julien-dubuc/Compliant-Gripper-Etextiles/gripper.webp

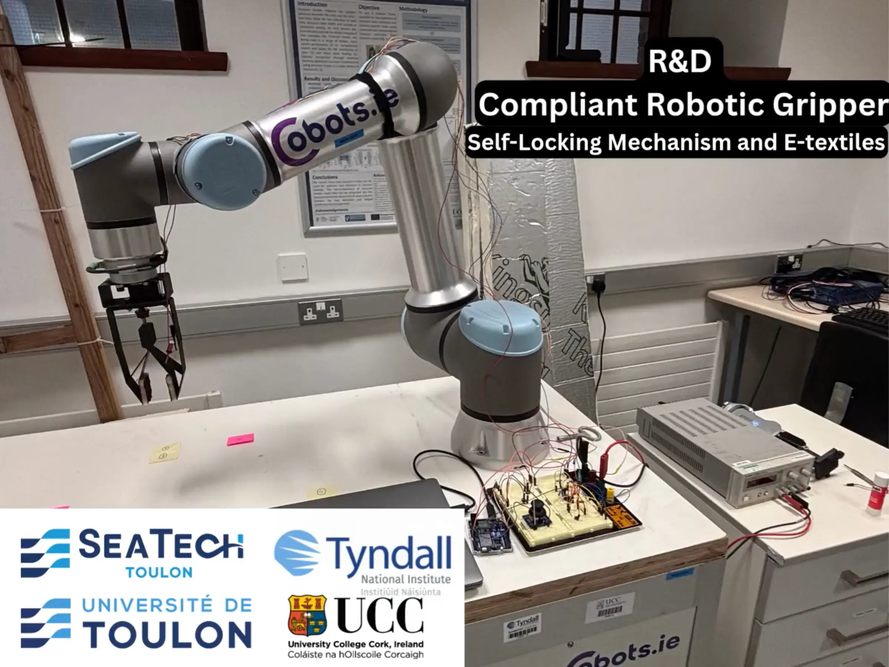
gripper.webp
