julien-dubuc/Compliant-Gripper-Etextiles/Weekly reports/11_Weekly _Report_04_08.pptx

## Development of an Underactuated Gripper for Soft Robotics with Tactile Capabilities Weekly Report

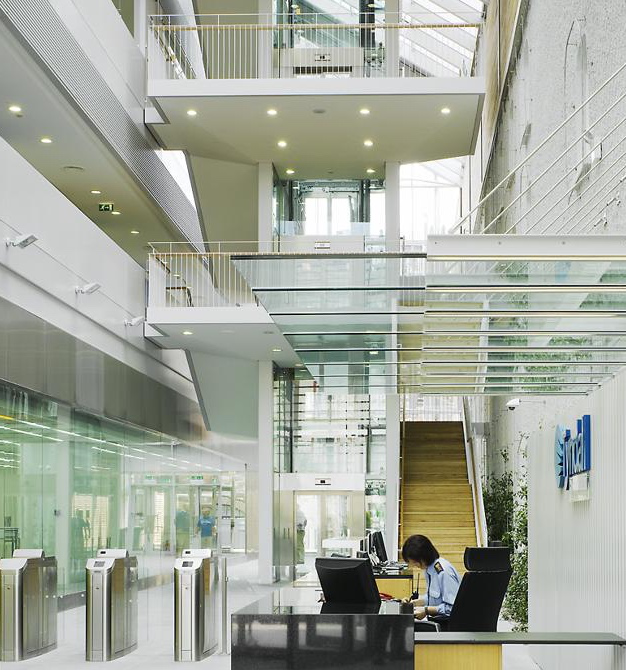
[picture p2: figure]

Julien Dubuc - BE at SeaTech (University of Toulon)

## Project Objectives (provisional)

- Objective 1 - Characterise e-textile sensing materials for robotic tactile applications
- Characterise the electromechanical response of selected e-textile materials under controlled loading conditions, with a focus on the relationship between applied force and electrical resistance. Assess repeatability, sensitivity, hysteresis, drift and practical suitability for integration into robotic tactile sensing systems.
- Objective 2 - Develop an e-textile tactile sensing glove for a robotic gripper/finger
- Design and fabricate a tactile sensing layer or glove for a robotic gripper finger using the characterised e-textile material. The sensing element should be mechanically robust, easy to mount, and capable of detecting contact and relative force changes during object interaction.
- Objective 3 - Build and validate a single-actuator robotic gripper prototype
- Produce a working single-actuator gripper that can close, lock and release objects consistently. The hardware should be clean, maintainable and suitable for repeated testing, with a short assembly, wiring and calibration guide provided.
- Objective 4 - Define and execute the experimental test protocol
- Define a small but representative test set using common objects with different shapes, sizes, stiffness and surface properties. Establish clear success criteria, such as successful grasp, stable hold, release reliability, tactile response consistency and energy use, and execute repeated trials under controlled conditions.

## Work Completed

- - Progress on the report & presentation

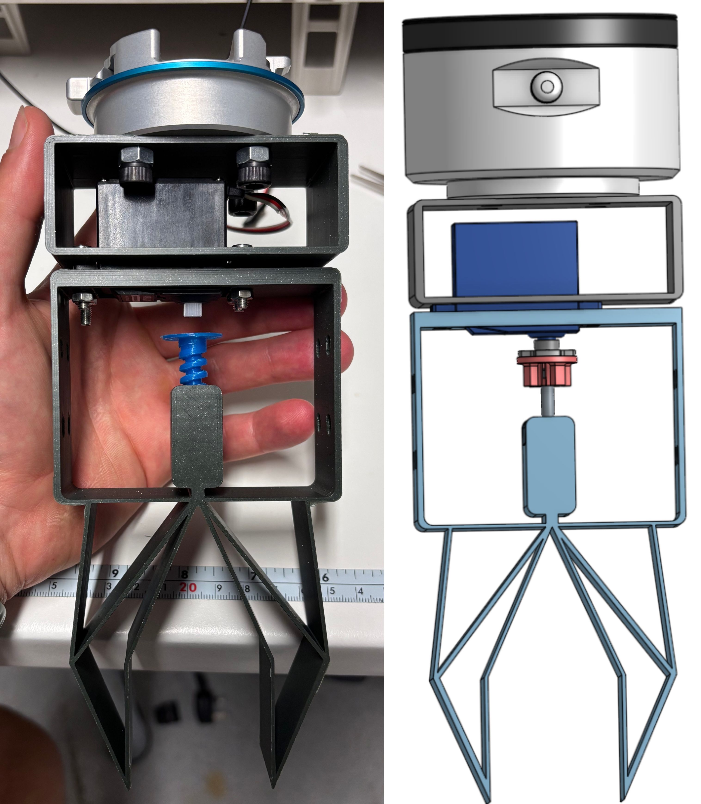
[picture p3: figure]

Design to attach the gripper to the robotic arm

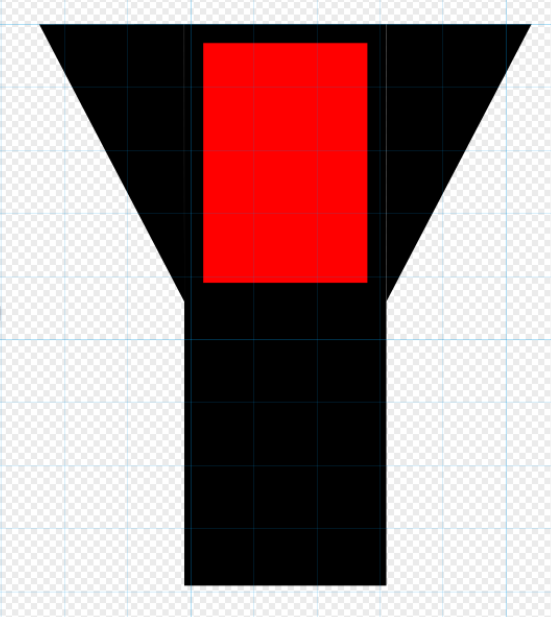
[picture p4: figure]
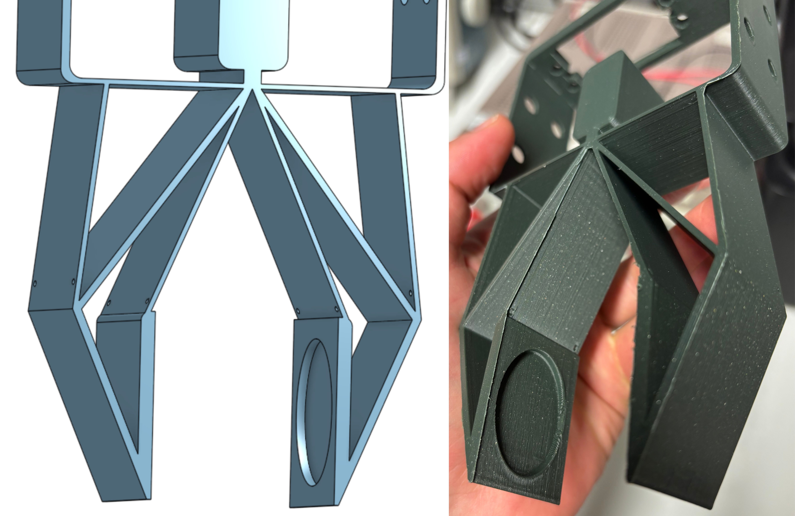
[picture p5: figure]

Design for gloves

2D Design of the gloves

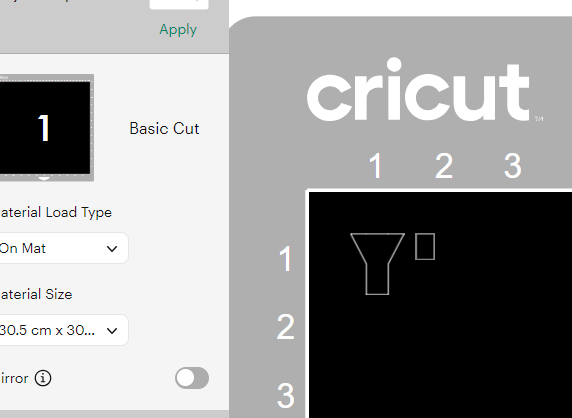
[picture p6: figure]

Cut the fabric on Cricut

## Problems/Challenges

- E-textiles
- What kind of fabric is used for the gloves? How to use the machines so I can start to build the gloves?
- Electronics for the robotic arm.
- After E-textiles, test the new idea design (if enough time)
- What do I need to do for the paper ? (Test, write sthg, create accounts on research sites, ..)

## Admin

- x

## Slide 6

Tyndall National Institute,
Lee Maltings,
Dyke Parade,
Cork,
Ireland.
T12 R5CP
t: +353 21 490 4177
e: info@tyndall.ie
tyndall.ie
@tyndall-national-institute
@TyndallInstitut
@tyndall_institute
@TyndallInstitute
