julien-dubuc/Compliant-Gripper-Etextiles/Weekly reports/10_Weekly _Report_29_07.pptx

## Development of a Bioinspired Gripper for Soft Robotics with Tactile Capabilities Weekly Report


Julien Dubuc – BE at SeaTech (University of Toulon)

## Project Objectives (provisional)

- Objective 1 - Characterise e-textile sensing materials for robotic tactile applications
- Characterise the electromechanical response of selected e-textile materials under controlled loading conditions, with a focus on the relationship between applied force and electrical resistance. Assess repeatability, sensitivity, hysteresis, drift and practical suitability for integration into robotic tactile sensing systems.
- Objective 2 - Develop an e-textile tactile sensing glove for a robotic gripper/finger
- Design and fabricate a tactile sensing layer or glove for a robotic gripper finger using the characterised e-textile material. The sensing element should be mechanically robust, easy to mount, and capable of detecting contact and relative force changes during object interaction.
- Objective 3 - Build and validate a single-actuator robotic gripper prototype
- Produce a working single-actuator gripper that can close, lock and release objects consistently. The hardware should be clean, maintainable and suitable for repeated testing, with a short assembly, wiring and calibration guide provided.
- Objective 4 - Define and execute the experimental test protocol
- Define a small but representative test set using common objects with different shapes, sizes, stiffness and surface properties. Establish clear success criteria, such as successful grasp, stable hold, release reliability, tactile response consistency and energy use, and execute repeated trials under controlled conditions.

## Work Completed

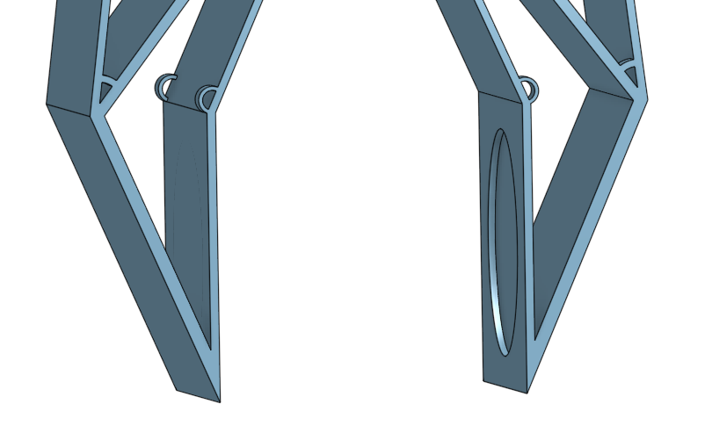
[picture p7: figure]

Idea 2: To attach the gloves to the fingers

- - Progress on the report & presentation

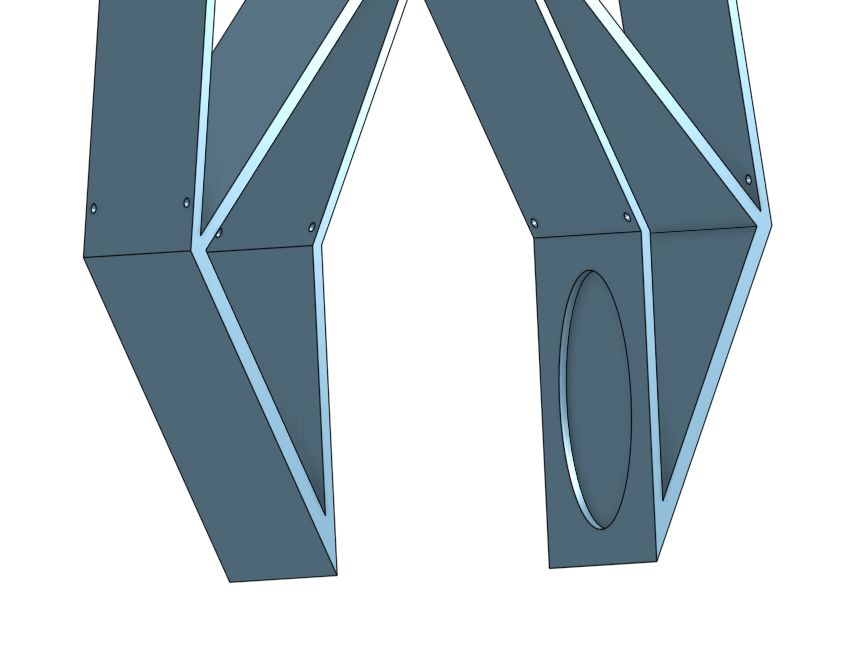
[picture p8: figure]

Idea 1: To attach the gloves to the fingers

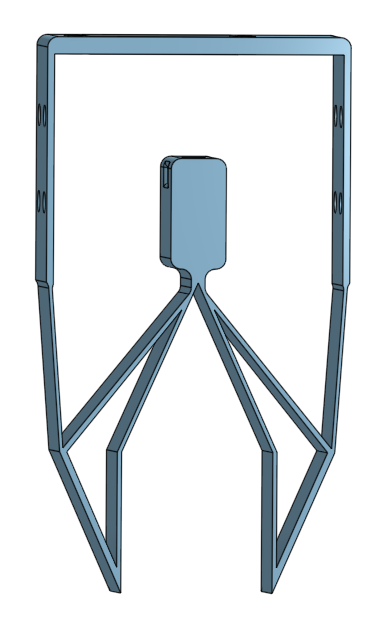
[picture p9: figure]

New idea to improve the gripper

## Problems/Challenges

- What will be the size of the wires that attach to the gripper?
- Exit Document
- Copyright on the report ? / Where do I store the data ?
- It would be great to take a photo of the gripper on the robotic arm to the first page of the report.
- Check the vocabulary in the report.

## Admin

- x

## Slide 6

Tyndall National Institute,
Lee Maltings,
Dyke Parade,
Cork,
Ireland.
T12 R5CP
t: +353 21 490 4177
e: info@tyndall.ie
tyndall.ie
@tyndall-national-institute
@TyndallInstitut
@tyndall_institute
@TyndallInstitute
