julien-dubuc/Compliant-Gripper-Etextiles/Internship Presentation EN.pdf

# Development of a Compliant Robotic Gripper

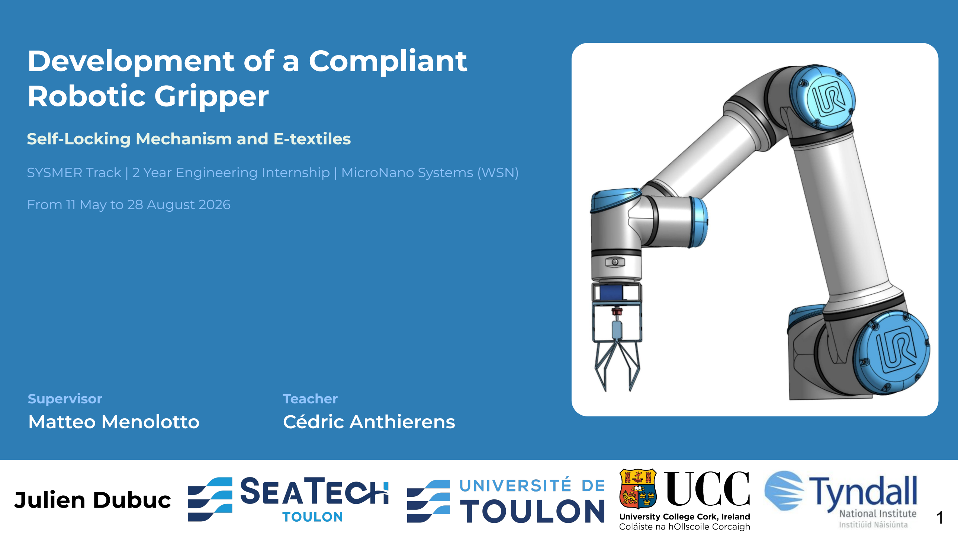
[picture p33: page 1]

Self-Locking Mechanism and E-textiles

SYSMER Track | 2 Year Engineering Internship | MicroNano Systems (WSN)

From 11 May to 28 August 2026

## Julien Dubuc

Supervisor

### Matteo Menolotto

Teacher

### Cédric Anthierens

# Problem & Goal

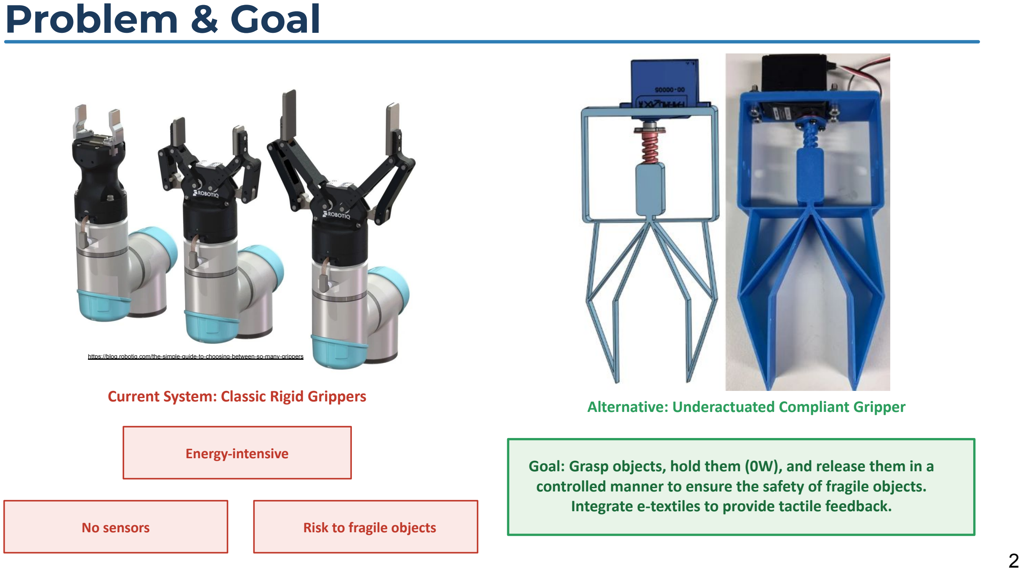
[picture p34: page 2]

Current System: Classic Rigid Grippers | Alternative: Underactuated Compliant Gripper

Energy-intensive

No sensors | Risk to fragile objects

Goal: Grasp objects, hold them (0W), and release them in a controlled manner to ensure the safety of fragile objects. Integrate e-textiles to provide tactile feedback.

https://blog.robotiq.com/the-simple-guide-to-choosing-between-so-many-grippers

# CAD Prototypes

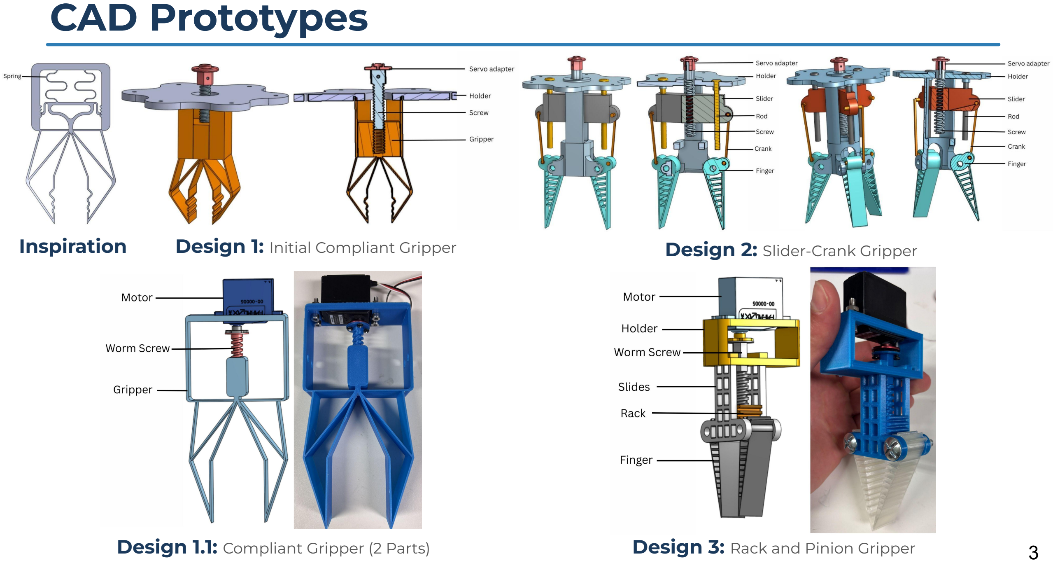
[picture p35: page 3]

Design 1: Initial Compliant Gripper

Design 1.1: Compliant Gripper (2 Parts)

Inspiration | Design 2: Slider-Crank Gripper

Design 3: Rack and Pinion Gripper

# Fabrication & Iteration

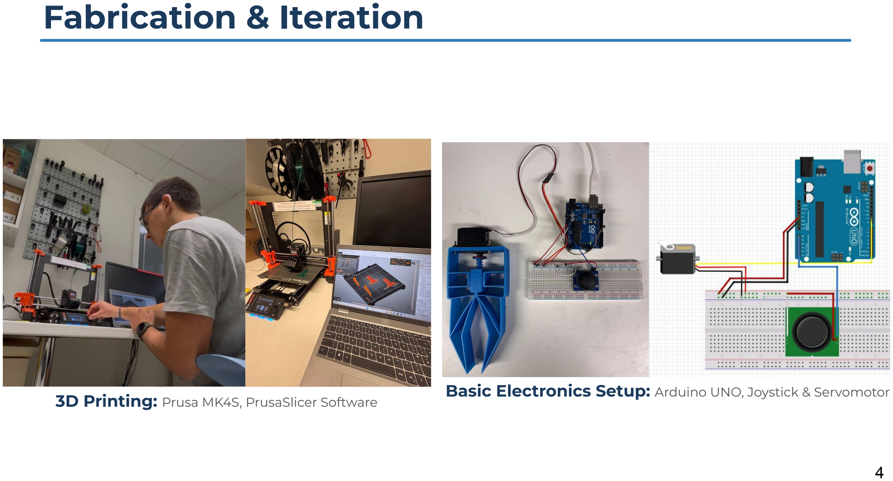
[picture p36: page 4]

3D Printing: Prusa MK4S, PrusaSlicer Software

Basic Electronics Setup: Arduino UNO, Joystick & Servomotor

# Protocol Assessment & Setup

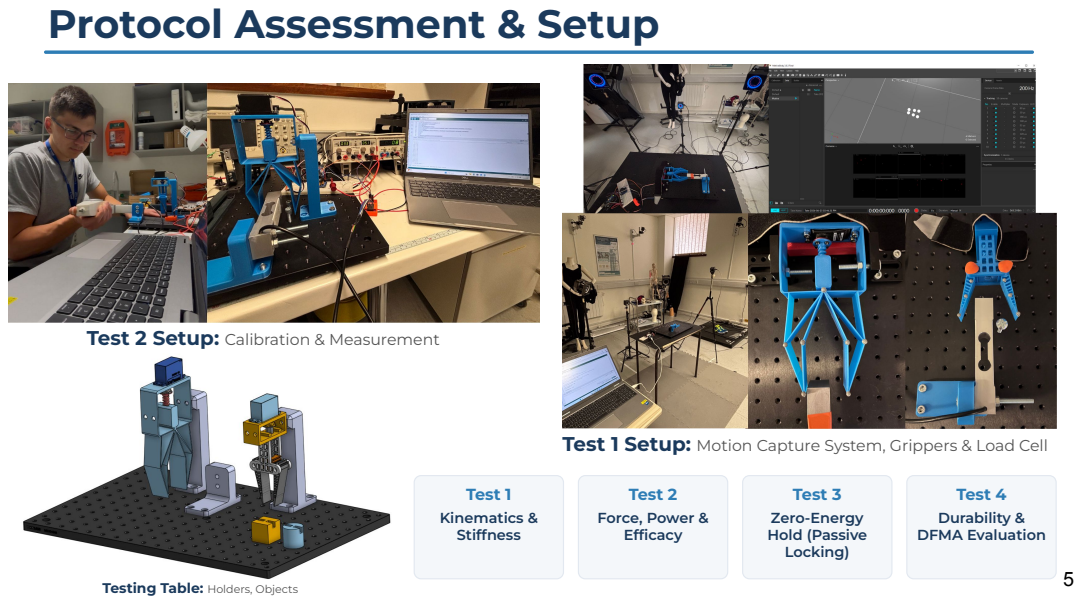
[picture p37: page 5]
Test 1 Kinematics & Stiffness; Test 2 Force, Power & Efficacy; Test 3 Zero-Energy Hold (Passive Locking); Test 4 Durability & DFMA Evaluation

Test 2 Setup: Calibration & Measurement

Test 1 Setup: Motion Capture System, Grippers & Load Cell

Testing Table: Holders, Objects

# Key Results: Test 1 & 2

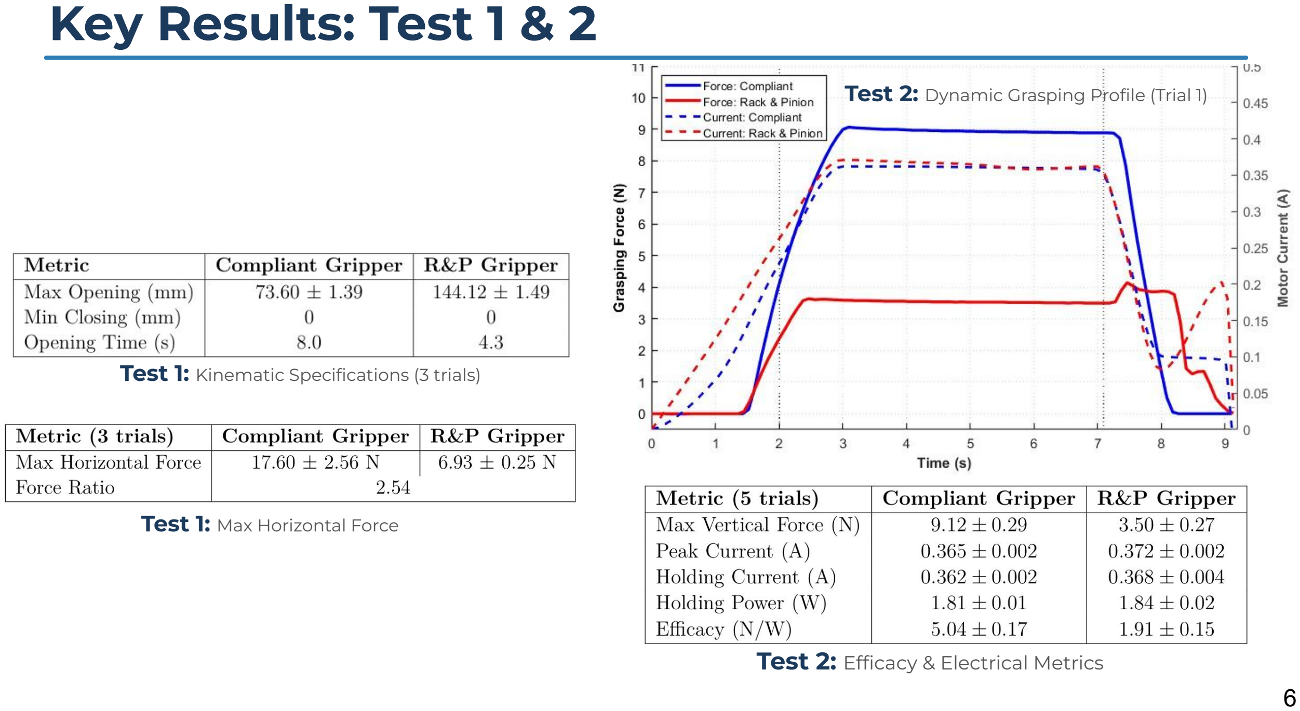
[picture p38: page 6]

Test 2: Efficacy & Electrical Metrics

Test 1: Max Horizontal Force

Test 1: Kinematic Specifications (3 trials)

Test 2: Dynamic Grasping Profile (Trial 1)

# Key Results: Test 3 & 4

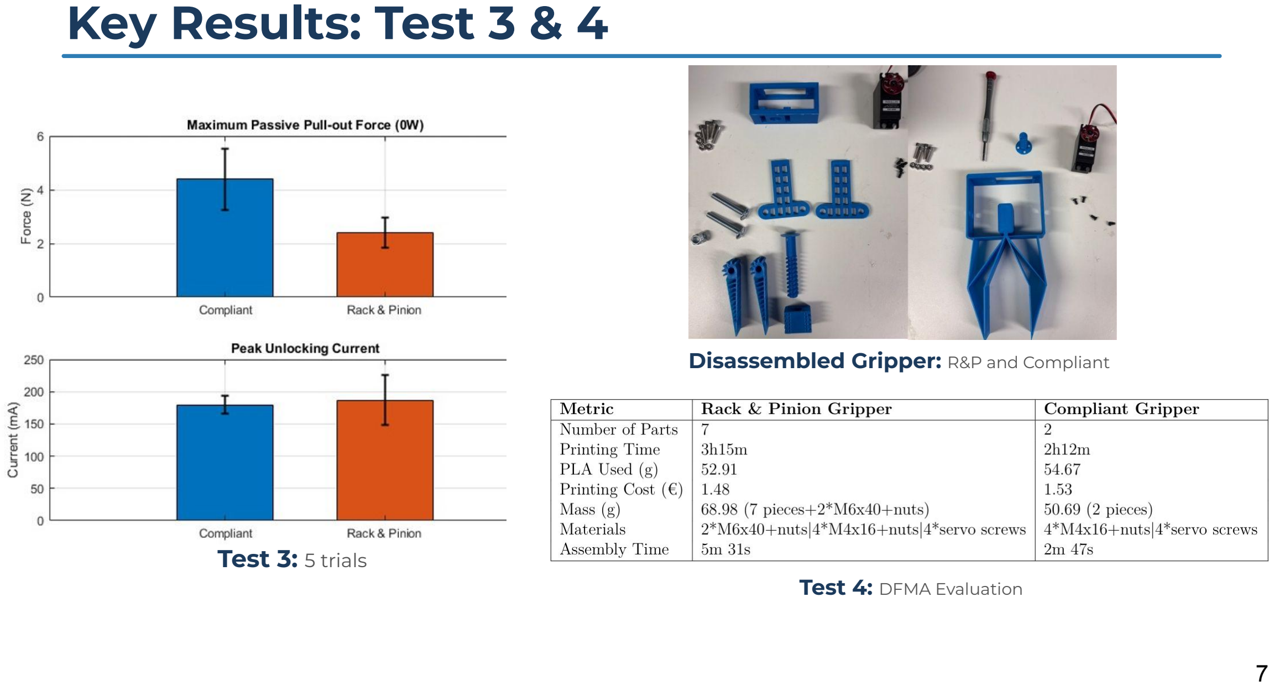
[picture p39: page 7]

Test 4: DFMA Evaluation

Test 3: 5 trials

Disassembled Gripper: R&P and Compliant

# Key Results: Compliant Gripper Optimization

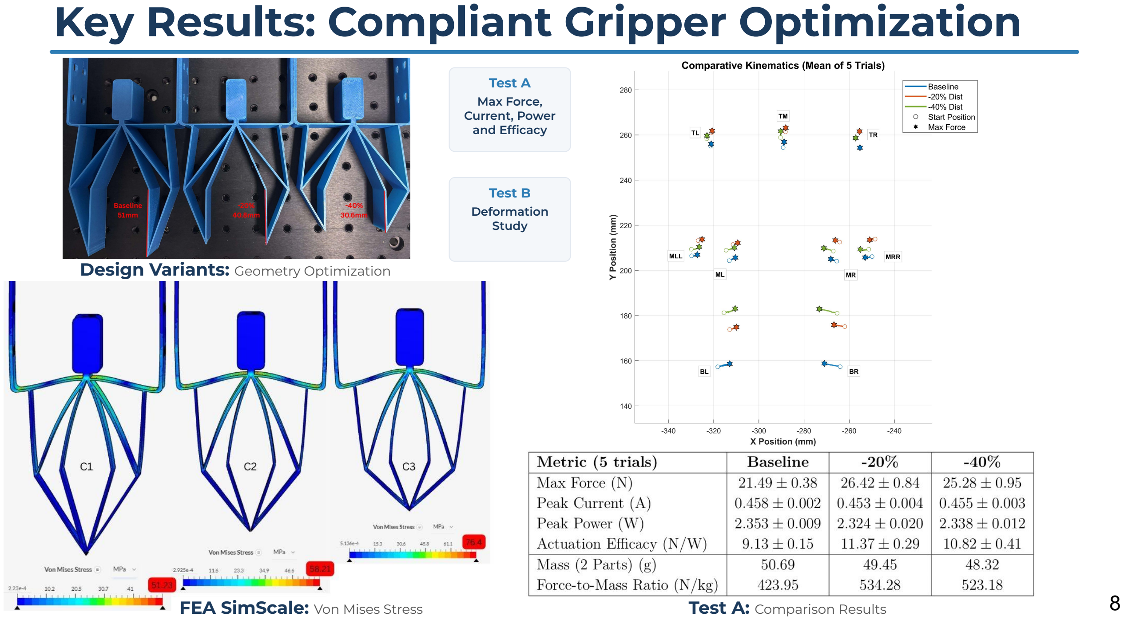
[picture p40: page 8]

Test B
Deformation
Study

Test A
Max Force,
Current, Power
and Efficacy
FEA SimScale: Von Mises Stress | Test A: Comparison Results

Design Variants: Geometry Optimization

# Key Results: Metal Transmission Optimization

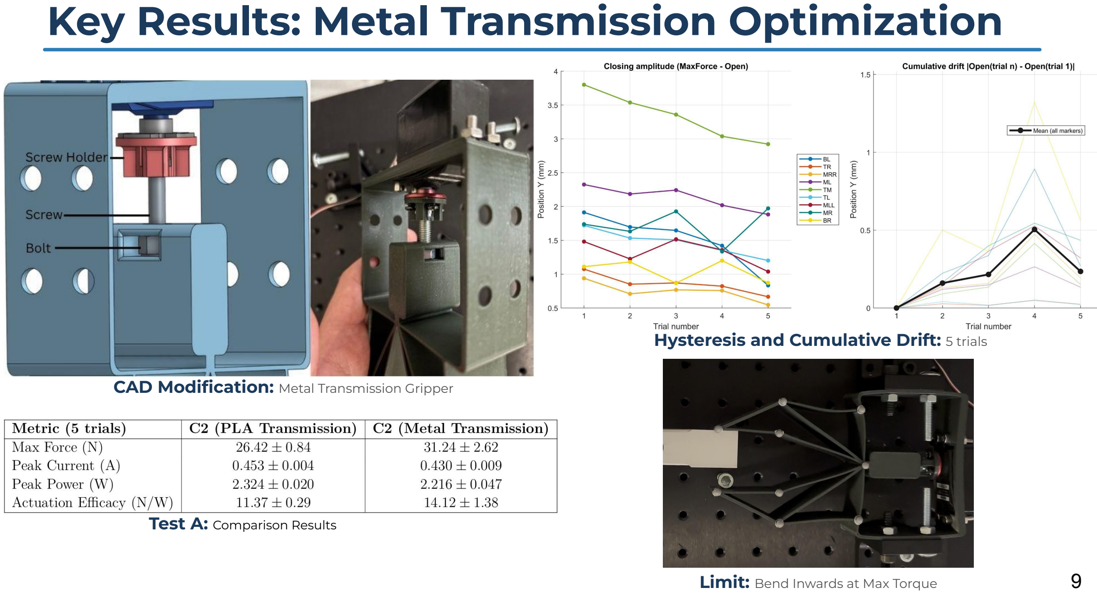
[picture p41: page 9]

Test A: Comparison Results

CAD Modification: Metal Transmission Gripper

Hysteresis and Cumulative Drift: 5 trials

Limit: Bend Inwards at Max Torque

# E-textiles & Integration

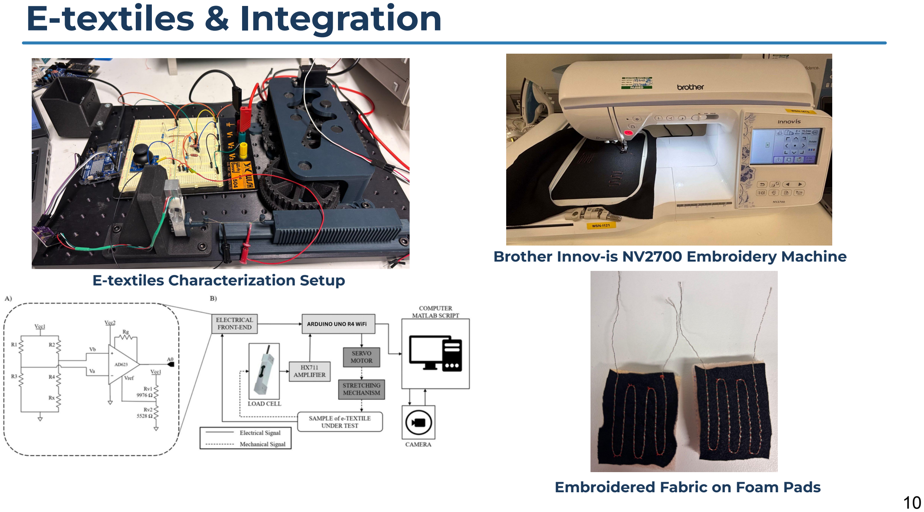
[picture p42: page 10]

E-textiles Characterization Setup

Brother Innov-is NV2700 Embroidery Machine

Embroidered Fabric on Foam Pads

# Next steps

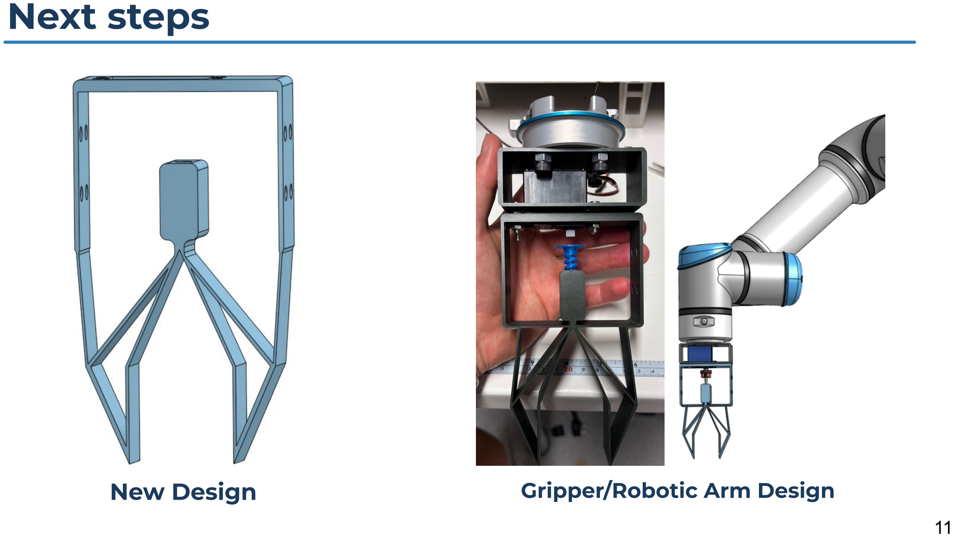
[picture p43: page 11]

New Design | Gripper/Robotic Arm Design

# Thank you Questions ?

# Appendix

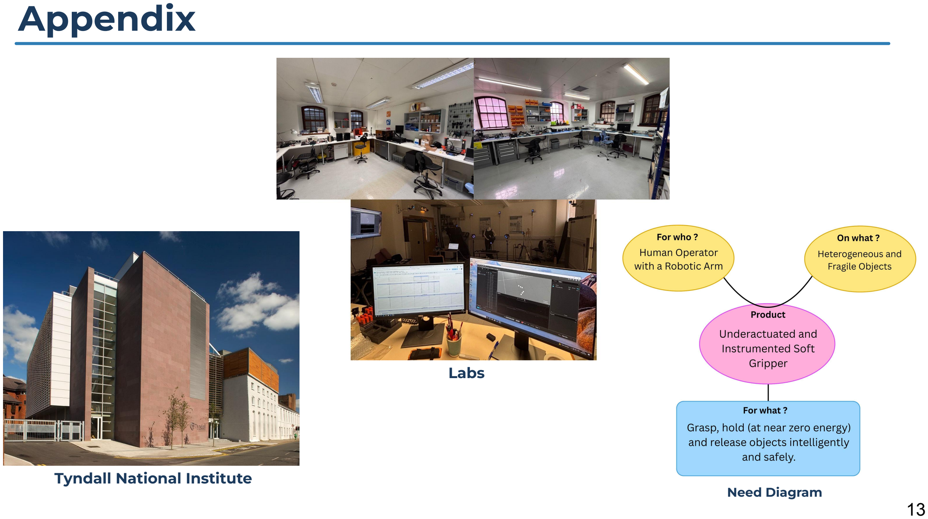
[picture p44: page 13]

Labs

Need Diagram

Tyndall National Institute

# Appendix

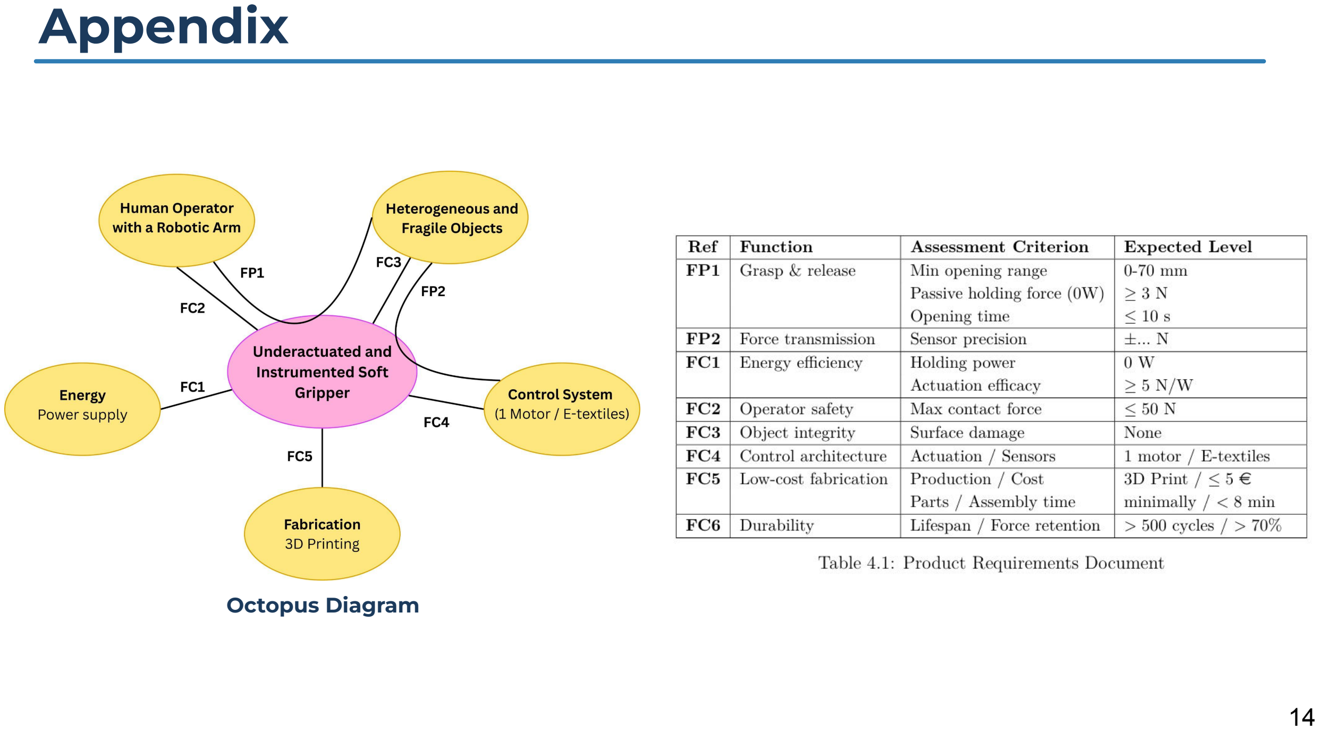
[picture p45: page 14]

Octopus Diagram

# Appendix

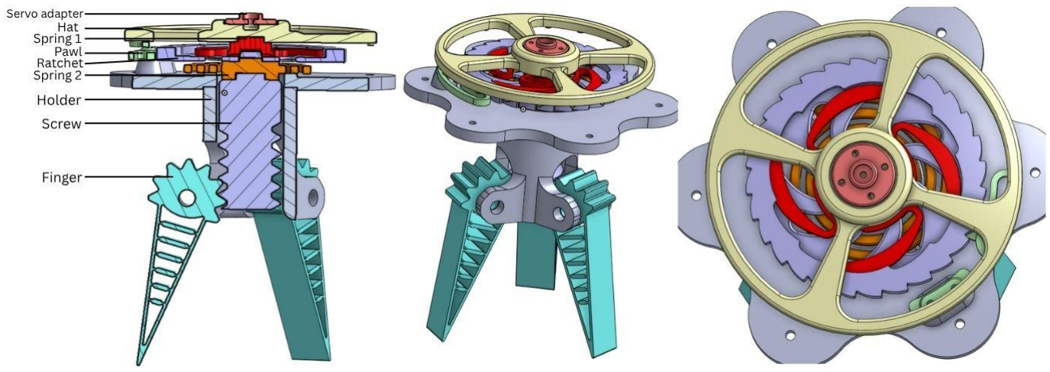
[picture p46: figure]

Previous Lab Design

# Appendix

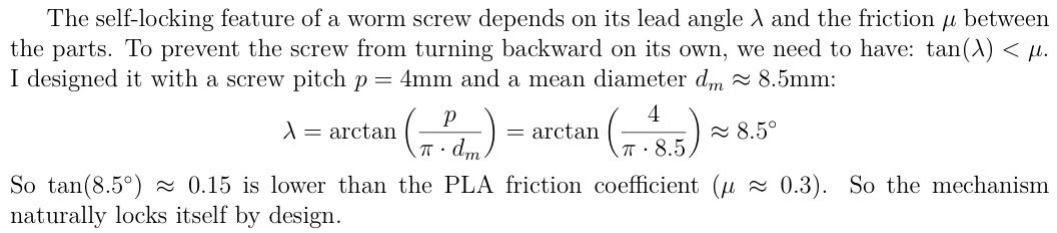
[picture p47: figure]

Self-Locking Principle

# Appendix

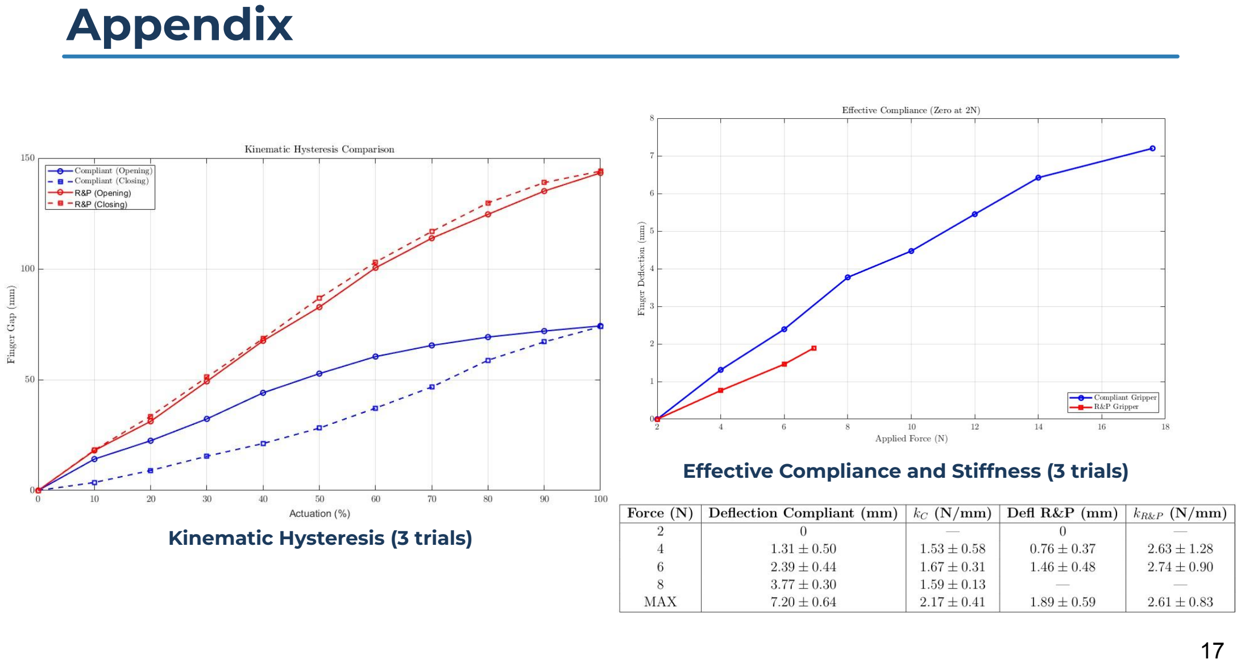
[picture p48: page 17]

Effective Compliance and Stiffness (3 trials)

Kinematic Hysteresis (3 trials)

# Appendix

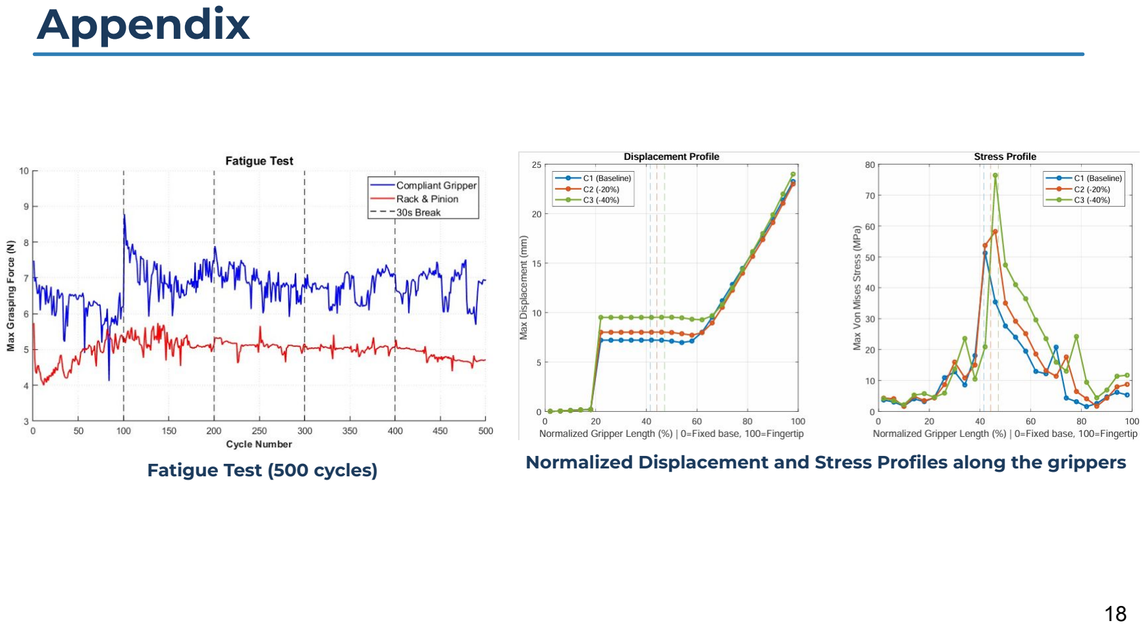
[picture p49: page 18]

Normalized Displacement and Stress Profiles along the grippers Fatigue Test (500 cycles)

# Appendix

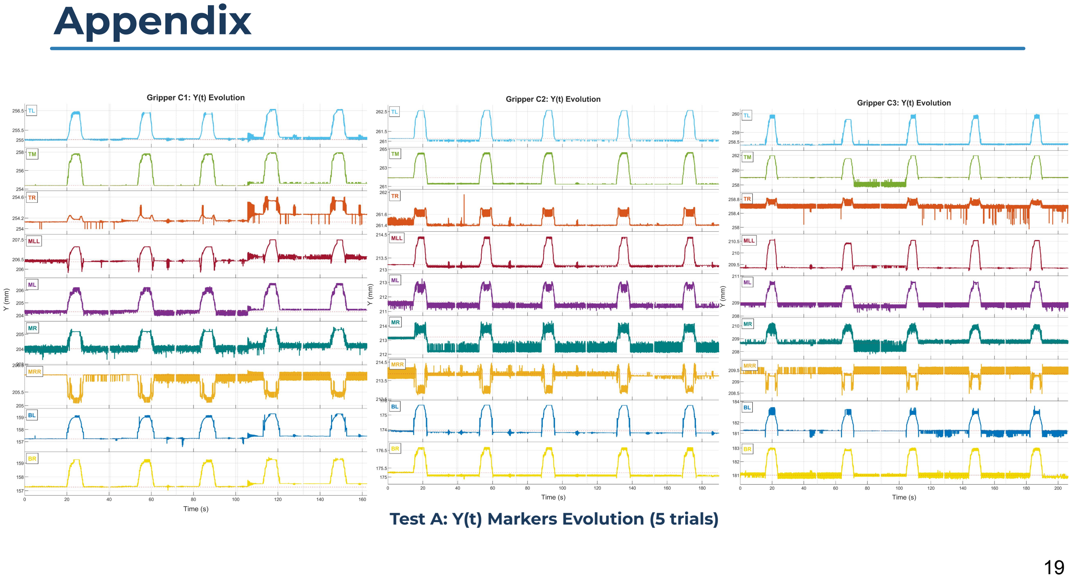
[picture p50: page 19]

Test A: Y(t) Markers Evolution (5 trials)

# Appendix

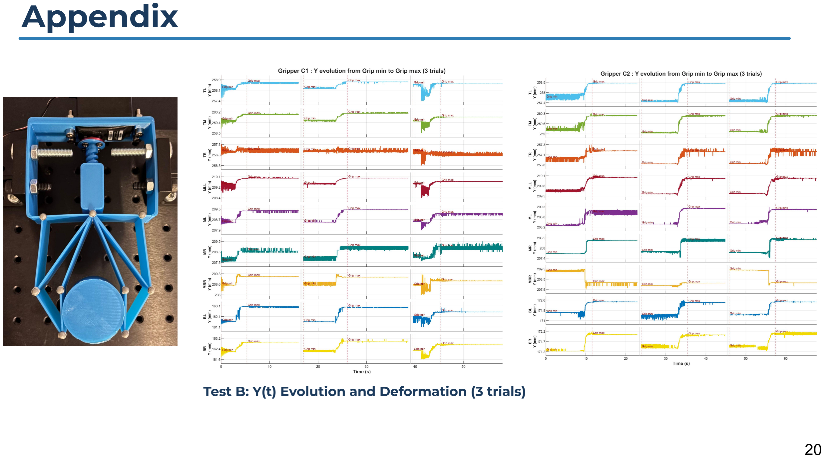
[picture p51: page 20]

Test B: Y(t) Evolution and Deformation (3 trials)

# Appendix

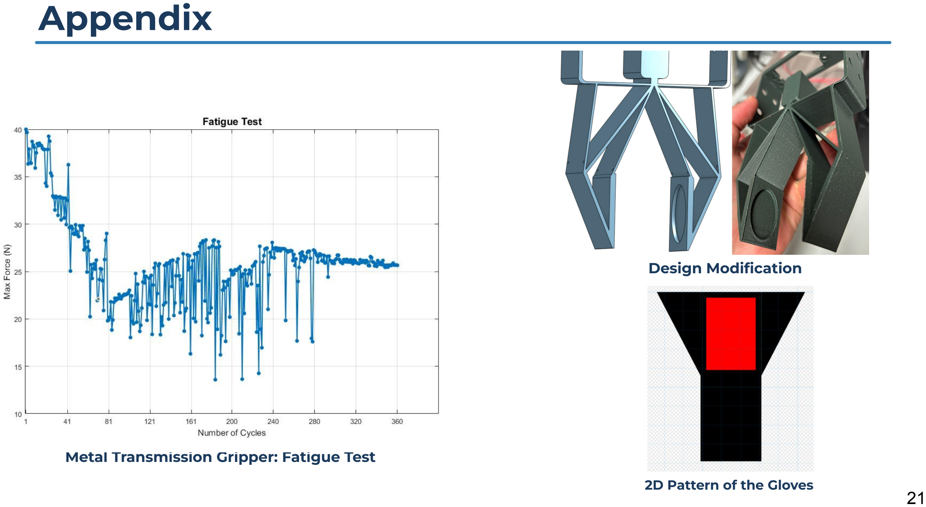
[picture p52: page 21]

Metal Transmission Gripper: Fatigue Test

2D Pattern of the Gloves

Design Modification

# Appendix

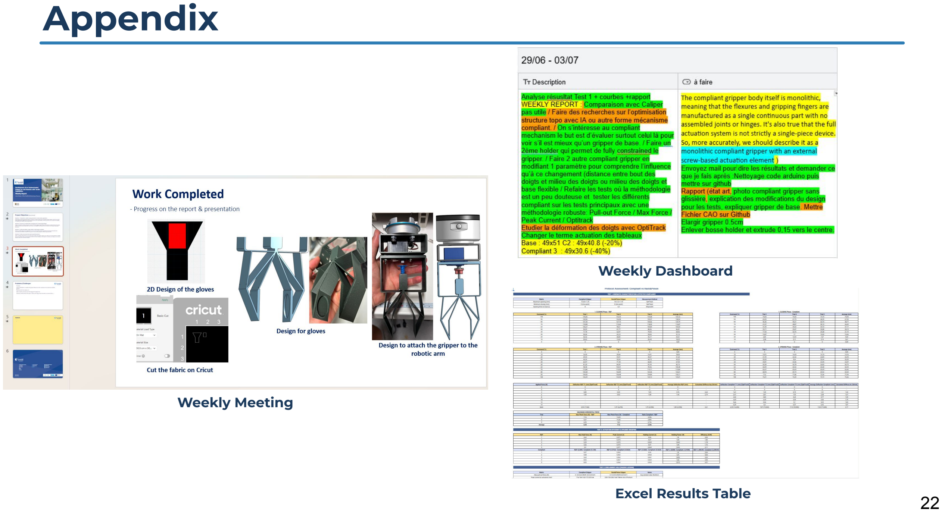
[picture p53: page 22]

Weekly Dashboard

Excel Results Table

Weekly Meeting

# Appendix

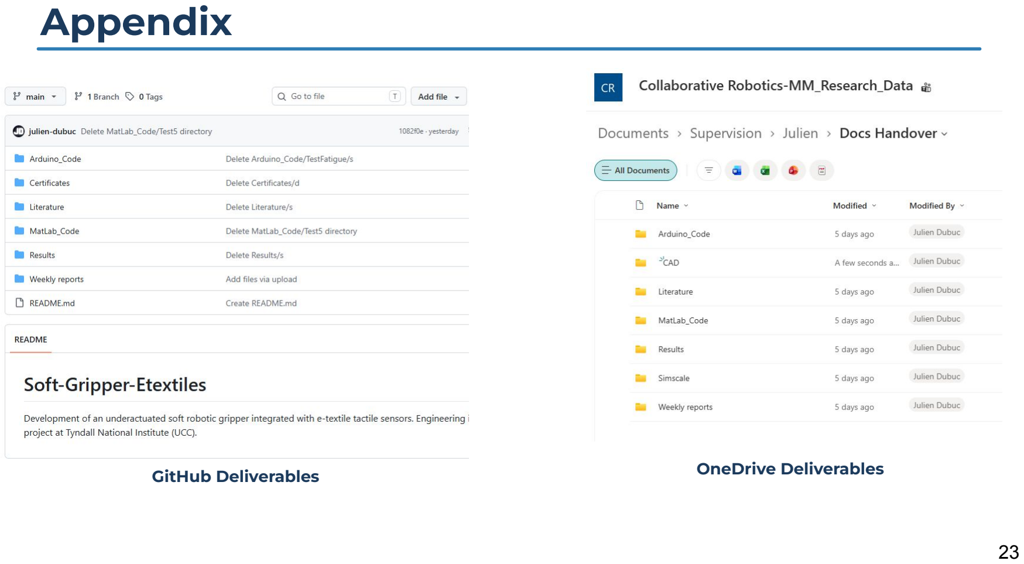
[picture p54: page 23]

GitHub Deliverables | OneDrive Deliverables
