julien-dubuc/Compliant-Gripper-Etextiles/Internship Presentation FR.pdf

# Développement d'un Gripper Robotique Souple

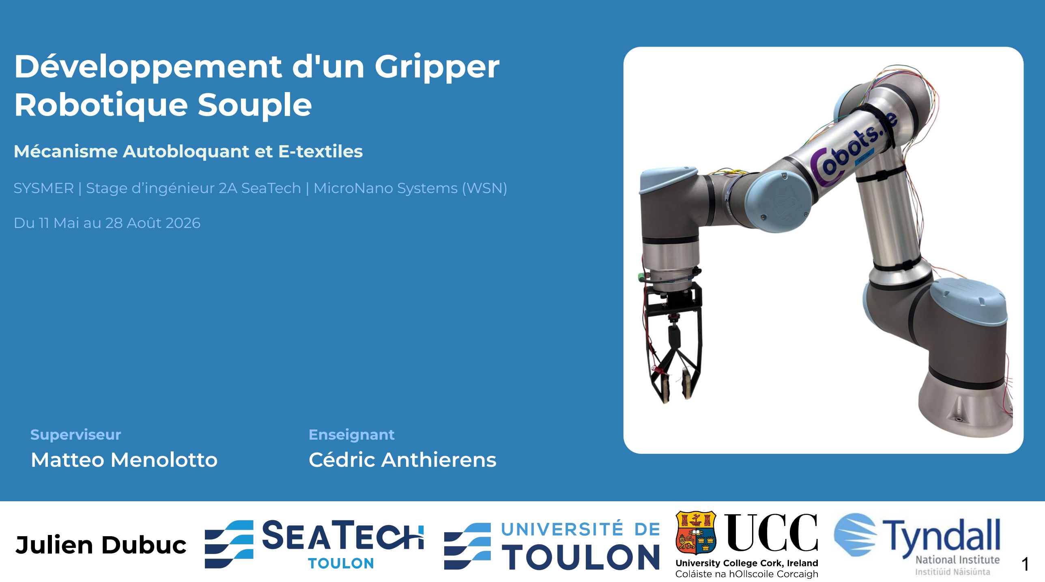
[picture p55: page 1]

Mécanisme Autobloquant et E-textiles

SYSMER | Stage d’ingénieur 2A SeaTech | MicroNano Systems (WSN)

Du 11 Mai au 28 Août 2026

## Julien Dubuc

Superviseur

### Matteo Menolotto

Enseignant

### Cédric Anthierens

# Contexte

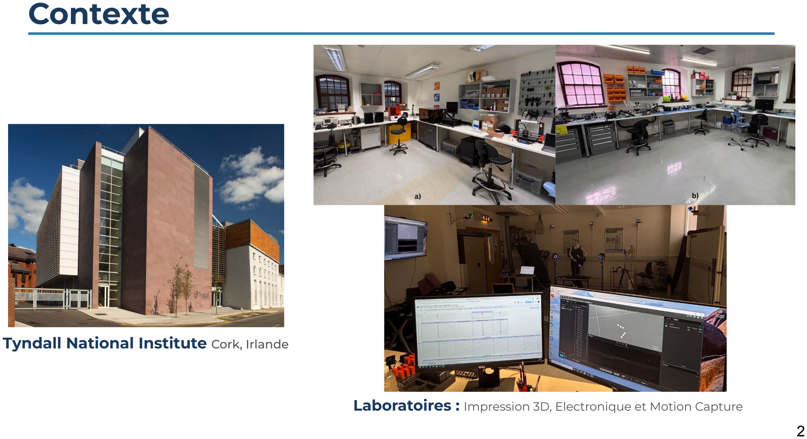
[picture p56: page 2]

### Tyndall National Institute Cork, Irlande

Laboratoires : Impression 3D, Electronique et Motion Capture

# Problème & But

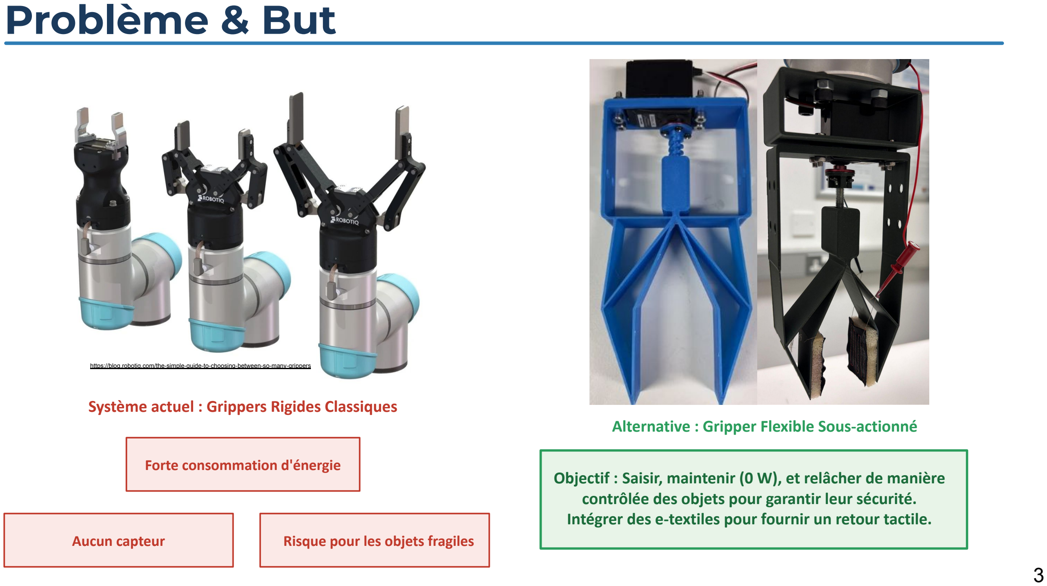
[picture p57: page 3]

Système actuel : Grippers Rigides Classiques Alternative : Gripper Flexible Sous-actionné

Forte consommation d'énergie

Aucun capteur | Risque pour les objets fragiles

Objectif : Saisir, maintenir (0 W), et relâcher de manière contrôlée des objets pour garantir leur sécurité. Intégrer des e-textiles pour fournir un retour tactile.

https://blog.robotiq.com/the-simple-guide-to-choosing-between-so-many-grippers

# Itérations CAO

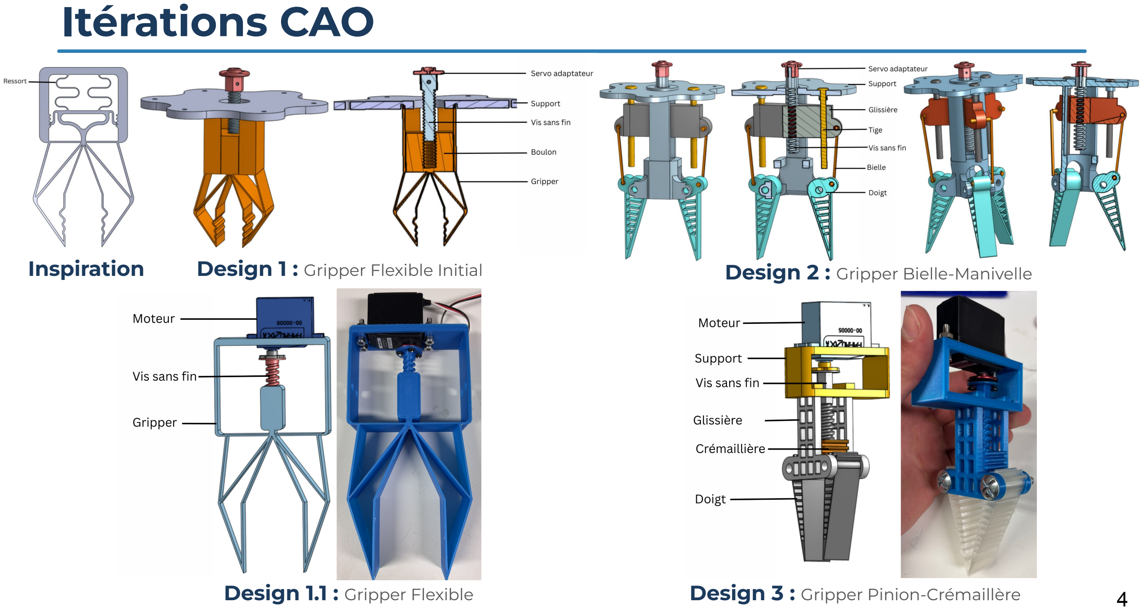
[picture p58: page 4]

Design 1 : Gripper Flexible Initial

Design 1.1 : Gripper Flexible

Inspiration | Design 2 : Gripper Bielle-Manivelle

Design 3 : Gripper Pinion-Crémaillère

# Fabrication & Itération

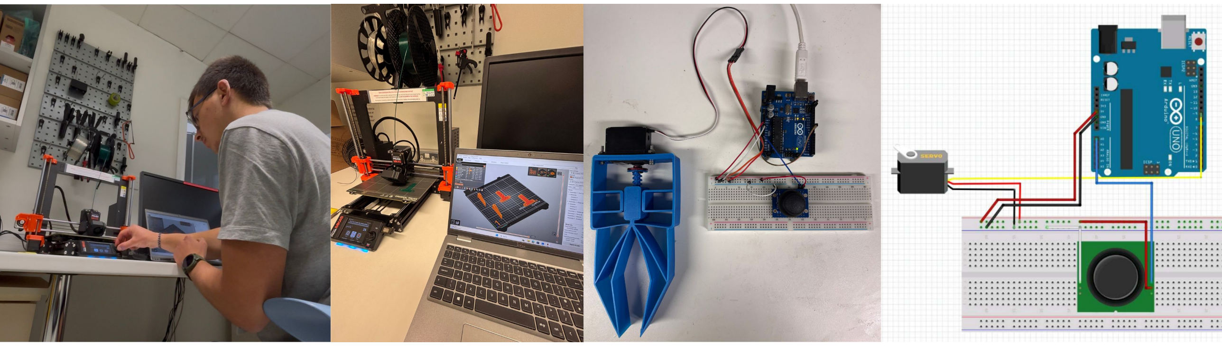
[picture p59: figure]

Impression 3D : Prusa MK4S et PrusaSlicer | Setup Électronique : Arduino UNO, Joystick et Servo

# Protocole d’Evaluation & Setup

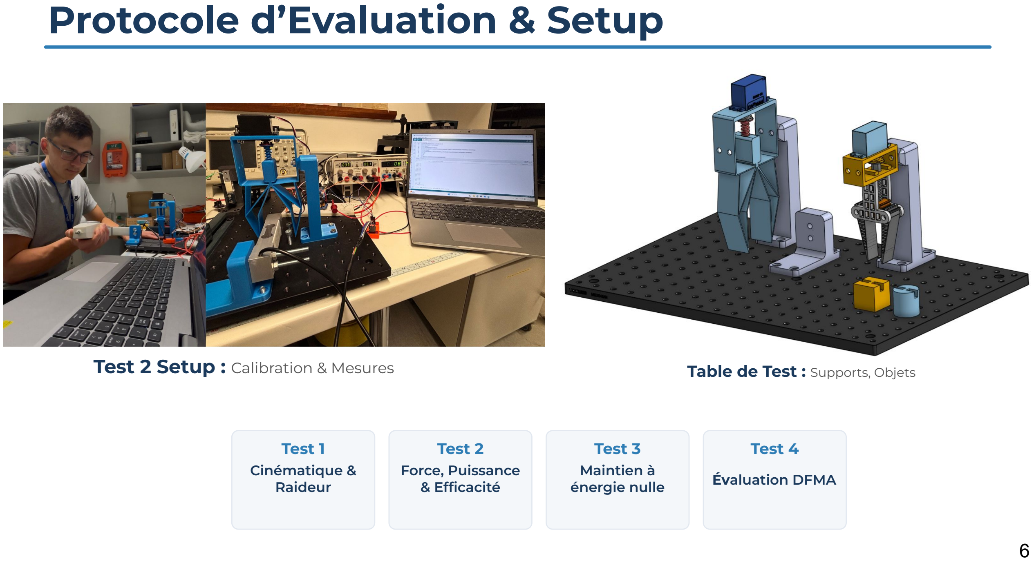
[picture p60: page 6]

Table de Test : Supports, Objets

Test 1
Cinématique &
Raideur

Test 2
Force, Puissance
& Efficacité

Test 3
Maintien à
énergie nulle

Test 4

Évaluation DFMA

Test 2 Setup : Calibration & Mesures

# Résultats Clés : Test 1 & 2

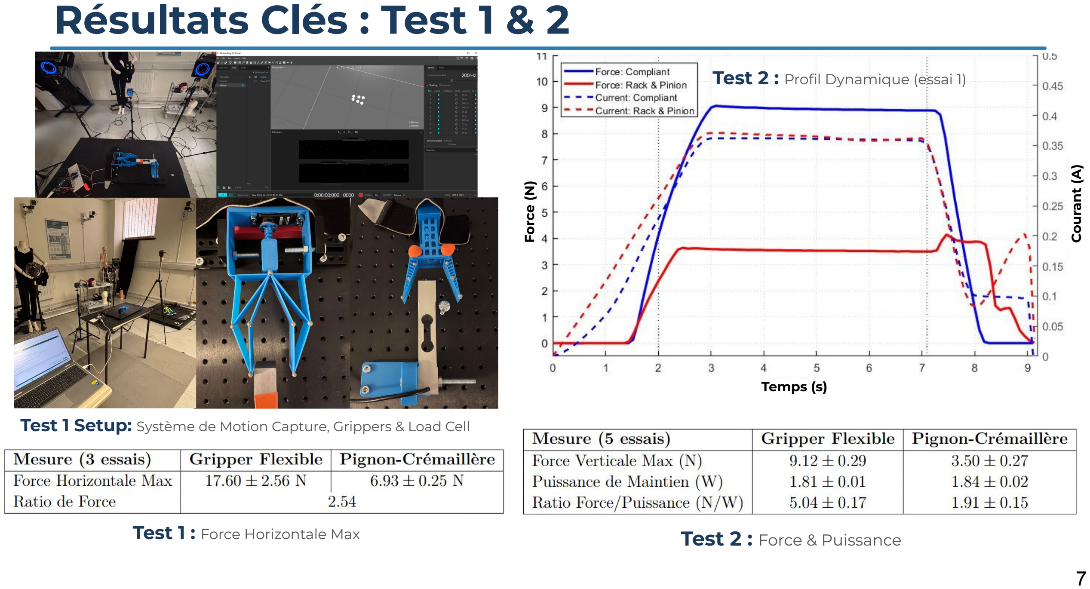
[picture p61: page 7]

Test 2 : Force & Puissance

Test 1 : Force Horizontale Max

Test 2 : Profil Dynamique (essai 1)

Test 1 Setup: Système de Motion Capture, Grippers & Load Cell

Temps (s)

Force (N)

Courant (A)

# Résultats Clés : Test 3 & 4

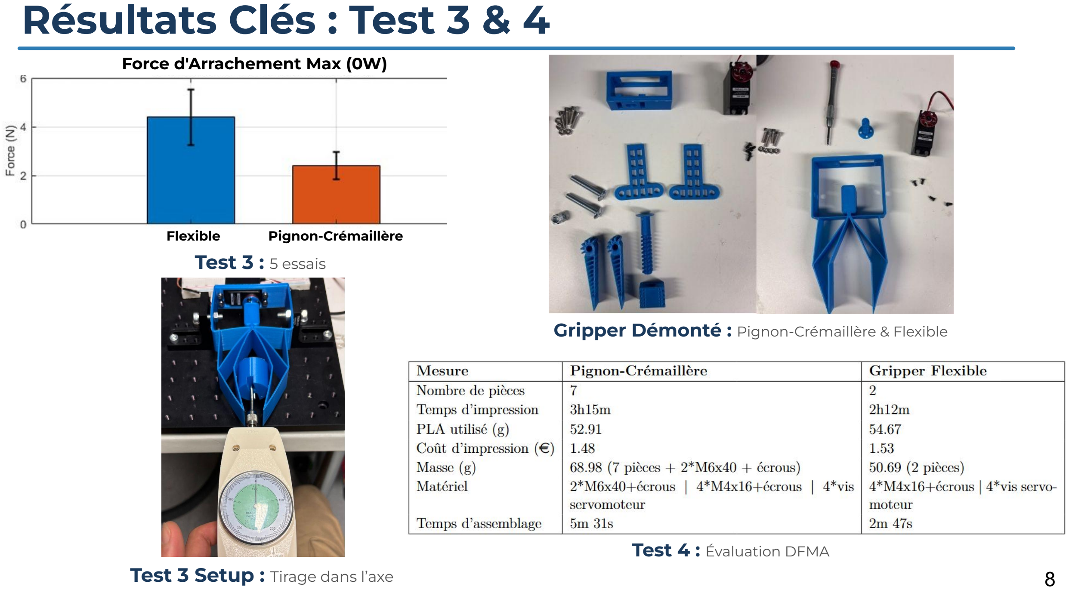
[picture p62: page 8]

Test 4 : Évaluation DFMA

Test 3 : 5 essais

Gripper Démonté : Pignon-Crémaillère & Flexible

Force d'Arrachement Max (0W)

Test 3 Setup : Tirage dans l’axe

Flexible Pignon-Crémaillère

# Optimisation Gripper Flexible

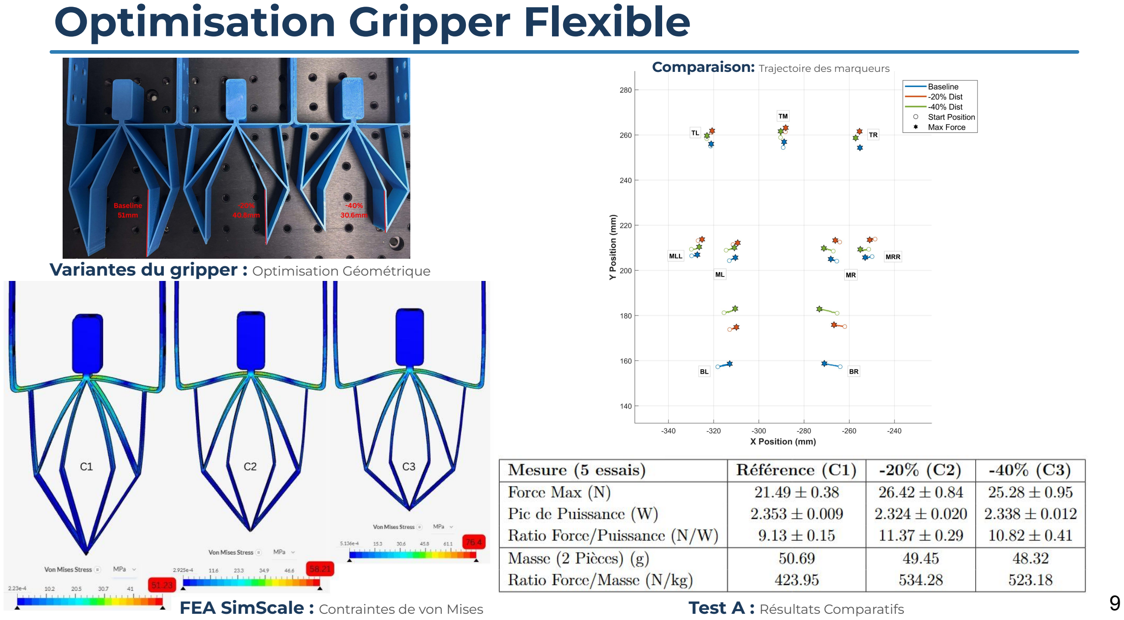
[picture p63: page 9]

FEA SimScale : Contraintes de von Mises | Test A : Résultats Comparatifs

Variantes du gripper : Optimisation Géométrique

Comparaison: Trajectoire des marqueurs

# Transmission Métallique

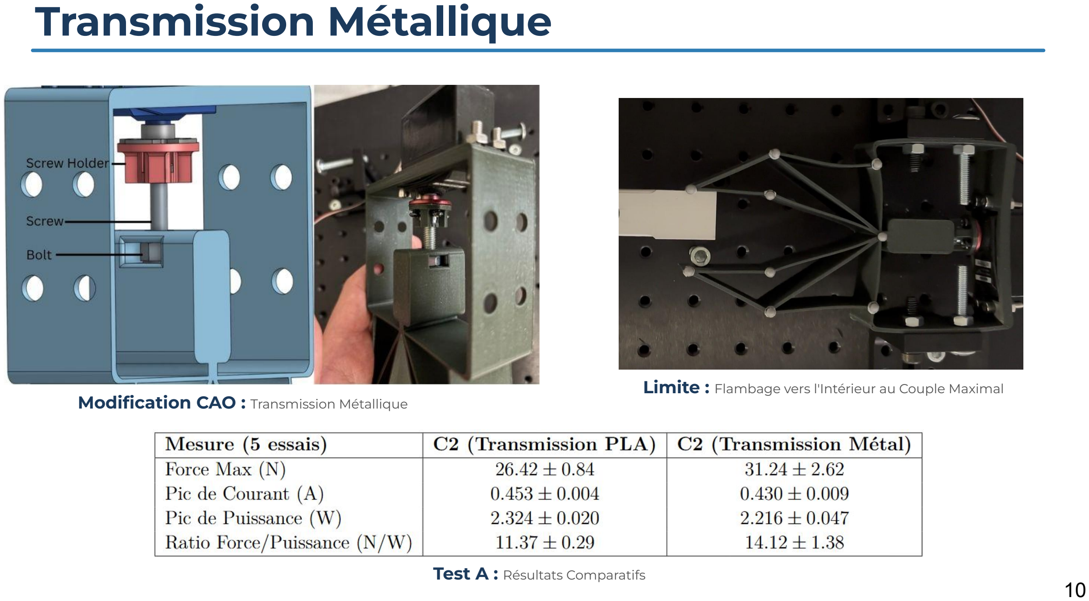
[picture p64: page 10]

Test A : Résultats Comparatifs

Modification CAO : Transmission Métallique

Limite : Flambage vers l'Intérieur au Couple Maximal

# Nouveau Design

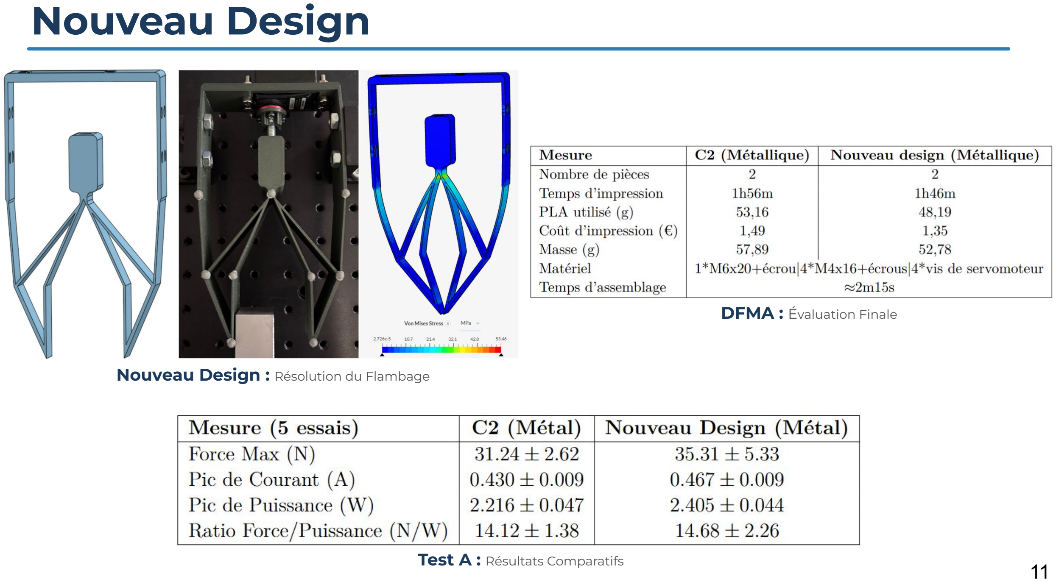
[picture p65: page 11]

Test A : Résultats Comparatifs

Nouveau Design : Résolution du Flambage

DFMA : Évaluation Finale

# Caractérisation des E-textiles

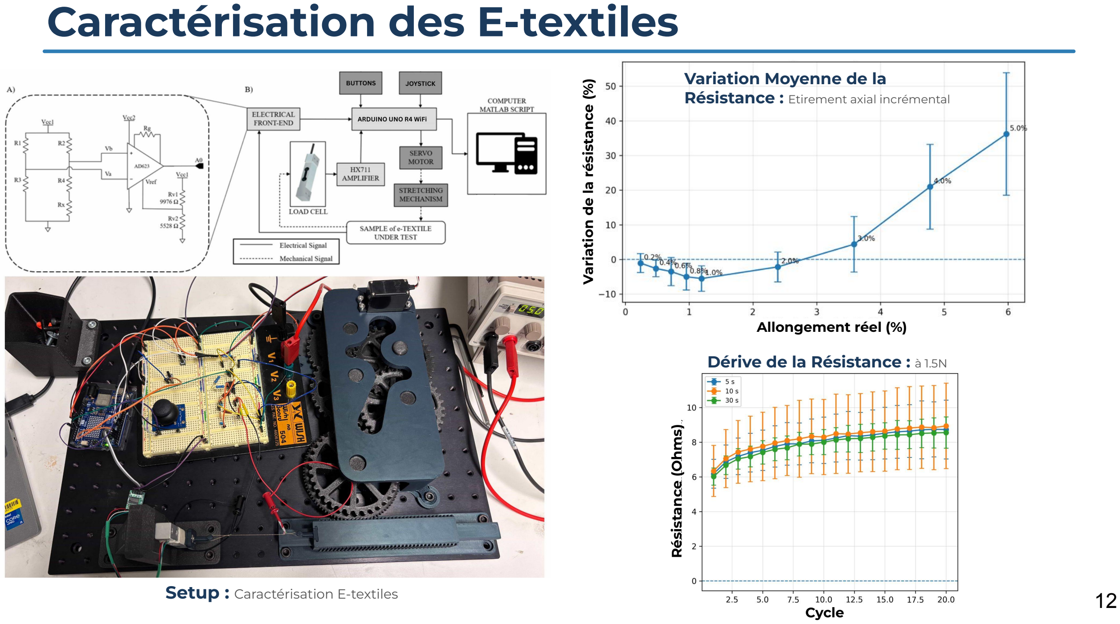
[picture p66: page 12]

Setup : Caractérisation E-textiles

| Allongement réel (%)
Dérive de la Résistance : à 1.5N

Variation de la résistance (%)

Résistance (Ohms)

Cycle

Variation Moyenne de la
Résistance : Etirement axial incrémental

# Intégration des E-textiles

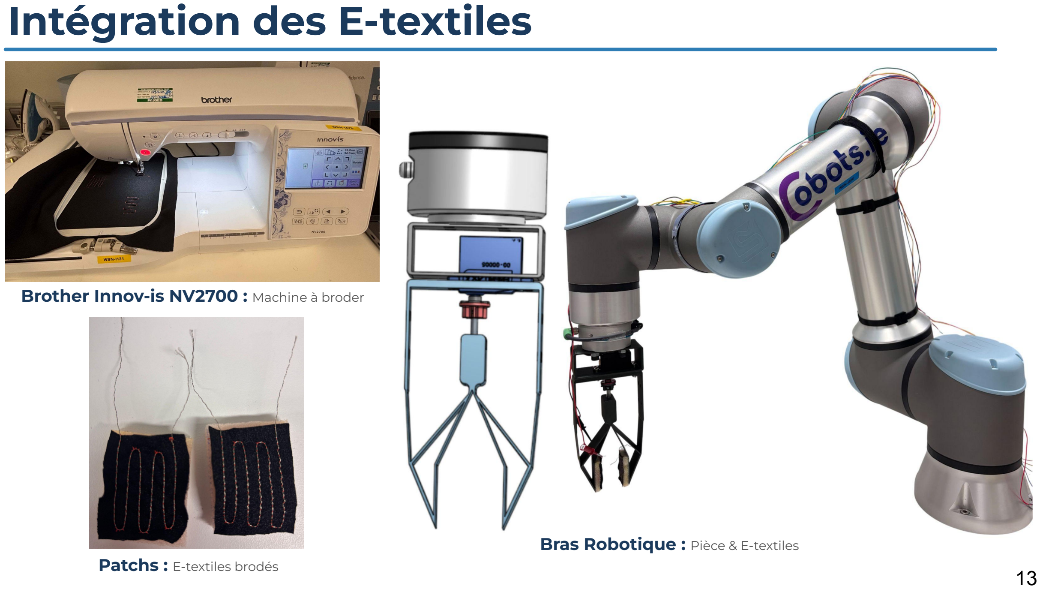
[picture p67: page 13]

Brother Innov-is NV2700 : Machine à broder

Patchs : E-textiles brodés

Bras Robotique : Pièce & E-textiles

# Tests Bras Robotique

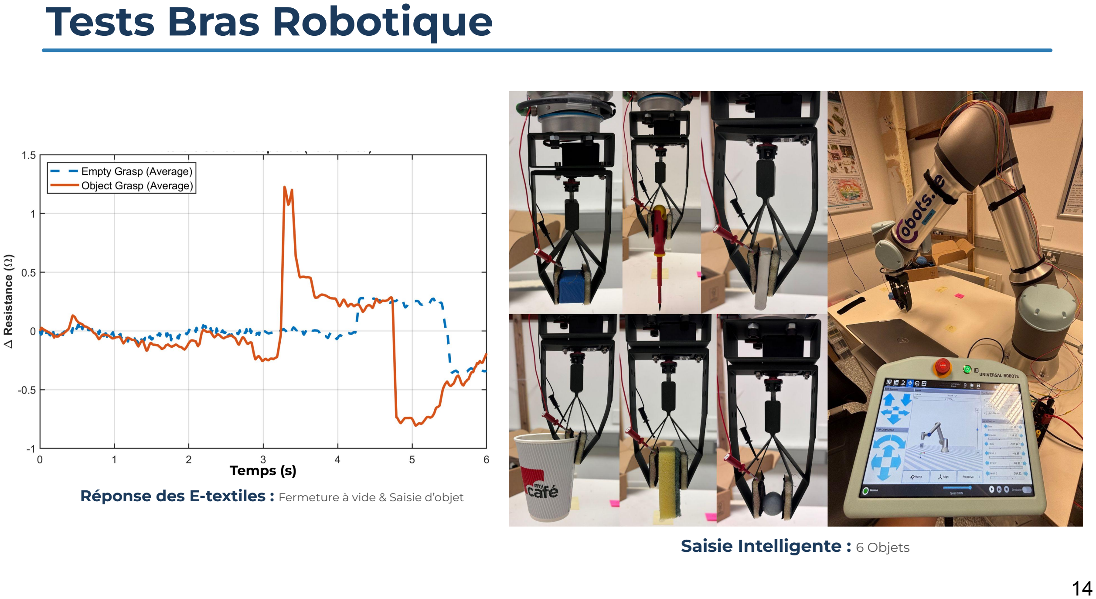
[picture p68: page 14]

Saisie Intelligente : 6 Objets

Réponse des E-textiles : Fermeture à vide & Saisie d’objet

Temps (s)

# Conclusion

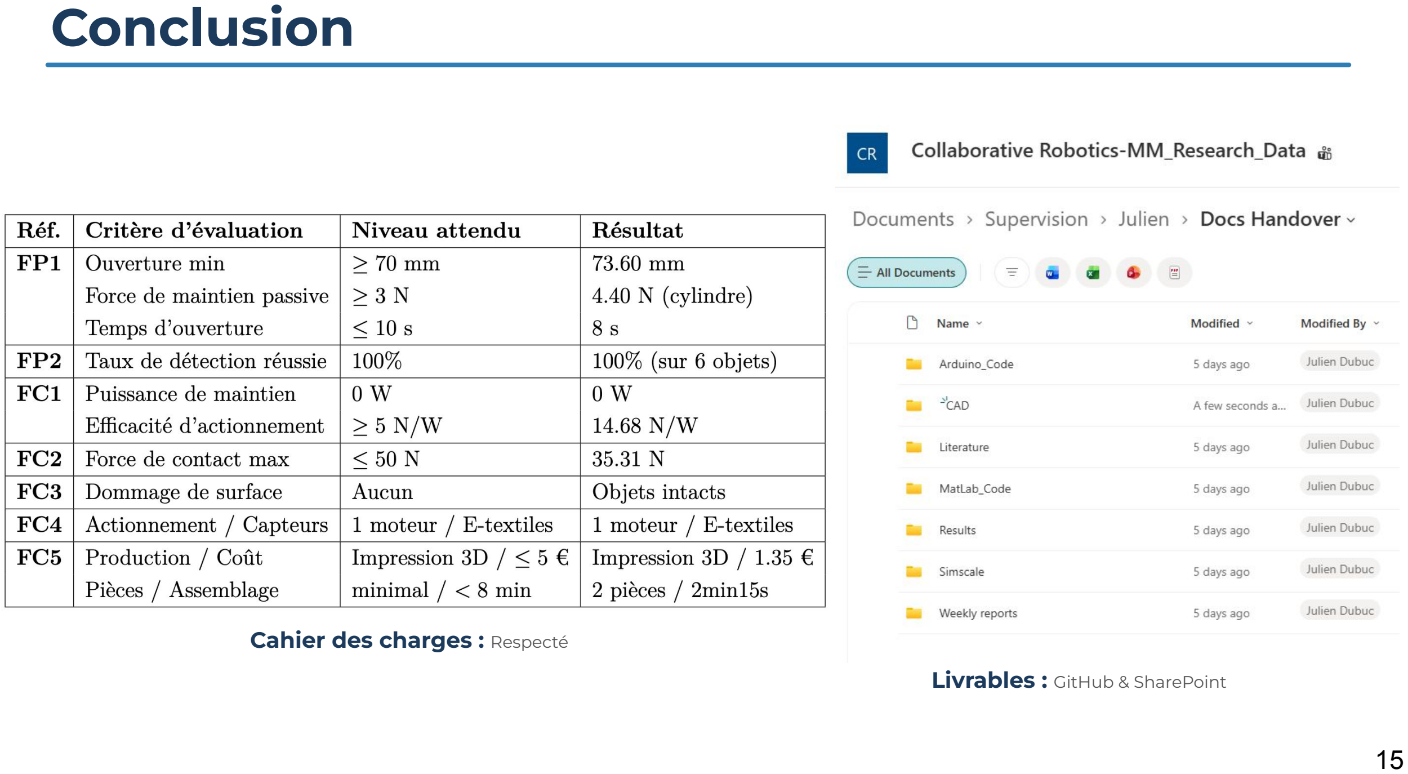
[picture p69: page 15]

Cahier des charges : Respecté

Livrables : GitHub & SharePoint

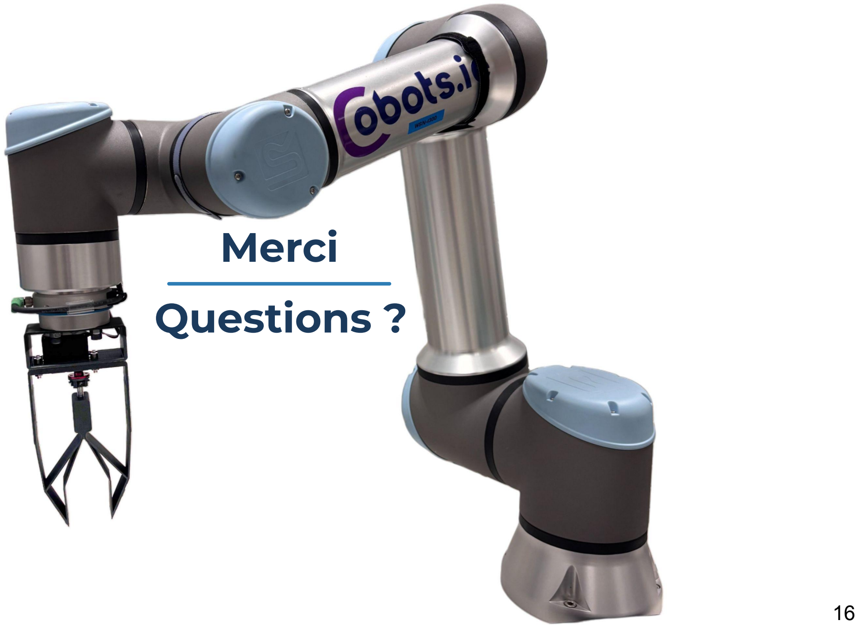
[picture p70: page 16]

# Merci Questions ?

# Annexe

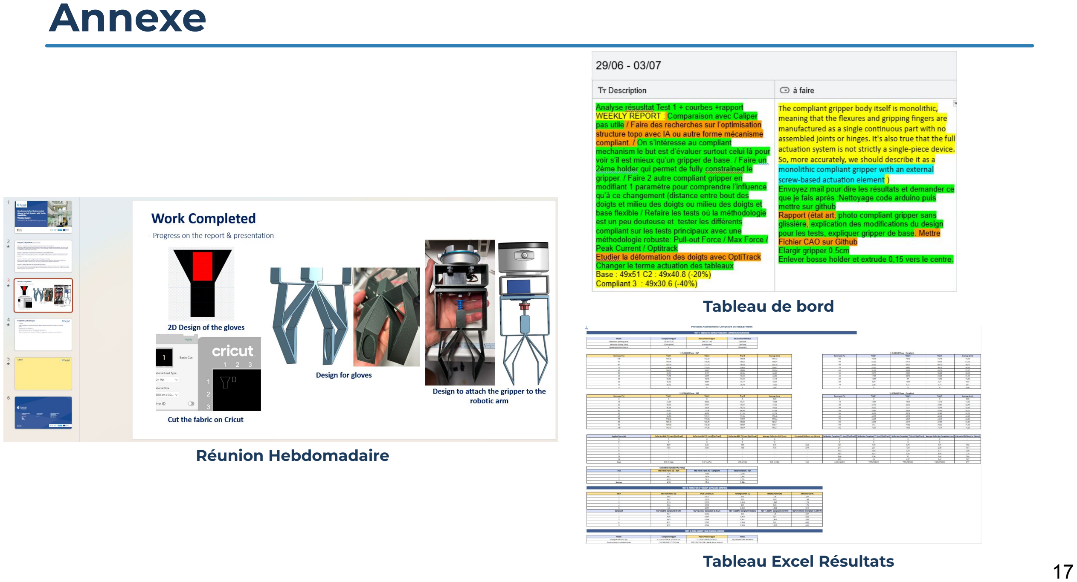
[picture p71: page 17]

Tableau de bord

Tableau Excel Résultats

Réunion Hebdomadaire

# Annexe

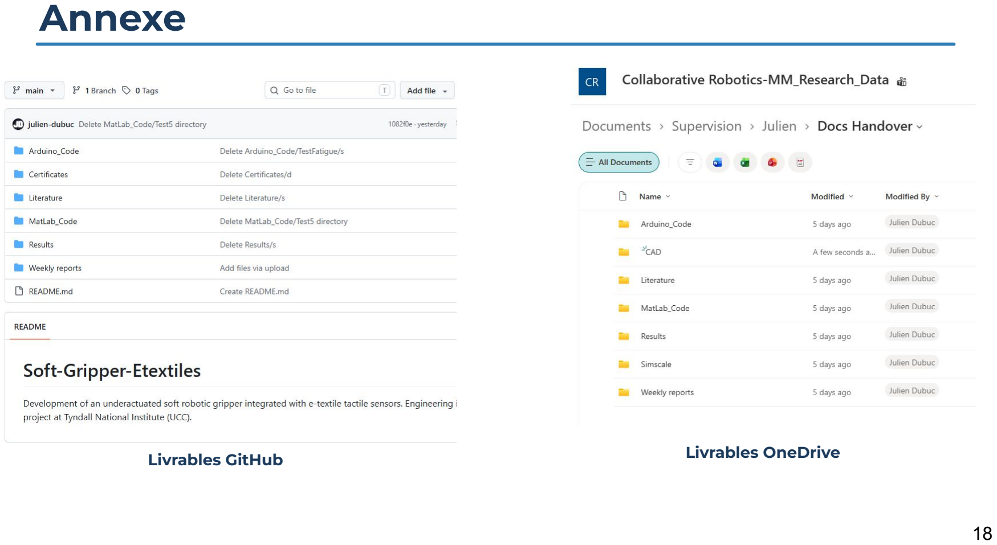
[picture p72: page 18]

Livrables GitHub | Livrables OneDrive

# Annexe

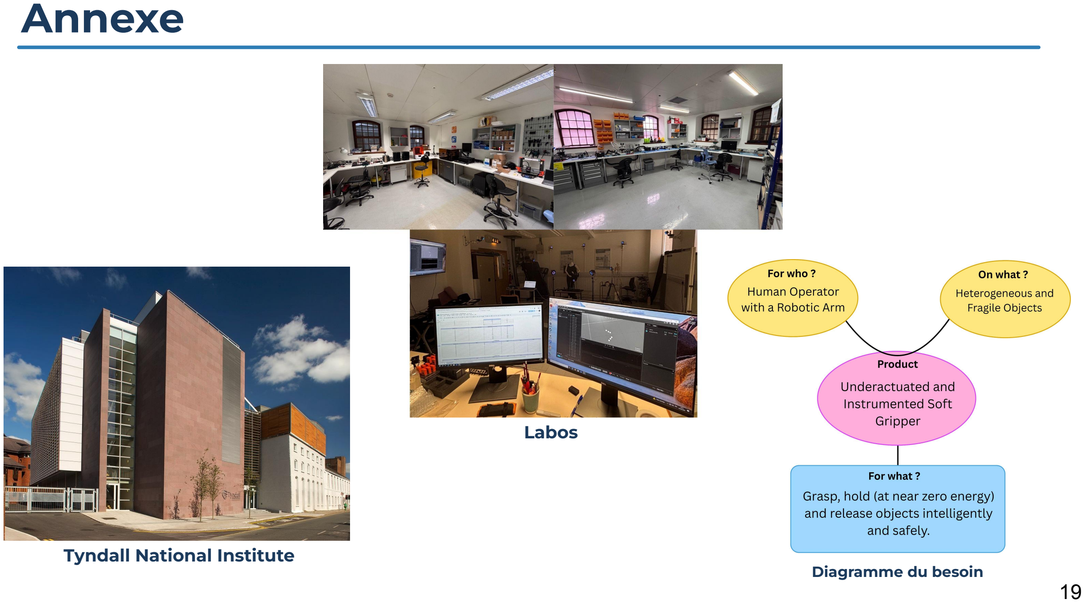
[picture p73: page 19]

Labos

Diagramme du besoin

Tyndall National Institute

# Annexe

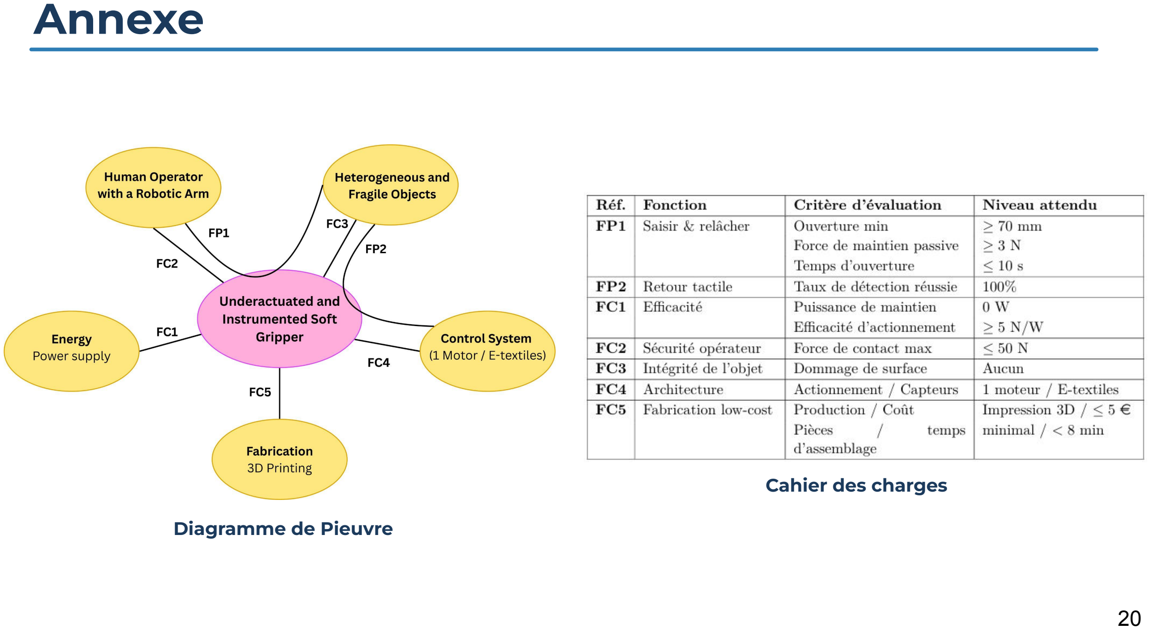
[picture p74: page 20]

Diagramme de Pieuvre

Cahier des charges

# Annexe

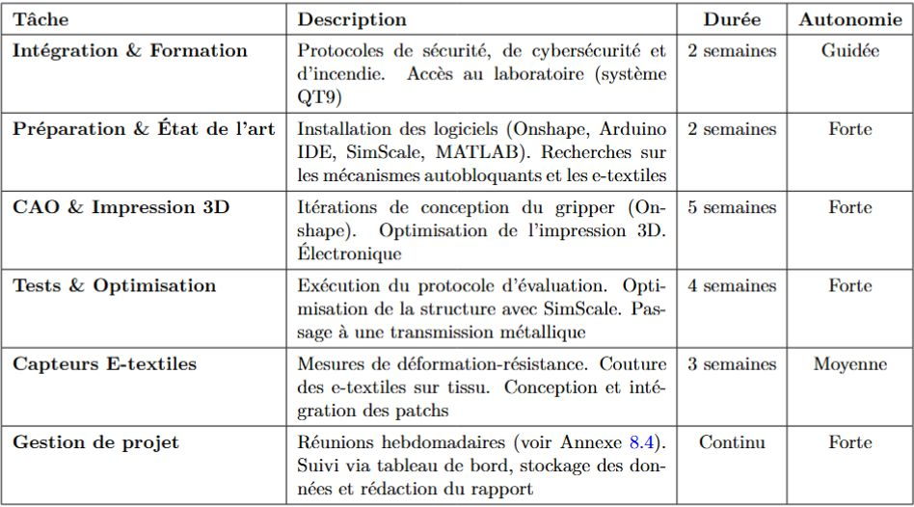
[picture p75: figure]

Tâches

# Annexe

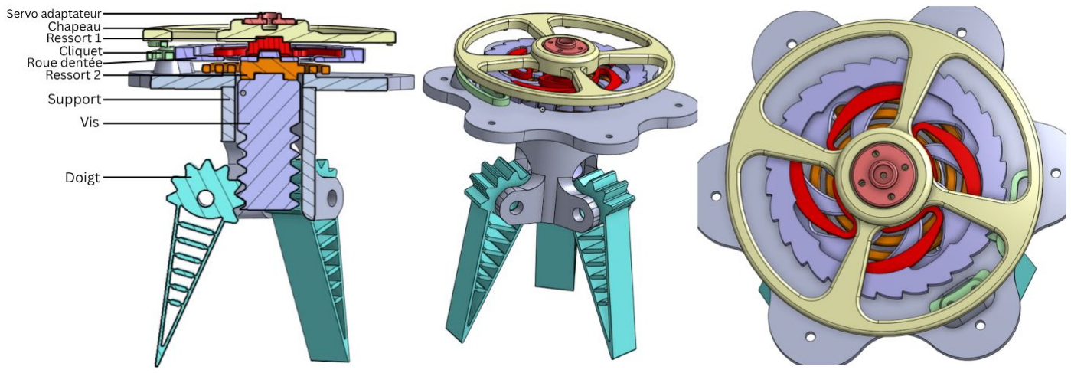
[picture p76: figure]

Design Initial du Laboratoire : Roue Dentée, avec Ressorts, Inspirée des Rapaces

# Annexe

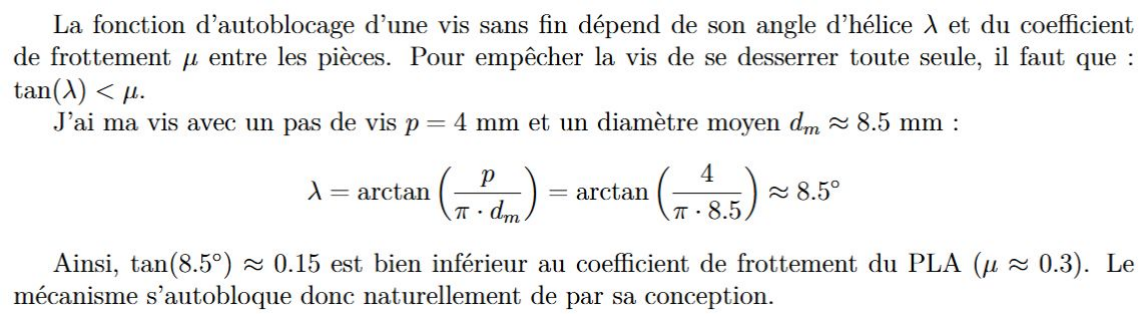
[picture p77: figure]

Principe du Mécanisme Autobloquant

# Annexe

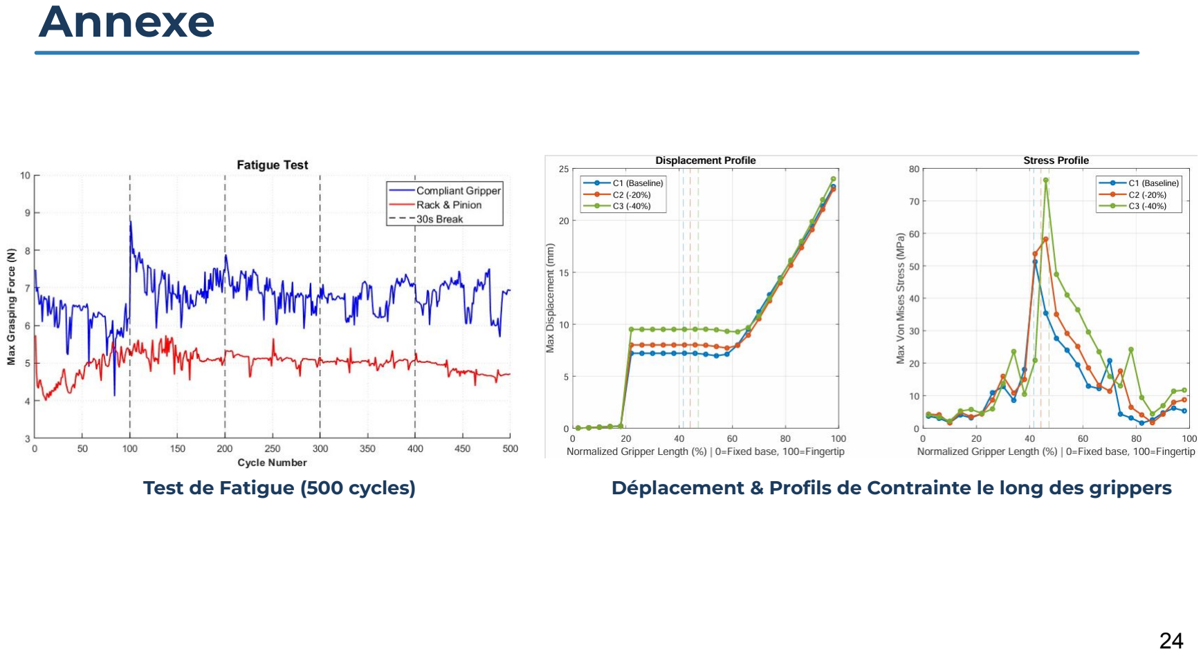
[picture p78: page 24]

Test de Fatigue (500 cycles) | Déplacement & Profils de Contrainte le long des grippers

# Annexe

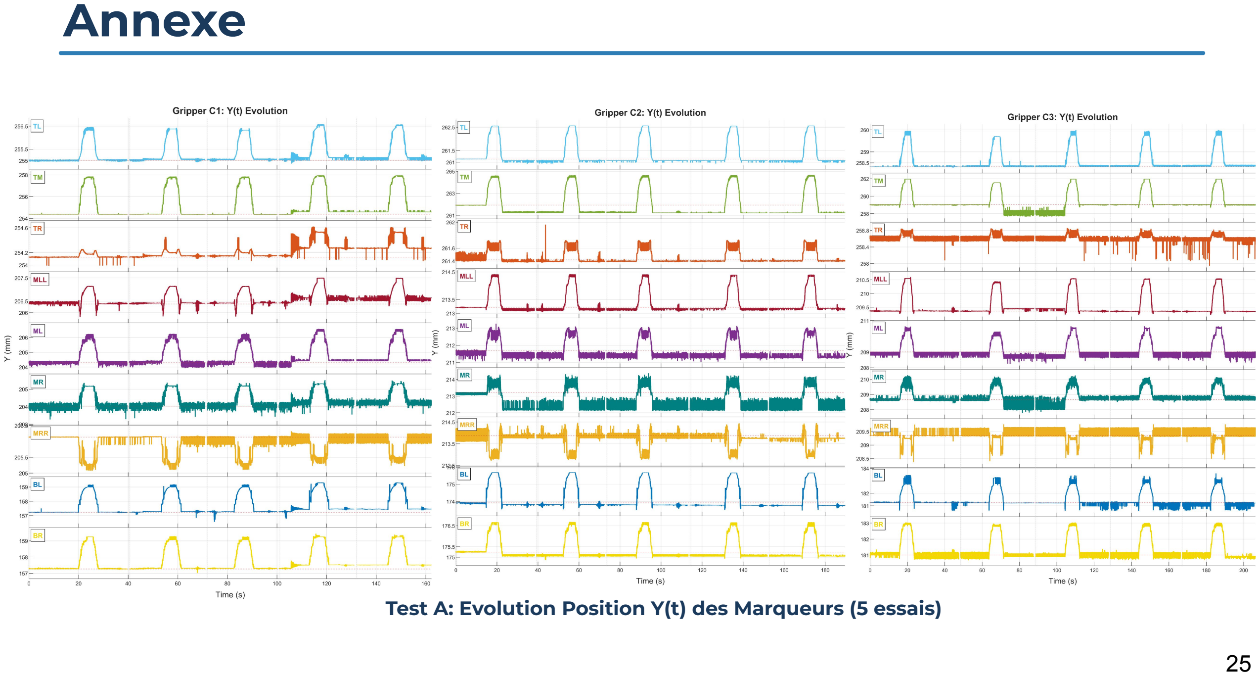
[picture p79: page 25]

Test A: Evolution Position Y(t) des Marqueurs (5 essais)

# Annexe

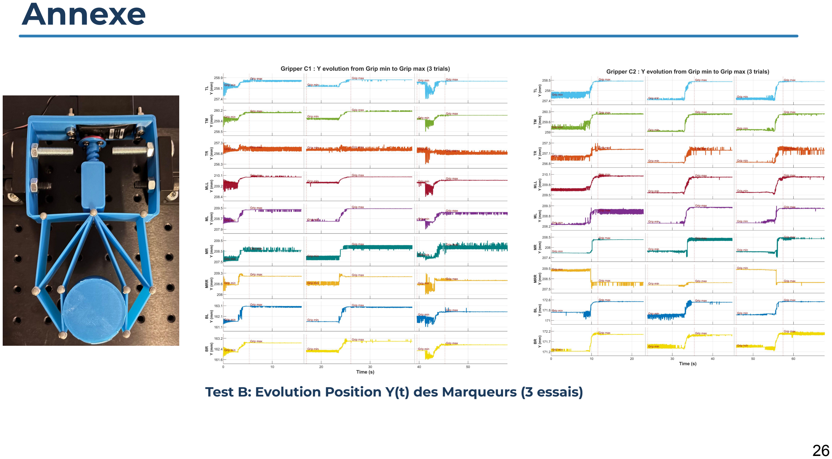
[picture p80: page 26]

Test B: Evolution Position Y(t) des Marqueurs (3 essais)

# Annexe

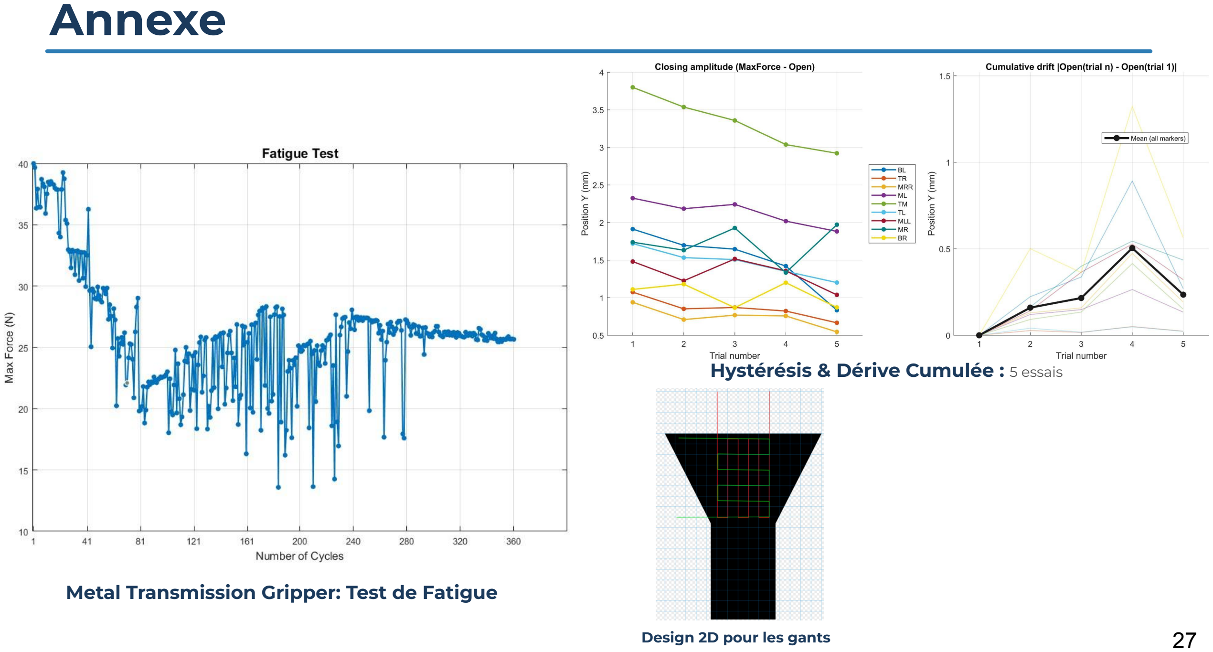
[picture p81: page 27]

Metal Transmission Gripper: Test de Fatigue

Design 2D pour les gants

Design Modification
Hystérésis & Dérive Cumulée : 5 essais
