julien-dubuc/Compliant-Gripper-Etextiles/CAD/Simscale.pdf

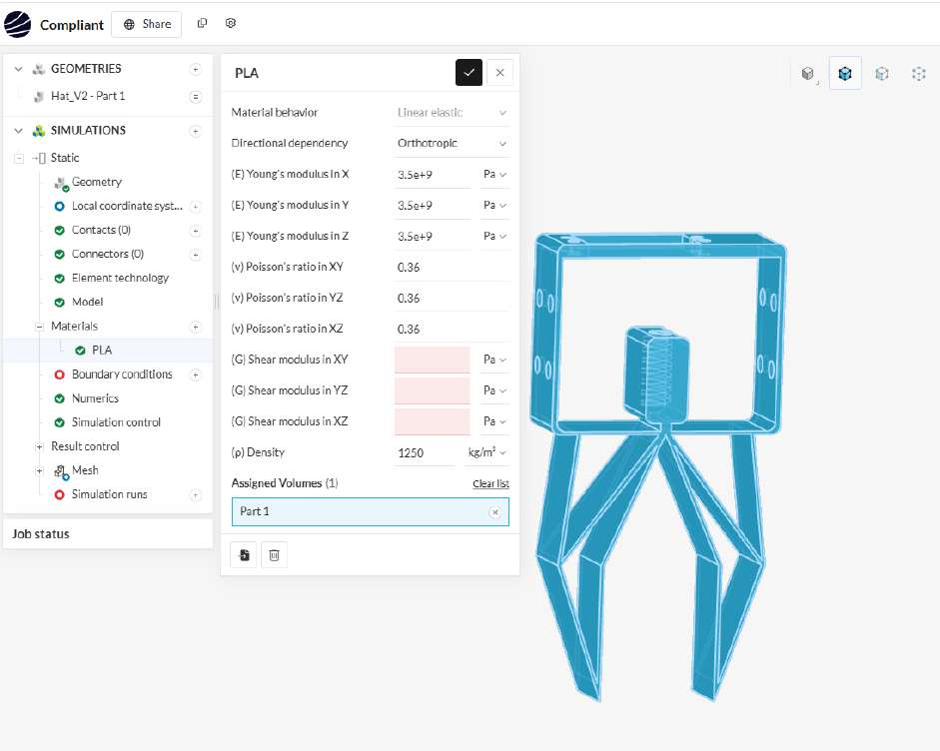
[picture p82: figure]

Pour répondre directement : Dans SimScale, tu ne peux pas simuler le processus d'impression ligne par ligne, mais tu peux (et dois) simuler le comportement mécanique qui en résulte. Un morceau de PLA injecté dans un moule est Isotrope (il a la même résistance dans toutes les directions). Un PLA imprimé en 3D est Orthotrope (ses propriétés mécaniques varient selon 3 axes perpendiculaires, l'axe Z étant beaucoup plus faible).

### 1. Définir un comportement matériel Orthotrope

- Dans les paramètres de ton matériau, cherche l'option Material behavior (Comportement du matériau).
- Change-le de Linear elastic (Isotropic) à Linear elastic (Orthotropic).

### 2. Entrer les données directionnelles du PLA imprimé

Une fois le matériau défini sur Orthotrope, SimScale te demandera d'entrer les propriétés (Module d'Young, Coefficient de Poisson, Module de cisaillement) pour les 3 directions

Axes X et Y (dans le plan de la couche) : Le module d'Young sera élevé, proche des valeurs nominales du PLA (ex: 2800 à 3300 MPa). C'est là que le plastique est continu.

- Axe Z (perpendiculaire aux couches) : Le module d'Young sera nettement plus faible (souvent 20 à 30% de moins, ex: 2000 à 2500 MPa), et la limite d'élasticité (Yield strength) chutera drastiquement à cause de la faible adhérence inter-couches.

Le flux de travail recommandé (Workflow) :

1. Phase d'idéation (Optimisation) : Fais ton optimisation topologique en considérant le PLA comme Isotrope, mais en utilisant une limite d'élasticité très conservatrice (prends la valeur de la résistance de l'axe Z pour tout le modèle). Cela forcera l'algorithme à créer des charnières un peu plus épaisses.
2. Phase de validation (Simulation statique) : Une fois la forme optimisée générée et lissée, réimporte-la dans SimScale et lance une analyse Statique Structurelle standard avec le matériau Orthotrope pour vérifier que les contraintes dans tes charnières compliantes ne dépassent pas la limite de rupture entre les couches.

La solution mathématique
Pour l'instant, les valeurs que tu as entrées pour le module d'Young ($E$) et le coefficient de Poisson ($\nu$) sont identiques dans toutes les directions. On peut donc utiliser la relation standard de l'élasticité linéaire pour calculer le module de cisaillement $G$ manquant :

$$G = \frac{E}{2(1+\nu)}$$
En utilisant tes valeurs ($E$ = 3.5e+9 Pa et $\nu$ = 0.36) :

$$G = \frac{3.5 \times 10^9}{2(1 + 0.36)} = \frac{3.5 \times 10^9}{2.72} \approx 1.287 \times 10^9 \text{ Pa}$$
Copie-colle la valeur 1.287e+9 dans les trois cases rouges (Shear modulus in XY, YZ, et XZ). Cela validera ton matériau et te permettra de lancer le maillage.

Si tu veux réellement simuler la faiblesse entre les couches (l'axe Z de ton imprimante), tu dois réduire la valeur de l'axe Z.Voici une configuration beaucoup plus représentative pour du PLA imprimé en 3D (en supposant que l'axe Z de SimScale correspond à la hauteur d'impression) :

- (E) Young's modulus in X : 3.5e+9 Pa (Solide)
- (E) Young's modulus in Y : 3.5e+9 Pa (Solide)
- (E) Young's modulus in Z : 2.4e+9 Pa (Plus faible à cause de l'adhérence des couches)

Si tu modifies le $E_z$, le module de cisaillement dans les plans verticaux ($G_{yz}$ et $G_{xz}$) sera également plus faible. Si tu n'as pas les données exactes du fabricant de ton filament, une bonne approximation est de garder $G_{xy}$ à 1.287e+9, et de réduire $G_{yz}$ et $G_{xz}$ d'environ 30% (soit autour de 9.0e+8).

Cela donnera à ton optimisation topologique des contraintes beaucoup plus proches de la réalité de l'impression FDM !

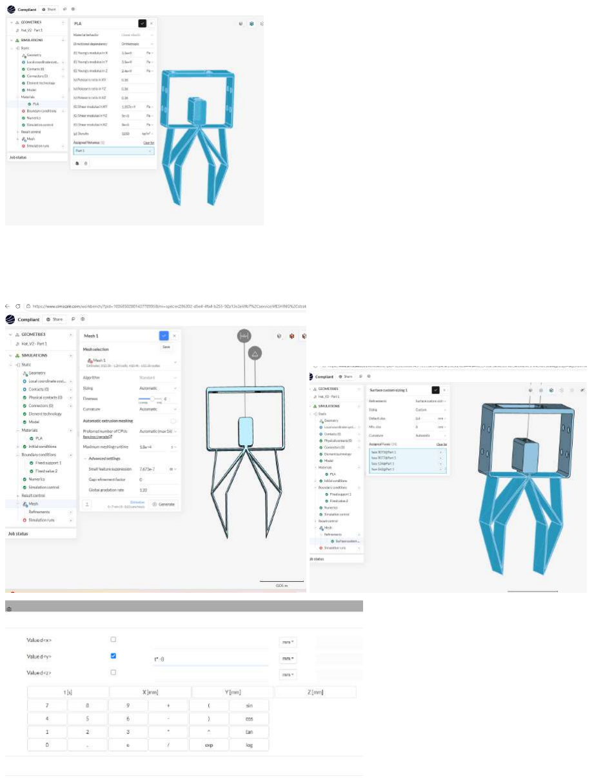
[picture p83: page 3]
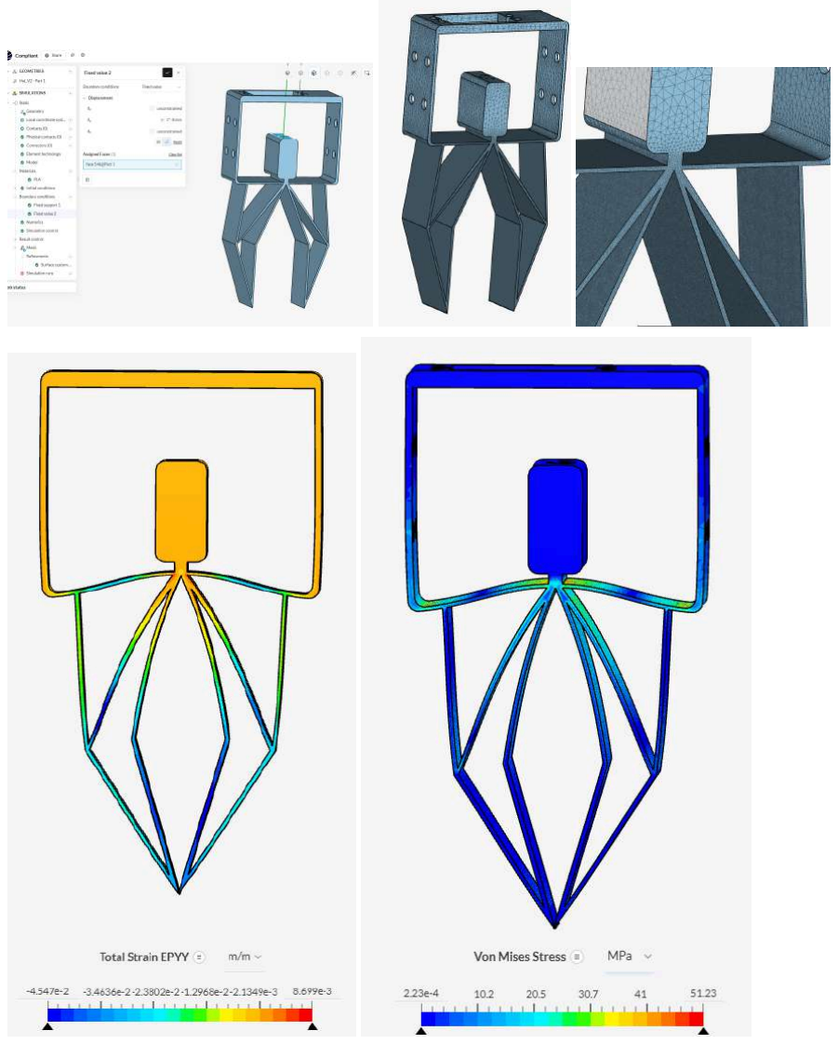
[picture p84: page 4]

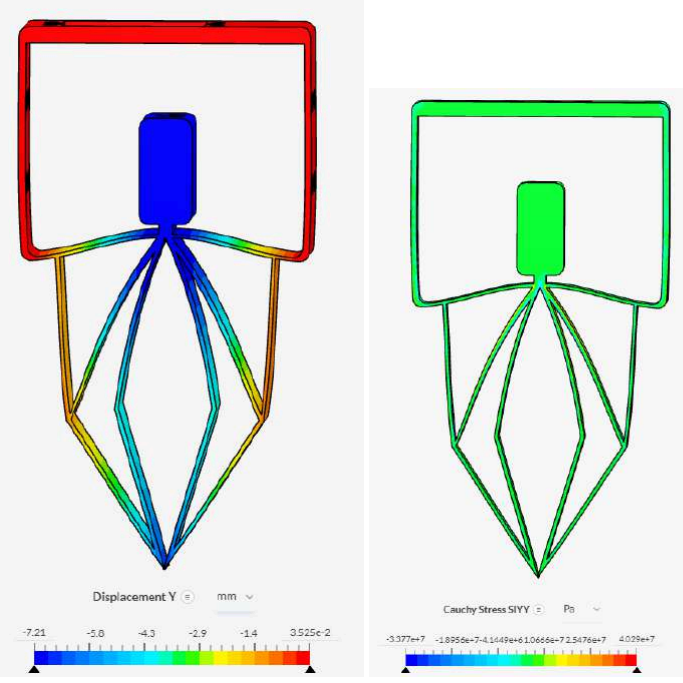
[picture p85: figure]

## COMPLIANT 2

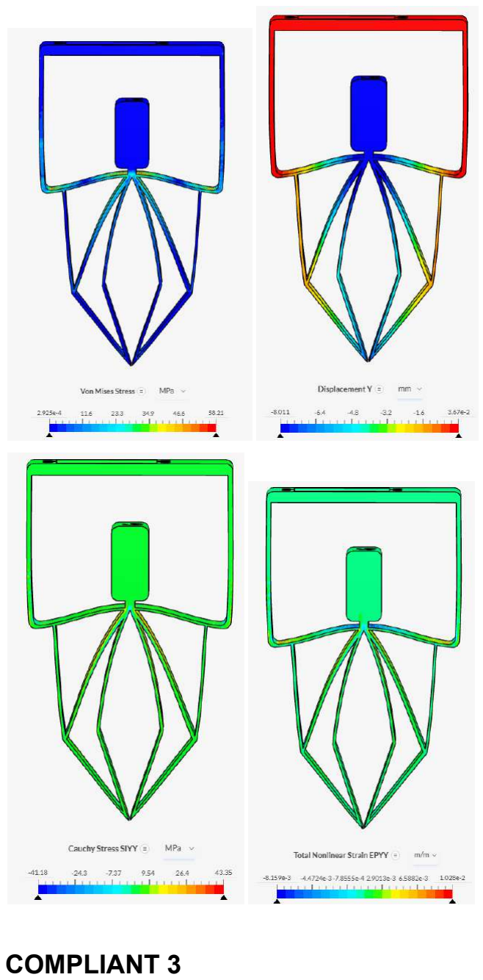
[picture p86: page 6]

## COMPLIANT 3

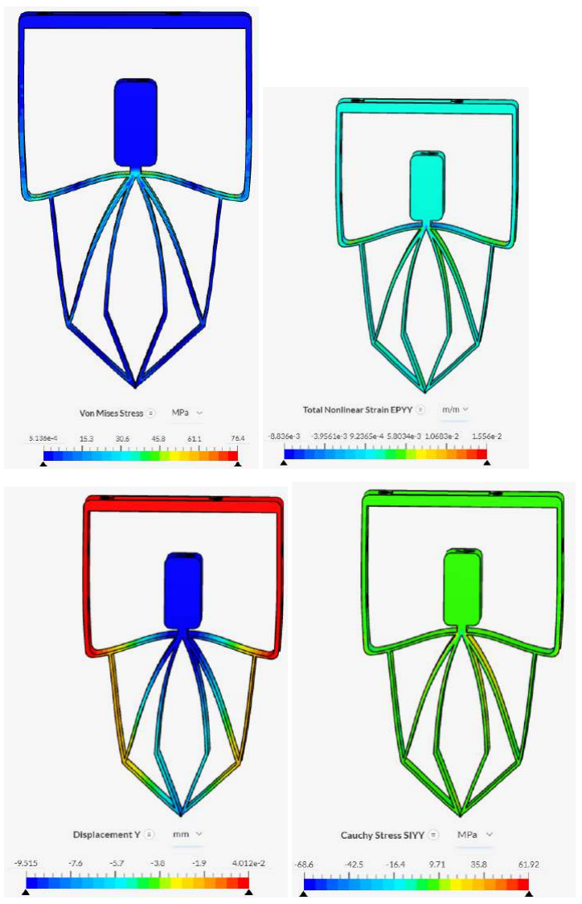
[picture p87: page 7]
