julien-dubuc/Compliant-Gripper-Etextiles/MatLab_Code/RoboticArm/E_textile_Sensor_Response.png

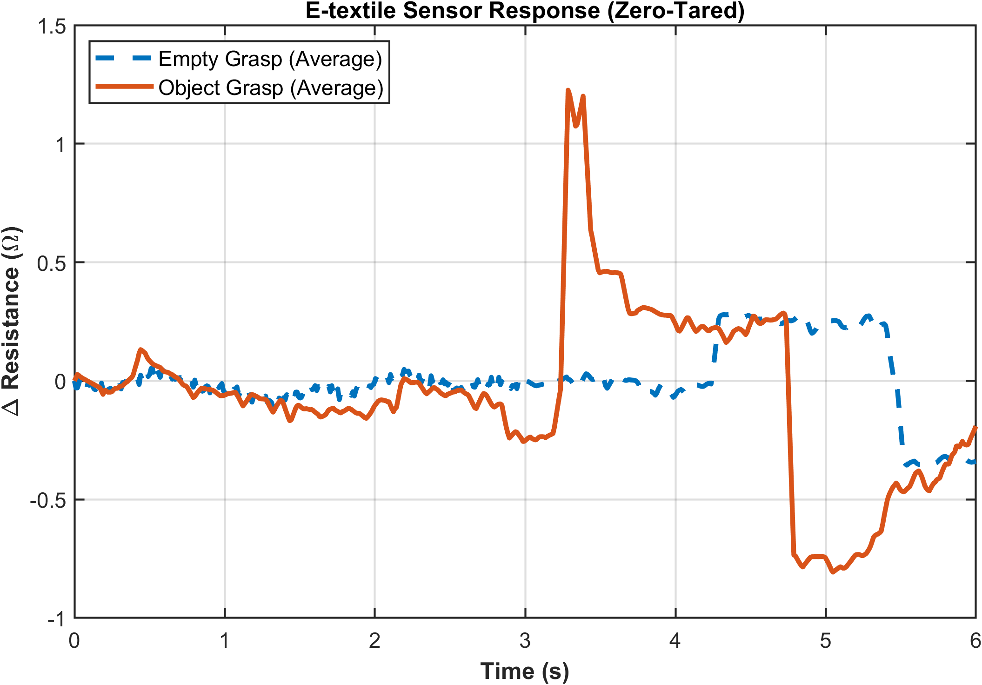
MatLab_Code/RoboticArm/E_textile_Sensor_Response.png
