julien-dubuc/Compliant-Gripper-Etextiles/MatLab_Code/Simscale/SimScale_Peak_Stress.png

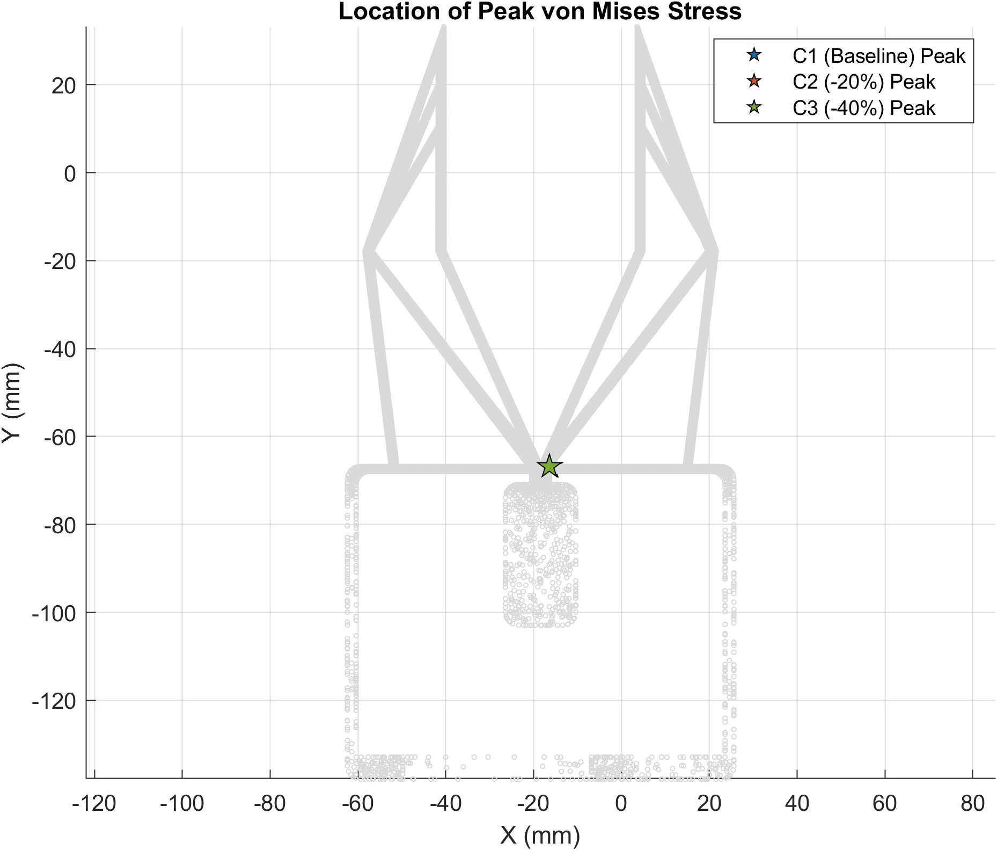
MatLab_Code/Simscale/SimScale_Peak_Stress.png
