julien-dubuc/Compliant-Gripper-Etextiles/MatLab_Code/Simscale/SimScale_Profiles.png

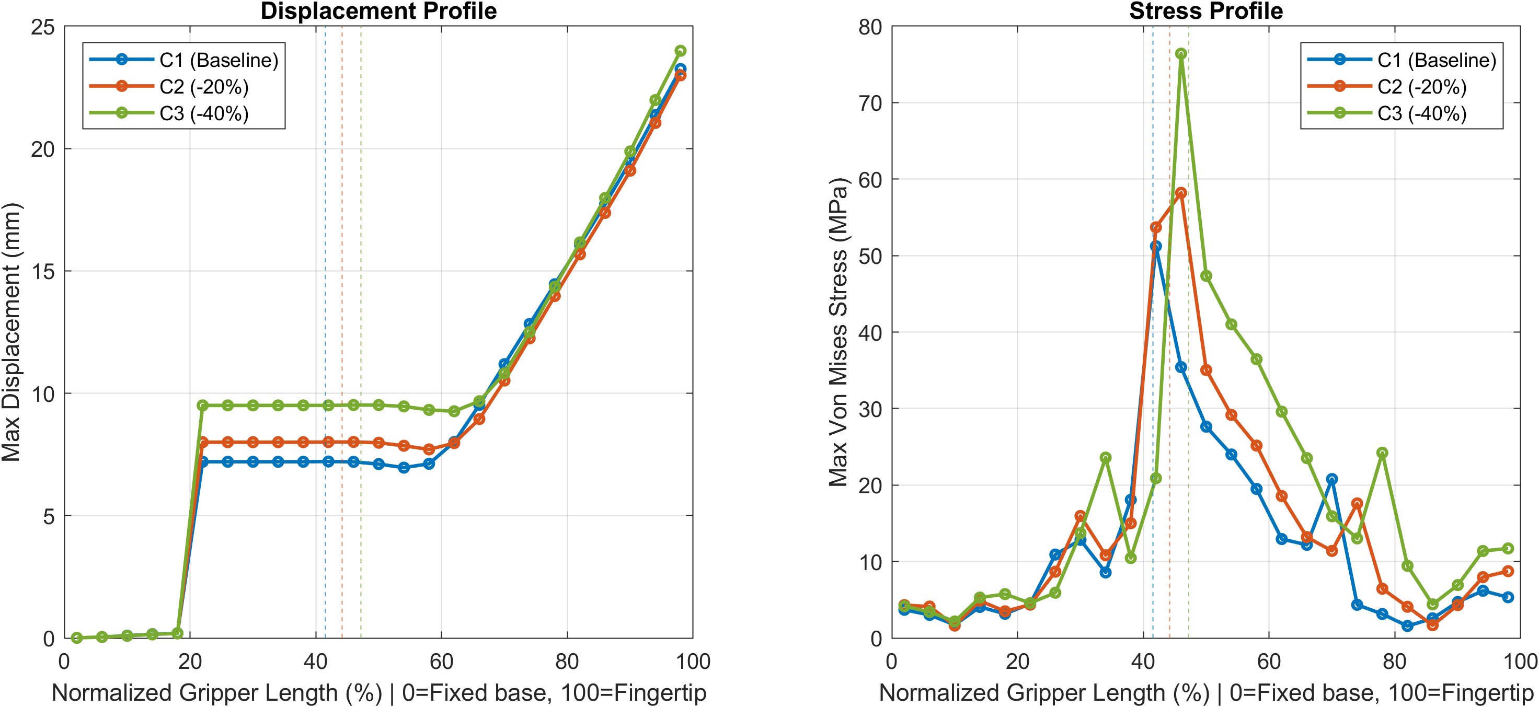
MatLab_Code/Simscale/SimScale_Profiles.png
