julien-dubuc/Compliant-Gripper-Etextiles/MatLab_Code/Test4/DATA_TEST4.txt

COMPLIANT 

=== BANC D'ESSAI : TEST 5 (FATIGUE CORRIGE) ===
-> Joystick ACTIF.
-> Tapez 's' puis Entree pour lancer le test.

--- DEBUT DU TEST AUTOMATISE ---
Cycle,Force_Max_N
1,7.48
2,6.90
3,7.01
4,6.78
5,6.55
6,6.58
7,6.81
8,6.09
9,6.59
10,6.77
11,6.69
12,6.72
13,6.65
14,6.25
15,6.79
16,6.37
17,6.29
18,6.44
19,6.53
20,6.75
21,5.96
22,6.15
23,6.50
24,5.94
25,5.94
26,6.09
27,6.67
28,6.67
29,6.42
30,6.47
31,6.52
32,6.58
33,6.51
34,5.27
35,5.22
36,5.79
37,6.23
38,5.64
39,6.19
40,6.51
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
# [PAUSE] Securite thermique du servo : Arret de 30 secondes... #
101,8.78
102,8.43
103,7.90
104,8.05
105,7.80
106,7.87
107,7.41
108,7.65
109,7.82
110,7.95
111,7.67
112,7.65
113,7.78
114,7.55
115,7.41
116,6.86
117,6.89
118,6.79
119,7.61
120,7.53
121,7.54
122,7.51
123,6.94
124,6.87
125,6.92
126,7.50
127,6.65
128,5.92
129,6.43
130,6.72
131,7.08
132,7.12
133,7.23
134,7.47
135,7.33
136,7.22
137,7.41
138,6.80
139,6.32
140,6.77
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
# [PAUSE] Securite thermique du servo : Arret de 30 secondes... #
201,7.89
202,7.75
203,7.53
204,7.37
205,7.08
206,7.03
207,7.07
208,7.31
209,6.71
210,7.05
211,6.93
212,6.87
213,7.17
214,6.89
215,6.94
216,7.25
217,7.46
218,7.40
219,7.35
220,7.35
221,7.24
222,7.45
223,6.66
224,6.98
225,7.29
226,6.93
227,7.34
228,6.92
229,7.35
230,7.50
231,7.40
232,7.42
233,7.33
234,7.35
235,6.96
236,6.87
237,6.84
238,6.89
239,6.84
240,6.76
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
# [PAUSE] Securite thermique du servo : Arret de 30 secondes... #
301,6.99
302,6.69
303,7.10
304,6.81
305,6.76
306,6.72
307,6.74
308,6.58
309,6.85
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
416,5.02
417,5.00
418,5.00
419,5.01
420,4.99
421,5.01
422,5.01
423,4.96
424,4.95
425,4.97
426,4.95
427,4.95
428,4.96
429,4.95
430,4.94
431,4.99
432,4.88
433,5.09
434,4.91
435,4.62
436,4.67
437,4.76
438,4.80
439,4.81
440,4.86
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
--- FIN DU TEST DE FATIGUE ---

[RETOUR] Mode Joystick active.
