julien-dubuc/Compliant-Gripper-Etextiles/MatLab_Code/Test2/DATA_TEST2.txt

RACK ET PINION
=== SYSTEME PRET ===
-> Joystick ACTIF.
-> Affichage de la force en direct pour etalonnage...
-> Tapez 'c' puis Entree pour lancer le Cycle Auto.

--- PHASE 1 : FERMETURE ---
1,0.00
63,0.00
155,-0.00
248,-0.00
340,-0.00
433,0.00
526,0.00
619,0.00
711,0.00
804,0.00
896,0.00
989,-0.00
1082,-0.00
1175,0.00
1268,0.00
1360,0.00
1453,0.07
1545,0.41
1638,0.86
1731,1.30
1823,1.70
1916,2.05
2008,2.39
--- PHASE 2 : HOLD (5s) ---
2101,2.70
2194,3.03
2286,3.32
2378,3.58
2471,3.64
2563,3.61
2656,3.62
2749,3.62
2841,3.61
2933,3.60
3026,3.59
3118,3.59
3211,3.58
3304,3.58
3396,3.58
3488,3.57
3581,3.57
3673,3.56
3766,3.56
3858,3.56
3951,3.56
4043,3.55
4135,3.55
4228,3.55
4321,3.55
4413,3.54
4506,3.54
4598,3.54
4690,3.54
4782,3.53
4876,3.54
4968,3.53
5060,3.53
5153,3.53
5245,3.53
5337,3.53
5431,3.53
5523,3.53
5615,3.52
5707,3.52
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
--- PHASE 3 : OUVERTURE ---
7187,3.50
7280,3.54
7372,3.90
7465,4.15
7557,4.04
7651,3.93
7743,3.90
7836,3.86
7928,3.86
8021,3.88
8113,3.86
8207,3.77
8299,2.91
8392,1.43
8484,1.26
8577,1.33
8669,1.34
8763,0.94
8855,0.49
8948,0.27
9040,0.10
9132,0.02
--- FIN DU CYCLE ---

[RETOUR] Mode Joystick active. Affichage en direct repris.

=== SYSTEME PRET ===
-> Joystick ACTIF.
-> Affichage de la force en direct pour etalonnage...
-> Tapez 'c' puis Entree pour lancer le Cycle Auto.

--- PHASE 1 : FERMETURE ---
0,-0.00
51,0.01
114,0.01
208,0.00
300,0.00
393,0.01
485,0.01
578,0.00
671,0.00
764,0.00
856,0.00
949,0.00
1041,0.00
1133,0.00
1227,0.01
1319,0.04
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
Hold Current : [0.360, 0.370, 0.369, 0.370, 0.369] $\rightarrow$ $0.368 \pm 0.004$ A
Hold Power : [1.80, 1.85, 1.845, 1.85, 1.845] $\rightarrow$ $1.84 \pm 0.02$ W
Efficiency : [2.02, 1.84, 1.78, 1.76, 2.11] $\rightarrow$ $1.91 \pm 0.15$ N/W
