julien-dubuc/Compliant-Gripper-Etextiles/MatLab_Code/TestFatigue/TestFatiguePLA.txt

rawData = [
1,16.46,1.84
2,20.08,4.45
3,20.38,3.89
4,20.28,4.01
5,20.05,3.73
6,20.17,3.53
7,19.84,3.72
8,20.07,4.01
9,20.19,3.55
10,20.05,3.57
11,19.88,3.82
12,20.00,3.63
13,19.87,3.42
14,19.87,3.43
15,19.79,3.46
16,19.85,3.08
17,19.84,3.15
18,19.87,3.29
19,19.78,3.37
20,19.74,3.03
21,19.78,3.19
22,19.56,3.23
23,19.73,3.09
24,19.51,3.09
25,19.47,3.32
26,19.49,3.29
27,19.56,2.98
28,19.31,3.06
29,18.97,2.81
30,19.38,3.20
31,19.29,2.82
32,19.34,2.90
33,19.33,2.92
34,19.28,2.59
35,19.22,2.72
36,18.98,2.61
37,18.87,2.55
38,18.79,2.30
39,18.84,2.33
40,18.79,2.32
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
];
