julien-dubuc/Compliant-Gripper-Etextiles/MatLab_Code/Etextiles/infrachip_testA_20260819_144056.csv

time_s | arduino_ms | force_N | rx_ohm | state | step | target_strain_pct | raw_line
0.0005347 | 1384834 | -2.417 | 5.209 | DONE | 8 | 5 | DATA,1384834,-2.417,5.209,DONE,8,5.000
0.0710608 | 1384934 | -2.418 | 5.242 | DONE | 8 | 5 | DATA,1384934,-2.418,5.242,DONE,8,5.000
0.3486186 | 1385034 | -2.418 | 5.225 | DONE | 8 | 5 | DATA,1385034,-2.418,5.225,DONE,8,5.000
0.349733 | 1385134 | -2.418 | 5.237 | DONE | 8 | 5 | DATA,1385134,-2.418,5.237,DONE,8,5.000
0.3681682 | 1385234 | -2.418 | 5.221 | DONE | 8 | 5 | DATA,1385234,-2.418,5.221,DONE,8,5.000
0.4642962 | 1385334 | -2.418 | 5.221 | DONE | 8 | 5 | DATA,1385334,-2.418,5.221,DONE,8,5.000
0.575322 | 1385434 | -2.418 | 5.231 | DONE | 8 | 5 | DATA,1385434,-2.418,5.231,DONE,8,5.000
0.67036 | 1385534 | -2.417 | 5.23 | DONE | 8 | 5 | DATA,1385534,-2.417,5.230,DONE,8,5.000
0.7658032 | 1385634 | -2.417 | 5.222 | DONE | 8 | 5 | DATA,1385634,-2.417,5.222,DONE,8,5.000
0.8611827 | 1385734 | -2.417 | 5.208 | DONE | 8 | 5 | DATA,1385734,-2.417,5.208,DONE,8,5.000
0.9729409 | 1385834 | -2.417 | 5.235 | DONE | 8 | 5 | DATA,1385834,-2.417,5.235,DONE,8,5.000
1.0694017 | 1385934 | -2.417 | 5.244 | DONE | 8 | 5 | DATA,1385934,-2.417,5.244,DONE,8,5.000
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
