julien-dubuc/Compliant-Gripper-Etextiles/MatLab_Code/Etextiles/infrachip_testA_20260819_145130.csv

time_s | arduino_ms | force_N | rx_ohm | state | step | target_strain_pct | raw_line
0.0004726 | 2018244 | 0.003 | 4.346 | DONE | 8 | 5 | DATA,2018244,0.003,4.346,DONE,8,5.000
0.0451515 | 2018344 | 0.003 | 4.389 | DONE | 8 | 5 | DATA,2018344,0.003,4.389,DONE,8,5.000
0.3935777 | 2018444 | 0.003 | 4.37 | DONE | 8 | 5 | DATA,2018444,0.003,4.370,DONE,8,5.000
0.3965979 | 2018544 | 0.003 | 4.368 | DONE | 8 | 5 | DATA,2018544,0.003,4.368,DONE,8,5.000
0.3976776 | 2018644 | 0.003 | 4.377 | DONE | 8 | 5 | DATA,2018644,0.003,4.377,DONE,8,5.000
0.4172044 | 2018744 | 0.003 | 4.345 | DONE | 8 | 5 | DATA,2018744,0.003,4.345,DONE,8,5.000
0.5295699 | 2018844 | 0.003 | 4.349 | DONE | 8 | 5 | DATA,2018844,0.003,4.349,DONE,8,5.000
0.6235811 | 2018944 | 0.003 | 4.369 | DONE | 8 | 5 | DATA,2018944,0.003,4.369,DONE,8,5.000
0.7202884 | 2019044 | 0.003 | 4.347 | DONE | 8 | 5 | DATA,2019044,0.003,4.347,DONE,8,5.000
0.8301738 | 2019144 | 0.003 | 4.338 | DONE | 8 | 5 | DATA,2019144,0.003,4.338,DONE,8,5.000
0.924939 | 2019244 | 0.003 | 4.34 | DONE | 8 | 5 | DATA,2019244,0.003,4.340,DONE,8,5.000
1.0205927 | 2019344 | 0.003 | 4.338 | DONE | 8 | 5 | DATA,2019344,0.003,4.338,DONE,8,5.000
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
