julien-dubuc/Compliant-Gripper-Etextiles/MatLab_Code/Etextiles/infrachip_testA_20260819_150136.csv

time_s | arduino_ms | force_N | rx_ohm | state | step | target_strain_pct | raw_line
0.000465 | 2623444 | 0.006 | 4.054 | DONE | 8 | 5 | DATA,2623444,0.006,4.054,DONE,8,5.000
0.1262889 | 2623544 | 0.006 | 4.06 | DONE | 8 | 5 | DATA,2623544,0.006,4.060,DONE,8,5.000
0.3773634 | 2623644 | 0.006 | 4.059 | DONE | 8 | 5 | DATA,2623644,0.006,4.059,DONE,8,5.000
0.378631 | 2623744 | 0.006 | 4.059 | DONE | 8 | 5 | DATA,2623744,0.006,4.059,DONE,8,5.000
0.4047187 | 2623844 | 0.006 | 4.038 | DONE | 8 | 5 | DATA,2623844,0.006,4.038,DONE,8,5.000
0.500822 | 2623944 | 0.006 | 4.039 | DONE | 8 | 5 | DATA,2623944,0.006,4.039,DONE,8,5.000
0.5949024 | 2624044 | 0.006 | 4.062 | DONE | 8 | 5 | DATA,2624044,0.006,4.062,DONE,8,5.000
0.7127344 | 2624144 | 0.006 | 4.041 | DONE | 8 | 5 | DATA,2624144,0.006,4.041,DONE,8,5.000
0.8006503 | 2624244 | 0.006 | 4.029 | DONE | 8 | 5 | DATA,2624244,0.006,4.029,DONE,8,5.000
0.8960487 | 2624344 | 0.006 | 4.036 | DONE | 8 | 5 | DATA,2624344,0.006,4.036,DONE,8,5.000
1.0069392 | 2624444 | 0.006 | 4.027 | DONE | 8 | 5 | DATA,2624444,0.006,4.027,DONE,8,5.000
1.1021151 | 2624544 | 0.006 | 4.045 | DONE | 8 | 5 | DATA,2624544,0.006,4.045,DONE,8,5.000
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
