julien-dubuc/Compliant-Gripper-Etextiles/MatLab_Code/Etextiles/infrachip_testA_20260819_151112.csv

time_s | arduino_ms | force_N | rx_ohm | state | step | target_strain_pct | raw_line
0.000536 | 3199044 | 0.021 | 3.604 | DONE | 8 | 5 | DATA,3199044,0.021,3.604,DONE,8,5.000
0.0461538 | 3199144 | 0.021 | 3.58 | DONE | 8 | 5 | DATA,3199144,0.021,3.580,DONE,8,5.000
0.4474102 | 3199244 | 0.021 | 3.612 | DONE | 8 | 5 | DATA,3199244,0.021,3.612,DONE,8,5.000
0.4490031 | 3199344 | 0.02 | 3.627 | DONE | 8 | 5 | DATA,3199344,0.020,3.627,DONE,8,5.000
0.4500114 | 3199444 | 0.021 | 3.627 | DONE | 8 | 5 | DATA,3199444,0.021,3.627,DONE,8,5.000
0.4518631 | 3199544 | 0.021 | 3.606 | DONE | 8 | 5 | DATA,3199544,0.021,3.606,DONE,8,5.000
0.5317959 | 3199644 | 0.021 | 3.6 | DONE | 8 | 5 | DATA,3199644,0.021,3.600,DONE,8,5.000
0.6272773 | 3199744 | 0.02 | 3.607 | DONE | 8 | 5 | DATA,3199744,0.020,3.607,DONE,8,5.000
0.738306 | 3199844 | 0.021 | 3.602 | DONE | 8 | 5 | DATA,3199844,0.021,3.602,DONE,8,5.000
0.8331425 | 3199944 | 0.021 | 3.59 | DONE | 8 | 5 | DATA,3199944,0.021,3.590,DONE,8,5.000
0.9292605 | 3200044 | 0.021 | 3.618 | DONE | 8 | 5 | DATA,3200044,0.021,3.618,DONE,8,5.000
1.0403674 | 3200144 | 0.021 | 3.604 | DONE | 8 | 5 | DATA,3200144,0.021,3.604,DONE,8,5.000
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
