julien-dubuc/Compliant-Gripper-Etextiles/MatLab_Code/Etextiles/infrachip_testA_20260819_152117.csv

time_s | arduino_ms | force_N | rx_ohm | state | step | target_strain_pct | raw_line
0.0006111 | 3803734 | -0.006 | 5.853 | DONE | 8 | 5 | DATA,3803734,-0.006,5.853,DONE,8,5.000
0.0570358 | 3803834 | -0.007 | 5.868 | DONE | 8 | 5 | DATA,3803834,-0.007,5.868,DONE,8,5.000
0.1990198 | 3803934 | -0.007 | 5.875 | DONE | 8 | 5 | DATA,3803934,-0.007,5.875,DONE,8,5.000
0.2608926 | 3804034 | -0.006 | 5.858 | DONE | 8 | 5 | DATA,3804034,-0.006,5.858,DONE,8,5.000
0.3603723 | 3804134 | -0.007 | 5.842 | DONE | 8 | 5 | DATA,3804134,-0.007,5.842,DONE,8,5.000
0.4557064 | 3804234 | -0.007 | 5.857 | DONE | 8 | 5 | DATA,3804234,-0.007,5.857,DONE,8,5.000
0.5504105 | 3804334 | -0.007 | 5.846 | DONE | 8 | 5 | DATA,3804334,-0.007,5.846,DONE,8,5.000
0.6617546 | 3804434 | -0.007 | 5.873 | DONE | 8 | 5 | DATA,3804434,-0.007,5.873,DONE,8,5.000
0.7572461 | 3804534 | -0.007 | 5.843 | DONE | 8 | 5 | DATA,3804534,-0.007,5.843,DONE,8,5.000
0.8526303 | 3804634 | -0.007 | 5.871 | DONE | 8 | 5 | DATA,3804634,-0.007,5.871,DONE,8,5.000
0.9643074 | 3804734 | -0.007 | 5.853 | DONE | 8 | 5 | DATA,3804734,-0.007,5.853,DONE,8,5.000
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
