julien-dubuc/Compliant-Gripper-Etextiles/MatLab_Code/Etextiles/infrachip_testA_20260819_153320.csv

time_s | arduino_ms | force_N | rx_ohm | state | step | target_strain_pct | raw_line
0.0005615 | 4525891 | -0.007 | 6.286 | DONE | 8 | 5 | DATA,4525891,-0.007,6.286,DONE,8,5.000
0.0746186 | 4525991 | -0.007 | 6.273 | DONE | 8 | 5 | DATA,4525991,-0.007,6.273,DONE,8,5.000
0.4067203 | 4526091 | -0.007 | 6.268 | DONE | 8 | 5 | DATA,4526091,-0.007,6.268,DONE,8,5.000
0.4091802 | 4526191 | -0.007 | 6.324 | DONE | 8 | 5 | DATA,4526191,-0.007,6.324,DONE,8,5.000
0.4117863 | 4526291 | -0.007 | 6.281 | DONE | 8 | 5 | DATA,4526291,-0.007,6.281,DONE,8,5.000
0.4782216 | 4526391 | -0.007 | 6.284 | DONE | 8 | 5 | DATA,4526391,-0.007,6.284,DONE,8,5.000
0.5729885 | 4526491 | -0.007 | 6.302 | DONE | 8 | 5 | DATA,4526491,-0.007,6.302,DONE,8,5.000
0.6841716 | 4526591 | -0.007 | 6.315 | DONE | 8 | 5 | DATA,4526591,-0.007,6.315,DONE,8,5.000
0.7796832 | 4526691 | -0.007 | 6.325 | DONE | 8 | 5 | DATA,4526691,-0.007,6.325,DONE,8,5.000
0.8739732 | 4526791 | -0.007 | 6.315 | DONE | 8 | 5 | DATA,4526791,-0.007,6.315,DONE,8,5.000
0.9840607 | 4526891 | -0.007 | 6.3 | DONE | 8 | 5 | DATA,4526891,-0.007,6.300,DONE,8,5.000
1.0790244 | 4526991 | -0.007 | 6.319 | DONE | 8 | 5 | DATA,4526991,-0.007,6.319,DONE,8,5.000
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
