julien-dubuc/Compliant-Gripper-Etextiles/MatLab_Code/Test1/test11.png

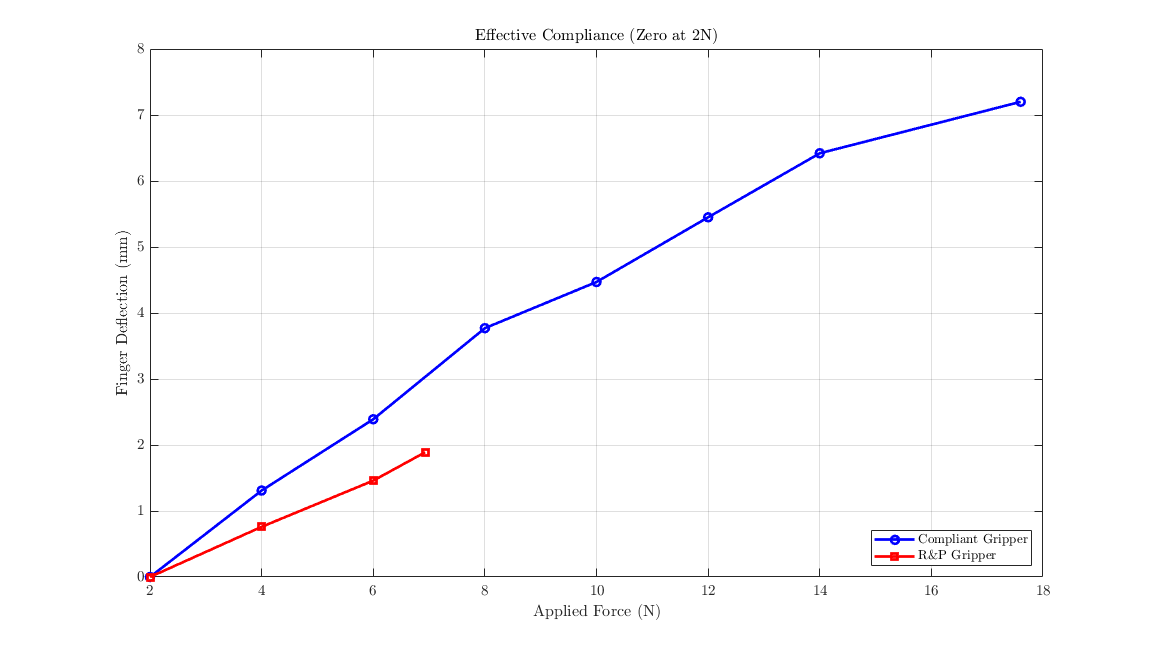
MatLab_Code/Test1/test11.png
