julien-dubuc/Compliant-Gripper-Etextiles/MatLab_Code/Test4/test4.jpg

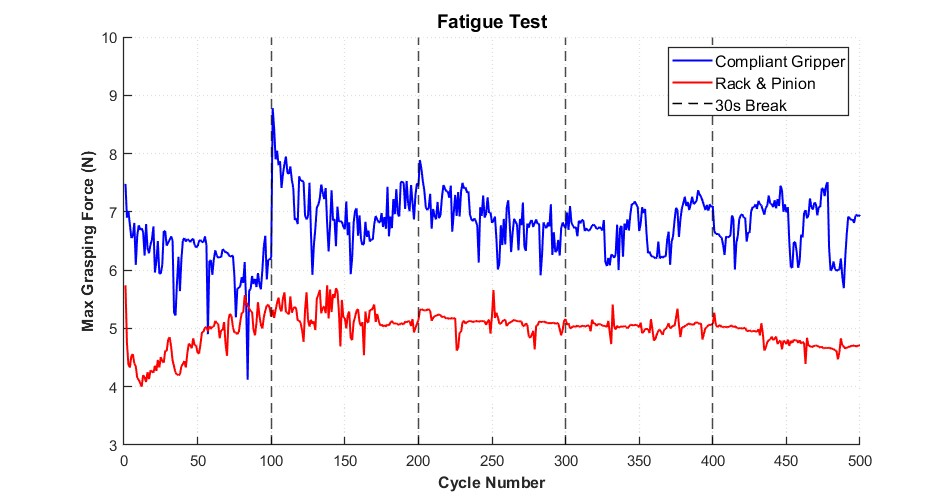
MatLab_Code/Test4/test4.jpg
