julien-dubuc/Compliant-Gripper-Etextiles/MatLab_Code/TestA/Force/C1_pos.png

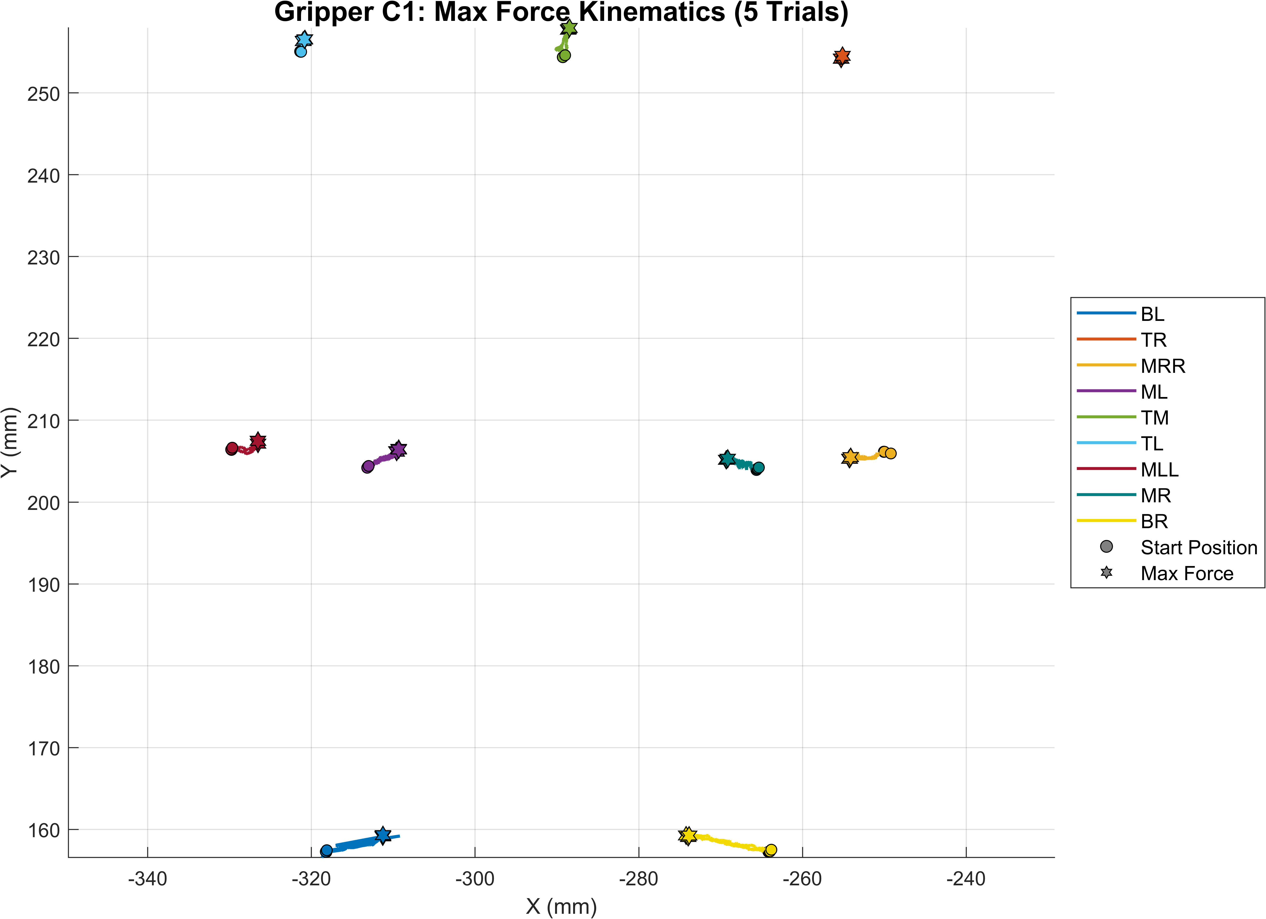
MatLab_Code/TestA/Force/C1_pos.png
