julien-dubuc/Compliant-Gripper-Etextiles/MatLab_Code/TestA/Force/C1_TrialTrend.png

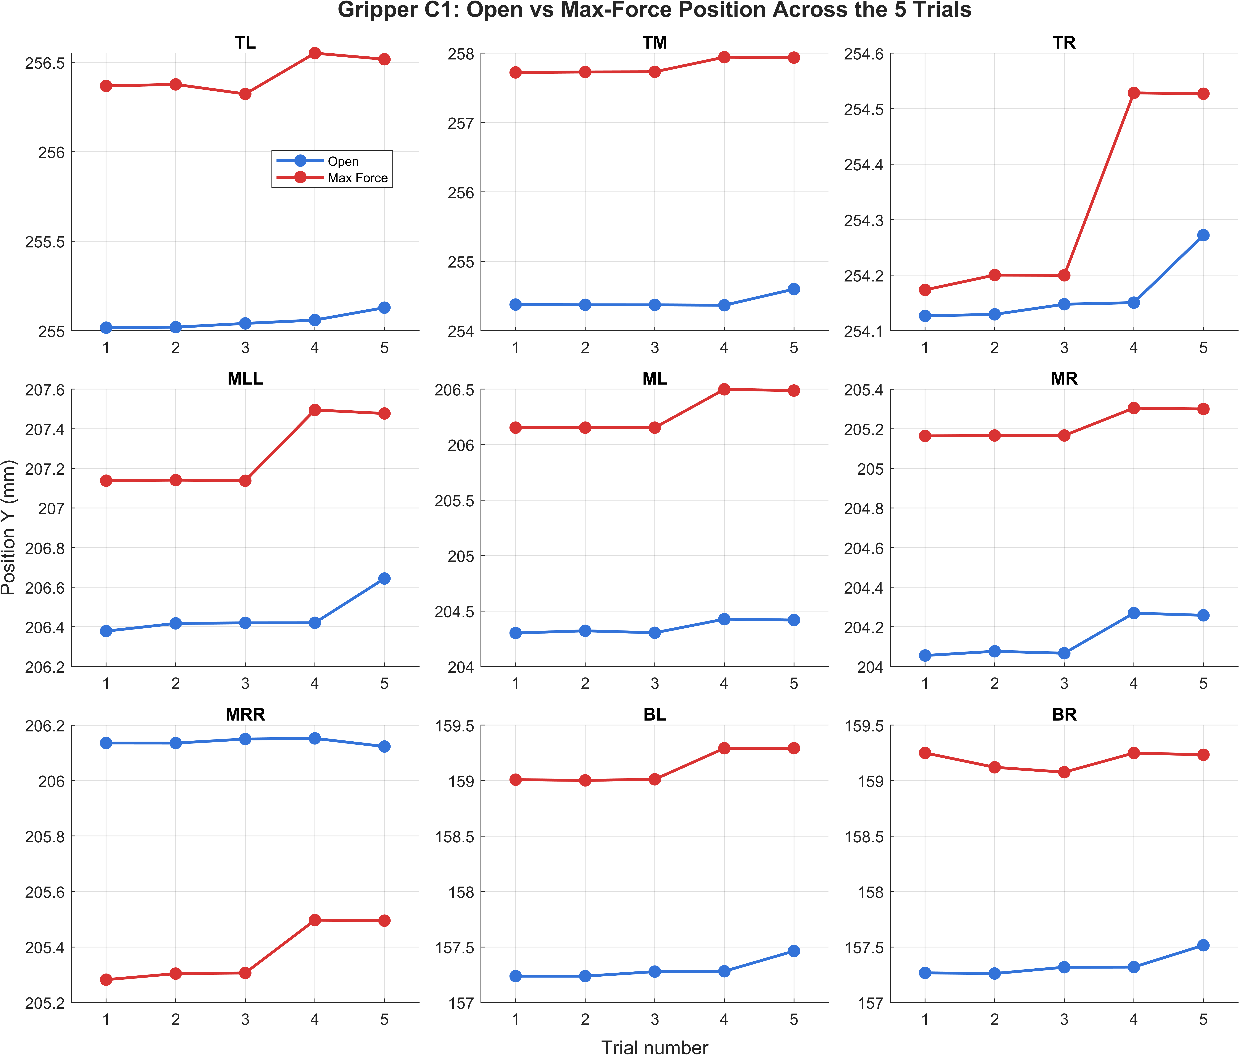
MatLab_Code/TestA/Force/C1_TrialTrend.png
