julien-dubuc/Compliant-Gripper-Etextiles/MatLab_Code/TestA/Force/C1_Y.png

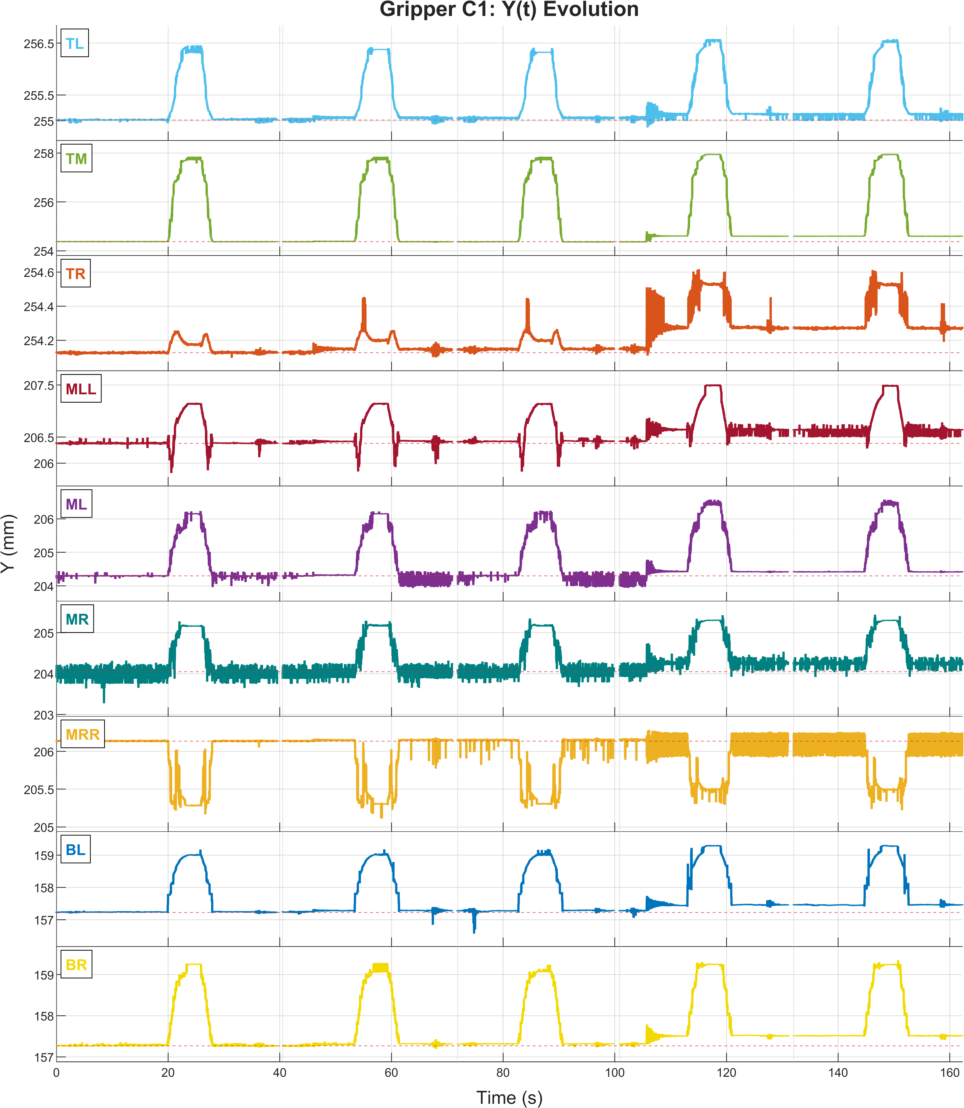
MatLab_Code/TestA/Force/C1_Y.png
