julien-dubuc/Compliant-Gripper-Etextiles/MatLab_Code/TestA/Force/C1C2C3_pos.png

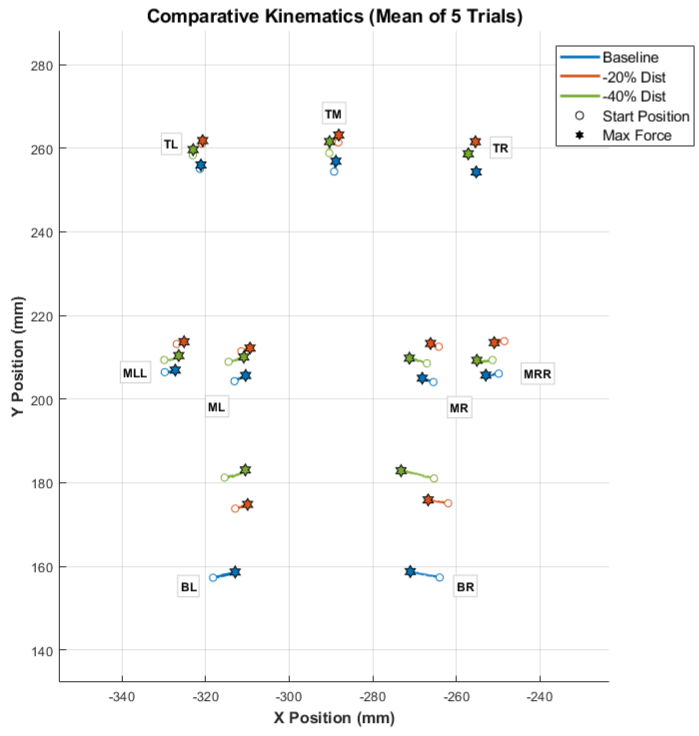
MatLab_Code/TestA/Force/C1C2C3_pos.png
