julien-dubuc/Compliant-Gripper-Etextiles/MatLab_Code/TestA/Force/C2_pos.png

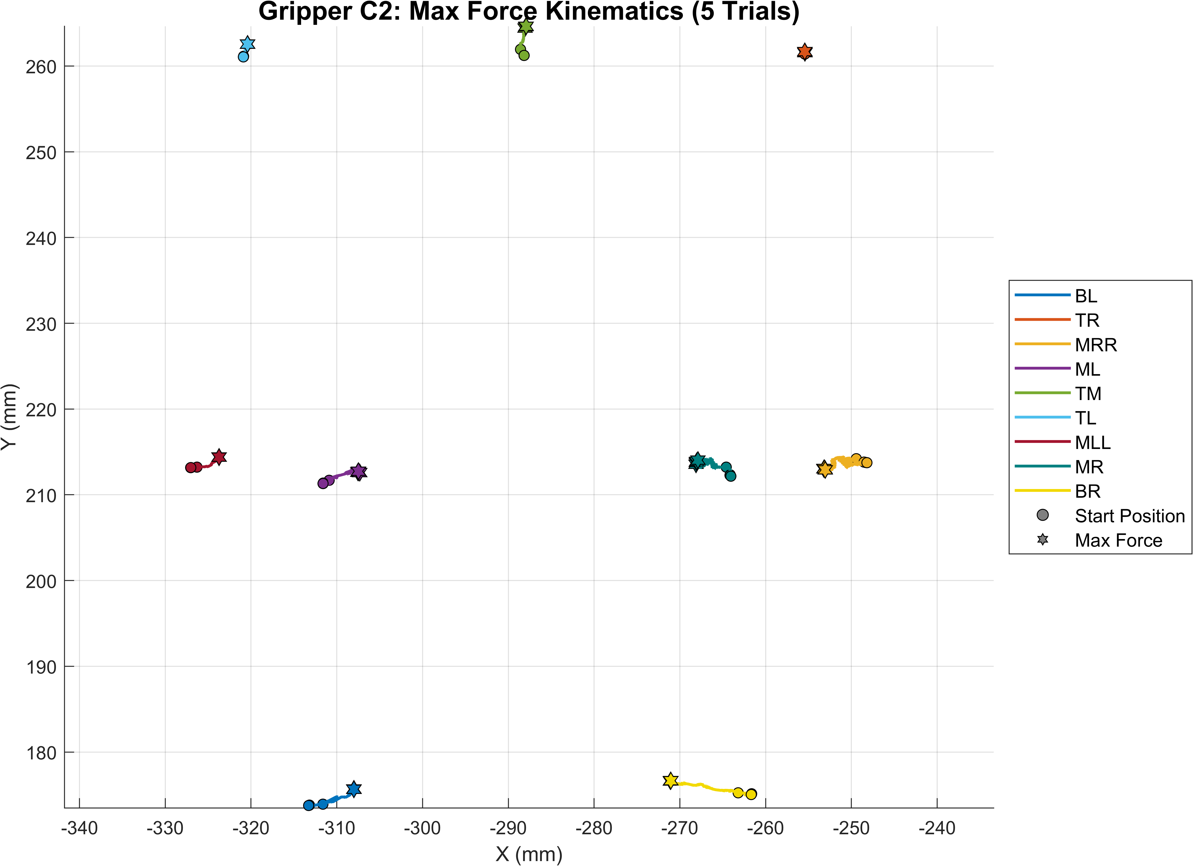
MatLab_Code/TestA/Force/C2_pos.png
