julien-dubuc/Compliant-Gripper-Etextiles/MatLab_Code/TestA/Force/C2_TrialTrend.png

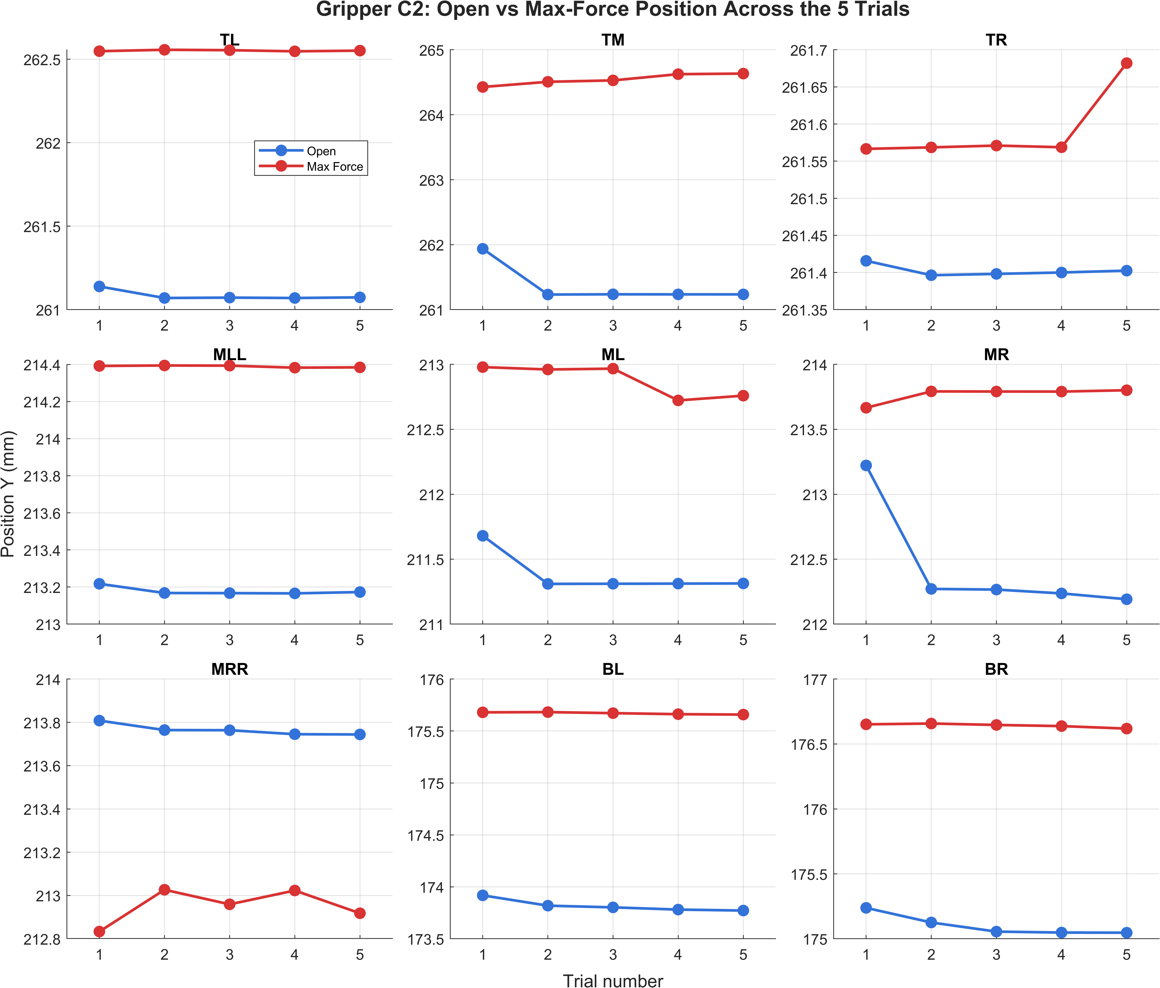
MatLab_Code/TestA/Force/C2_TrialTrend.png
