julien-dubuc/Compliant-Gripper-Etextiles/MatLab_Code/TestA/Force/C2_Y.png

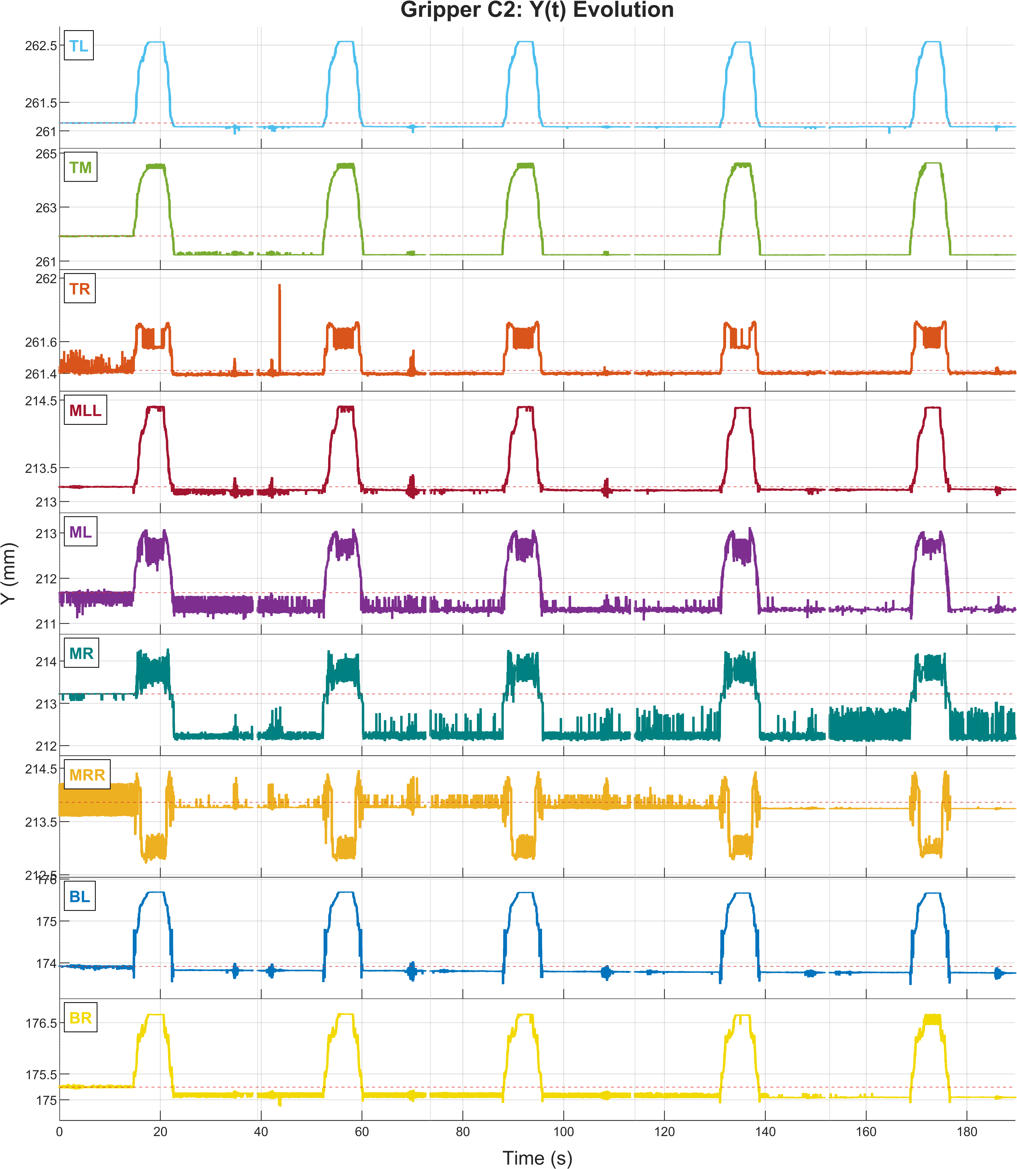
MatLab_Code/TestA/Force/C2_Y.png
