julien-dubuc/Compliant-Gripper-Etextiles/MatLab_Code/TestA/Force/C3_PermanentSet.png

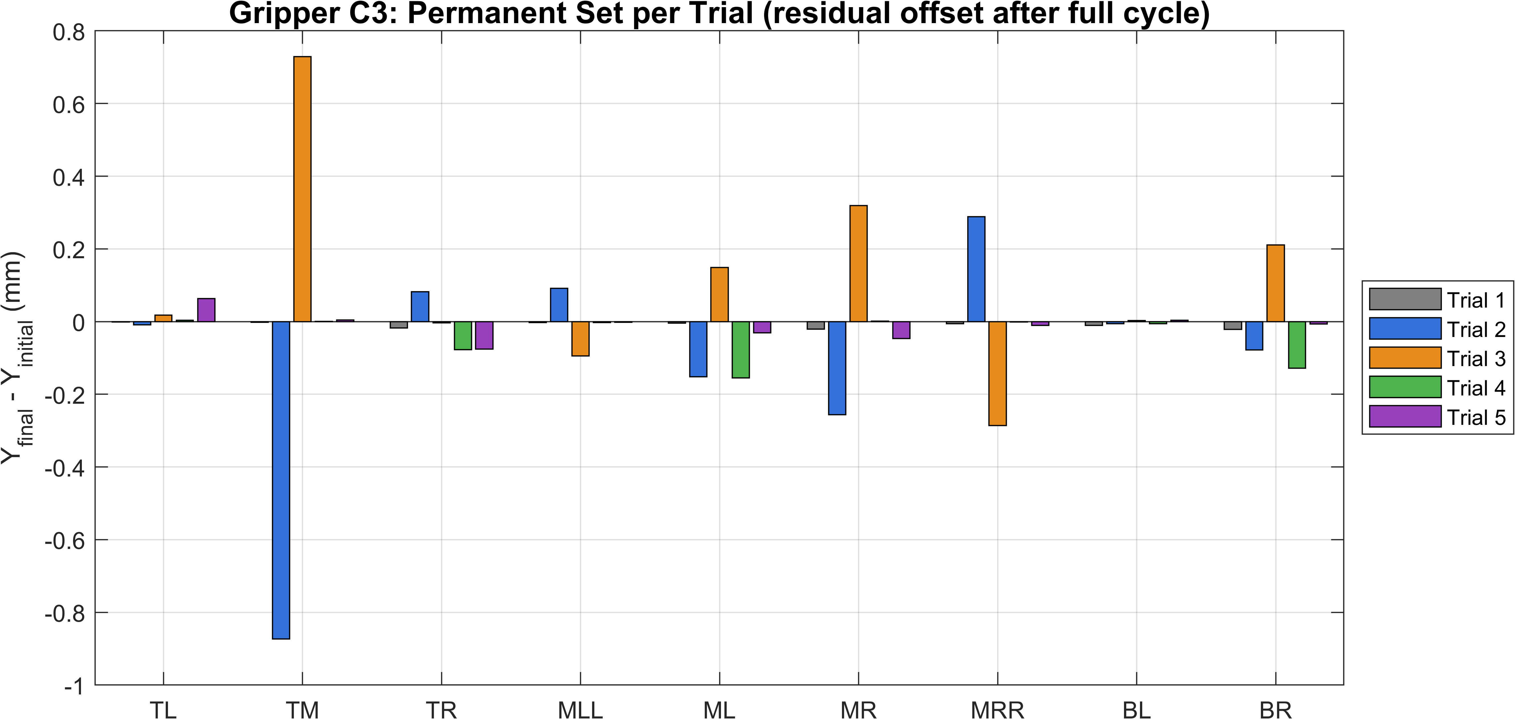
MatLab_Code/TestA/Force/C3_PermanentSet.png
