julien-dubuc/Compliant-Gripper-Etextiles/MatLab_Code/TestA/Force/C3_Y.png

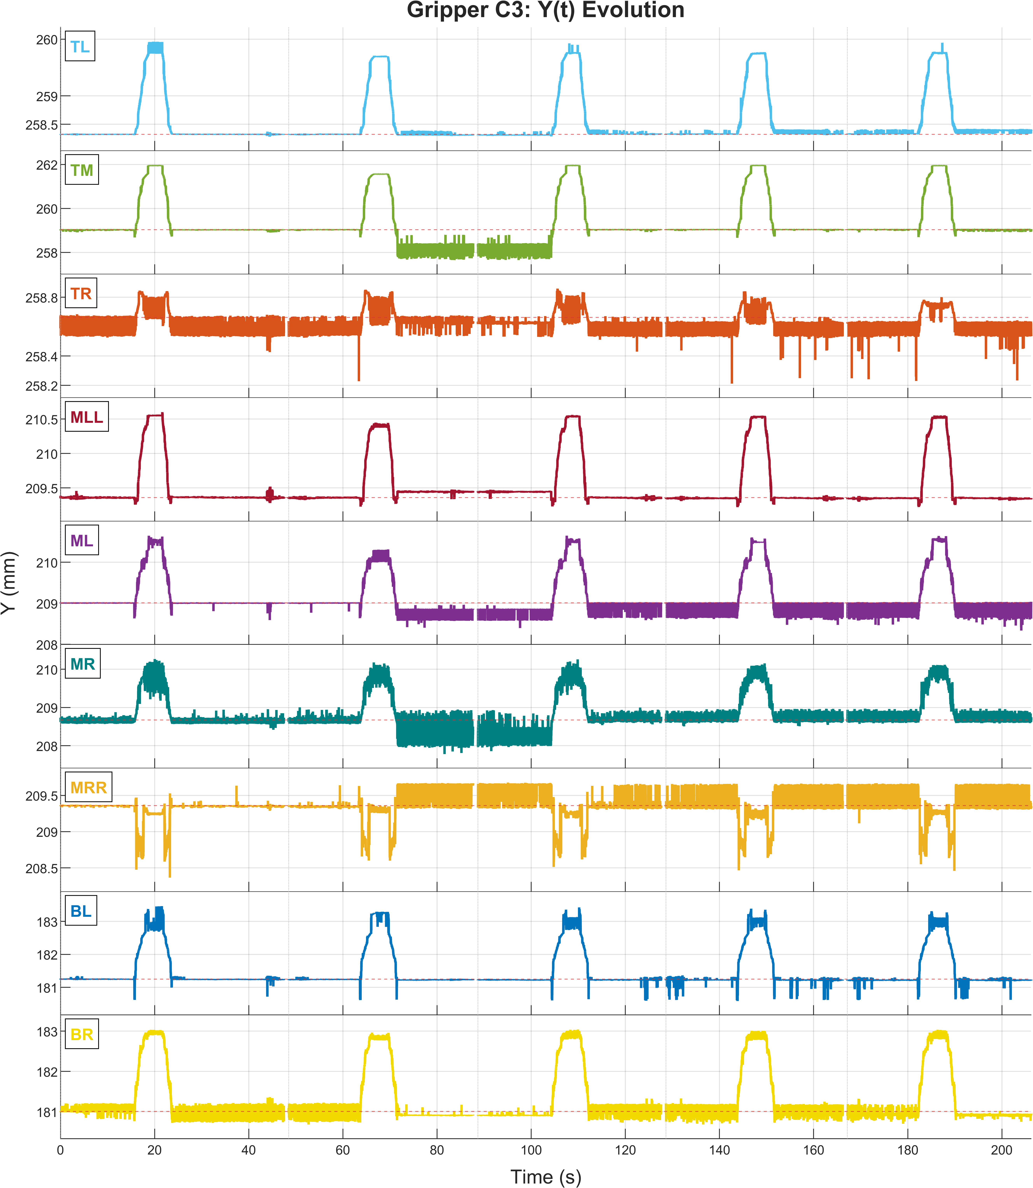
MatLab_Code/TestA/Force/C3_Y.png
