julien-dubuc/Compliant-Gripper-Etextiles/MatLab_Code/TestA/Force/CM_pos.png

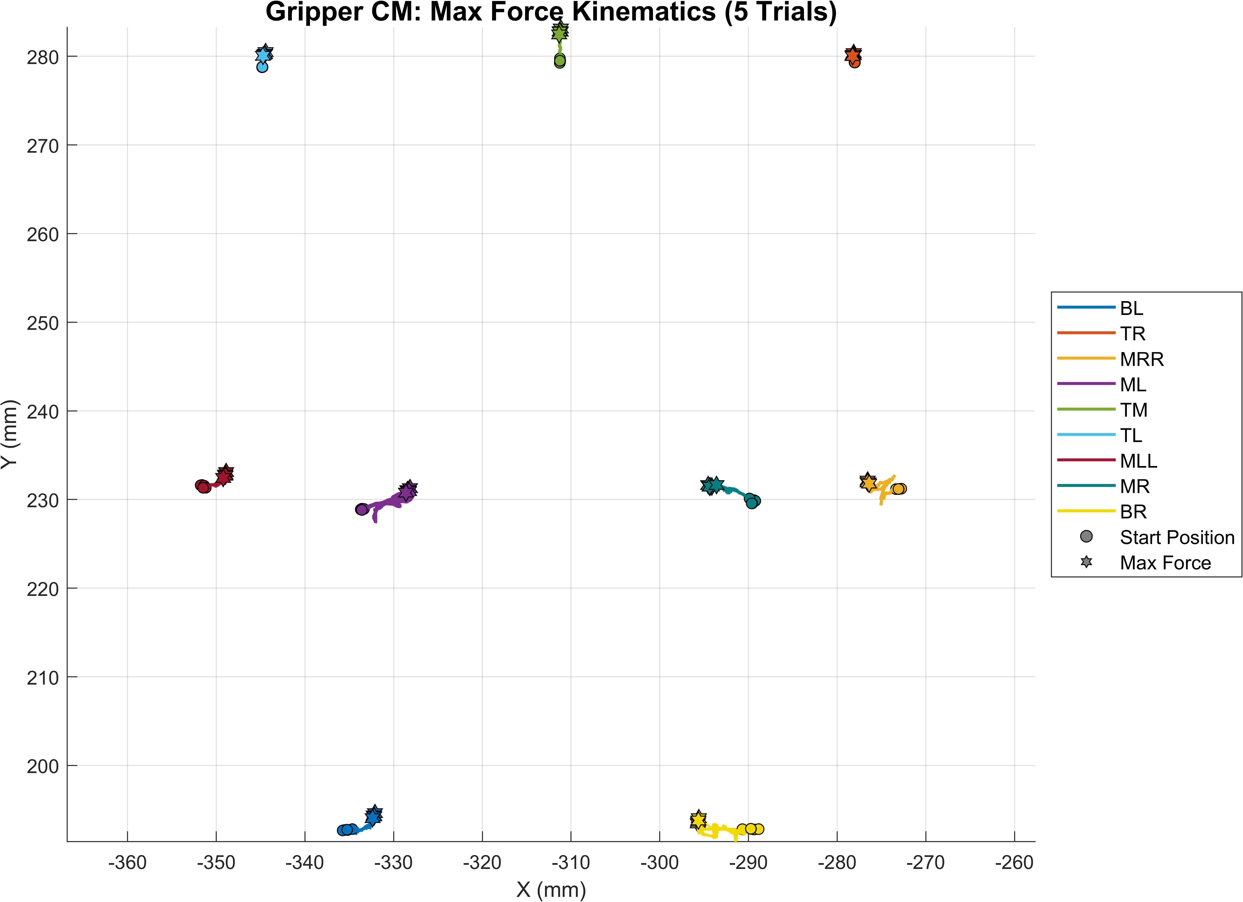
MatLab_Code/TestA/Force/CM_pos.png
