julien-dubuc/Compliant-Gripper-Etextiles/MatLab_Code/TestA/Force/CM_TrialTrend.png

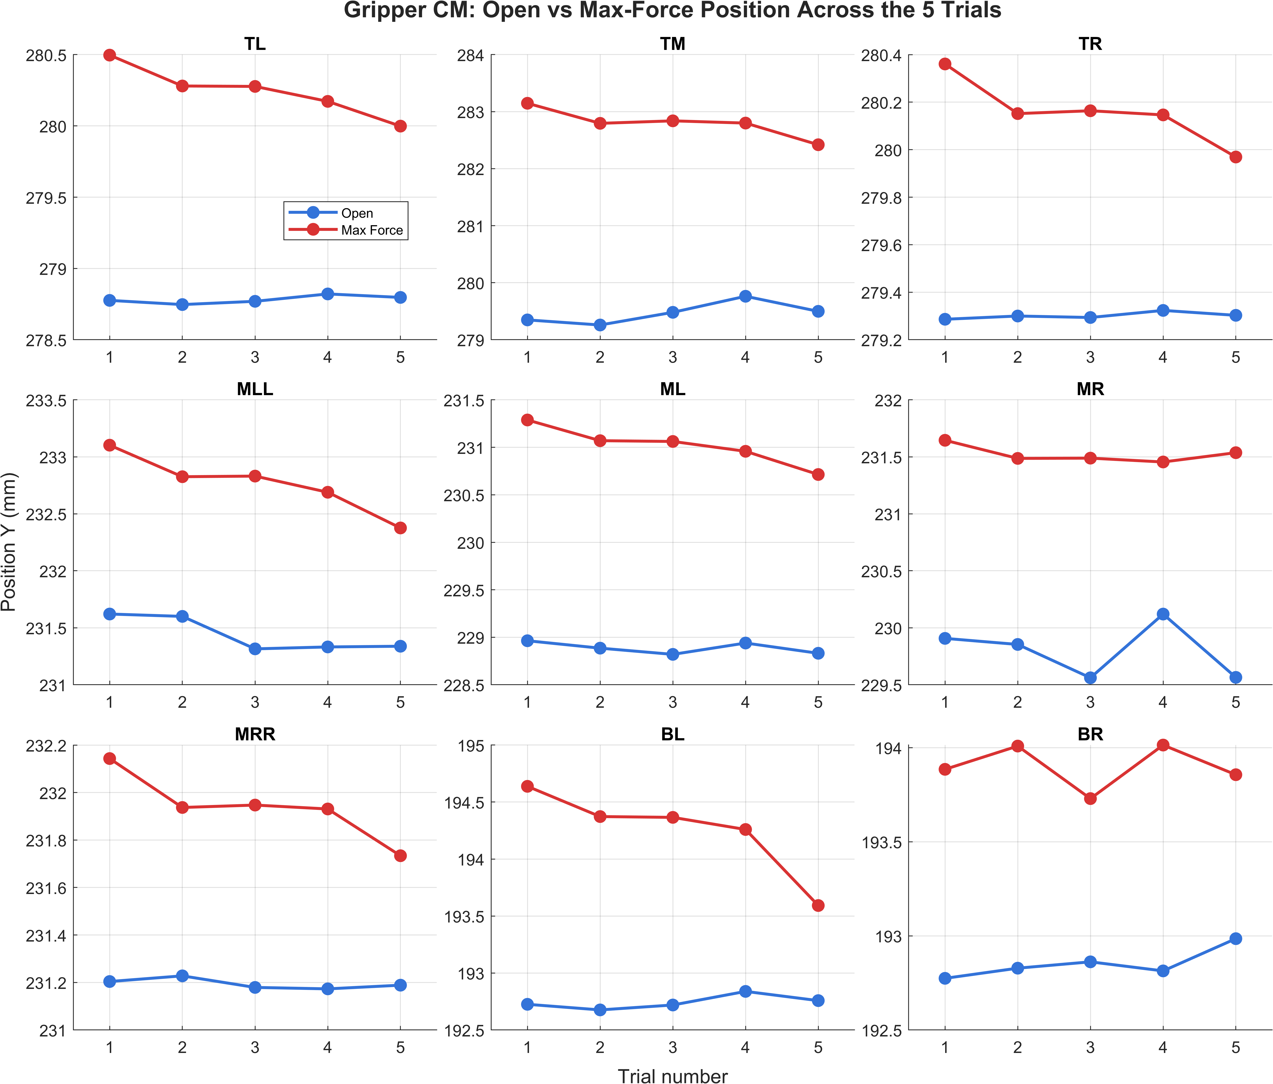
MatLab_Code/TestA/Force/CM_TrialTrend.png
