julien-dubuc/Compliant-Gripper-Etextiles/MatLab_Code/TestA/Force/CM_Y.png

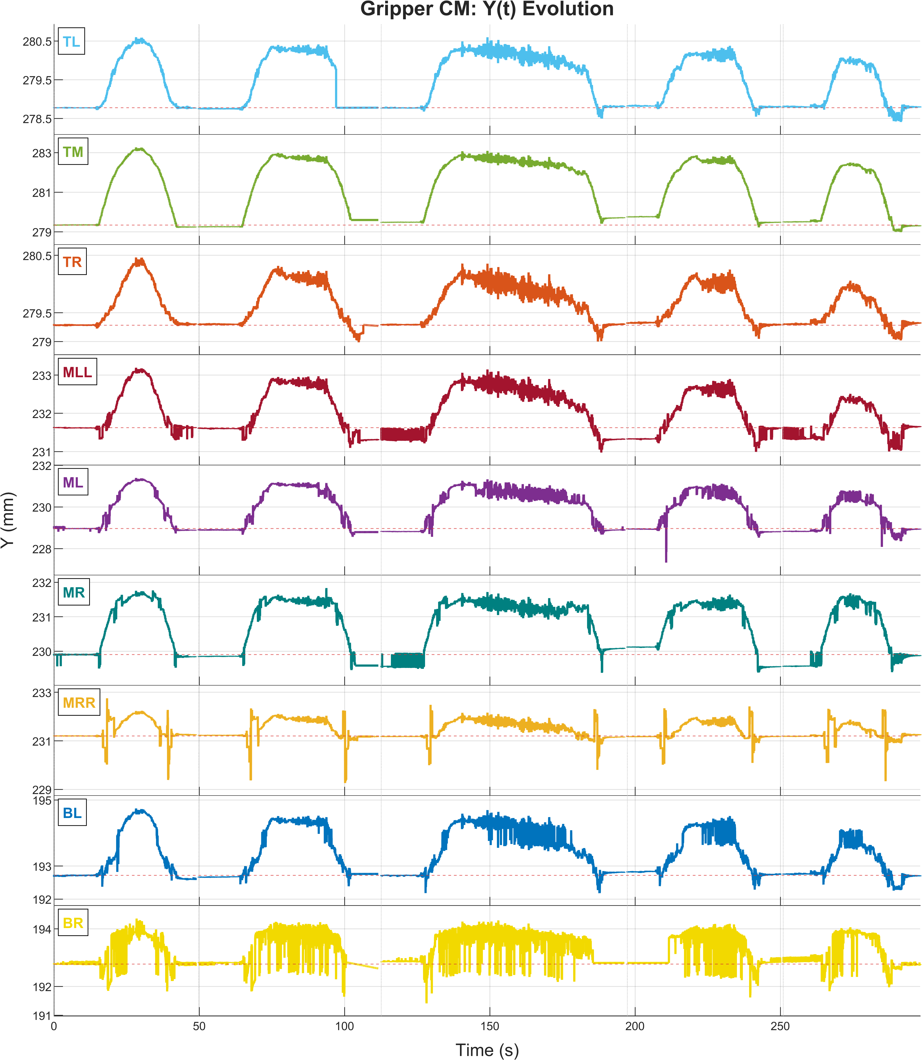
MatLab_Code/TestA/Force/CM_Y.png
