julien-dubuc/Compliant-Gripper-Etextiles/MatLab_Code/TestB/C1_D_Hysteresis.png

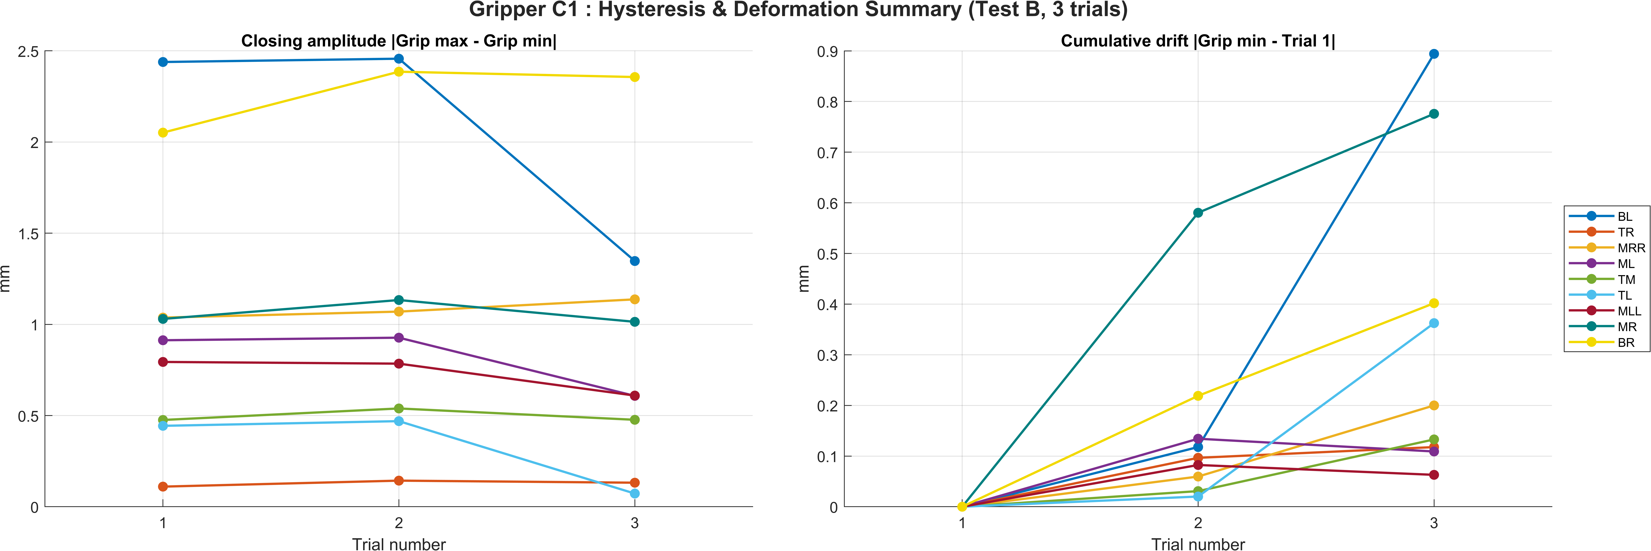
MatLab_Code/TestB/C1_D_Hysteresis.png
