julien-dubuc/Compliant-Gripper-Etextiles/MatLab_Code/TestB/C1_Deformation.png

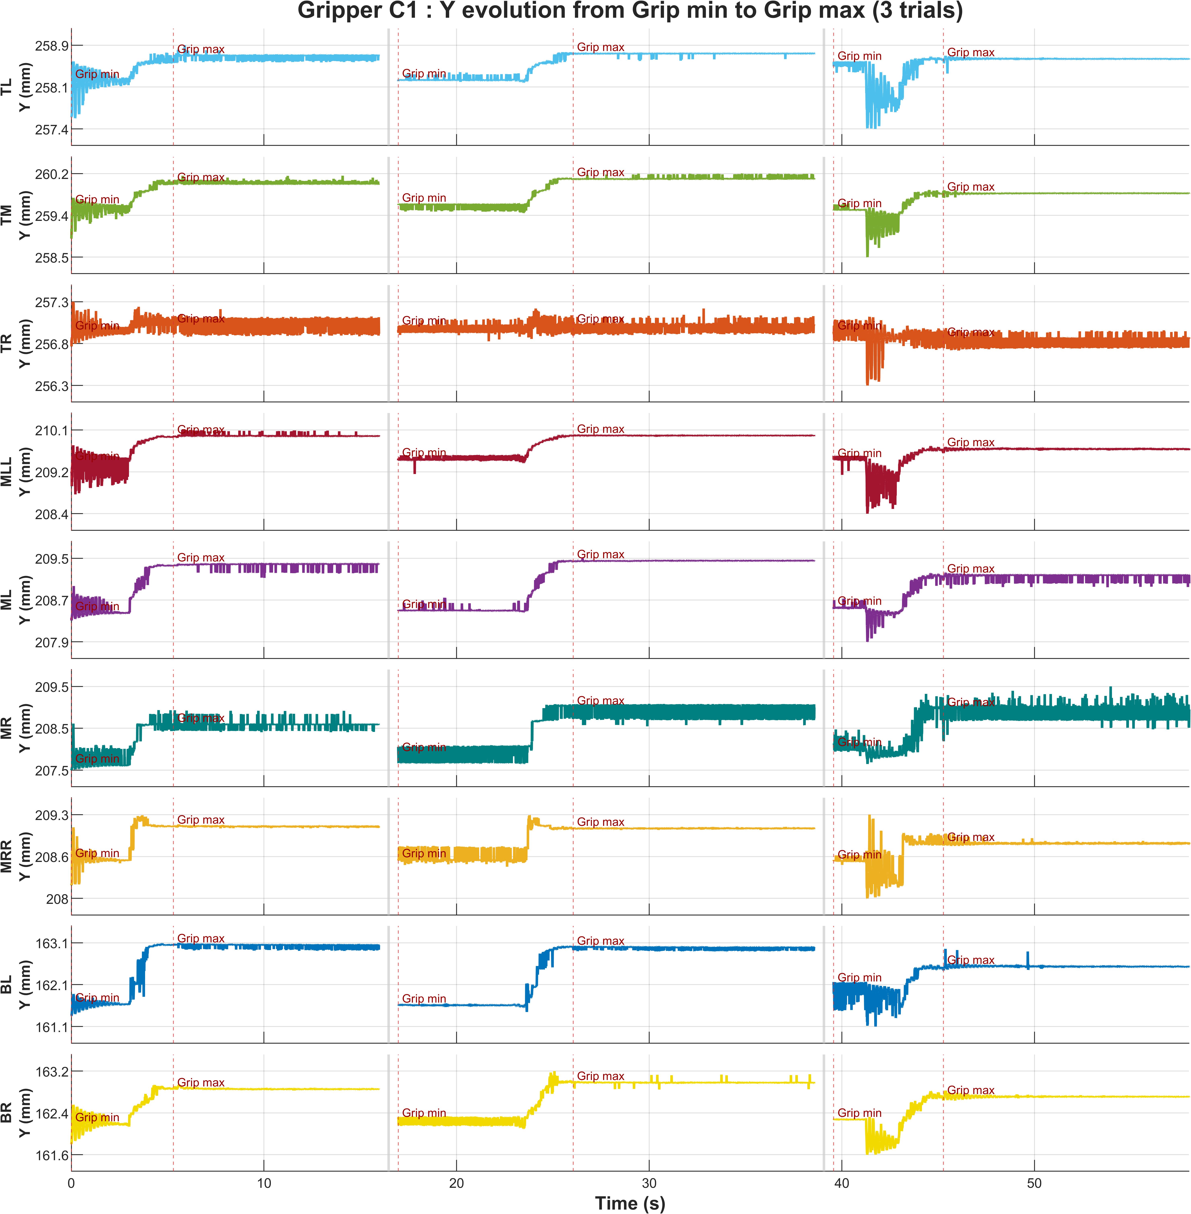
MatLab_Code/TestB/C1_Deformation.png
