julien-dubuc/Compliant-Gripper-Etextiles/MatLab_Code/TestB/C2_D_Hysteresis.png

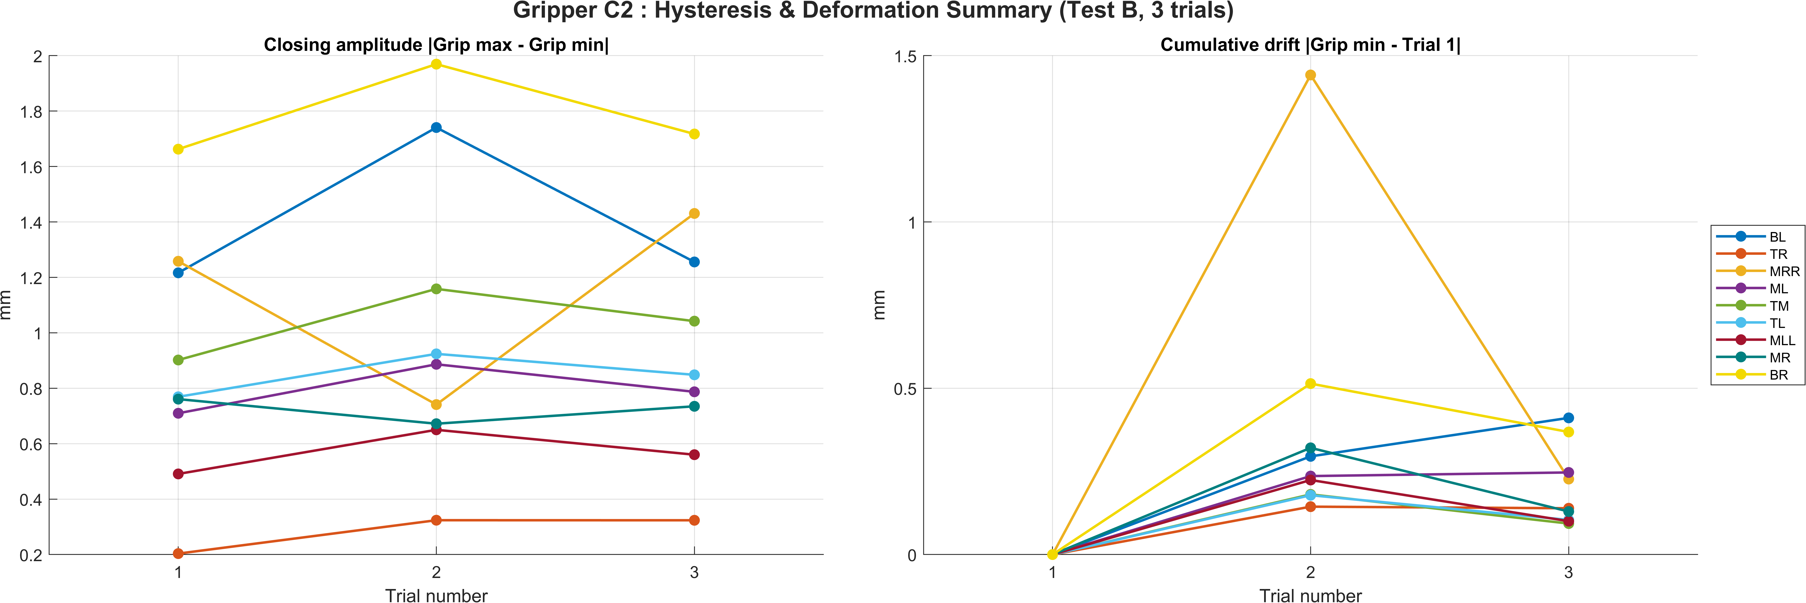
MatLab_Code/TestB/C2_D_Hysteresis.png
