julien-dubuc/Compliant-Gripper-Etextiles/MatLab_Code/TestB/C2_Deformation.png

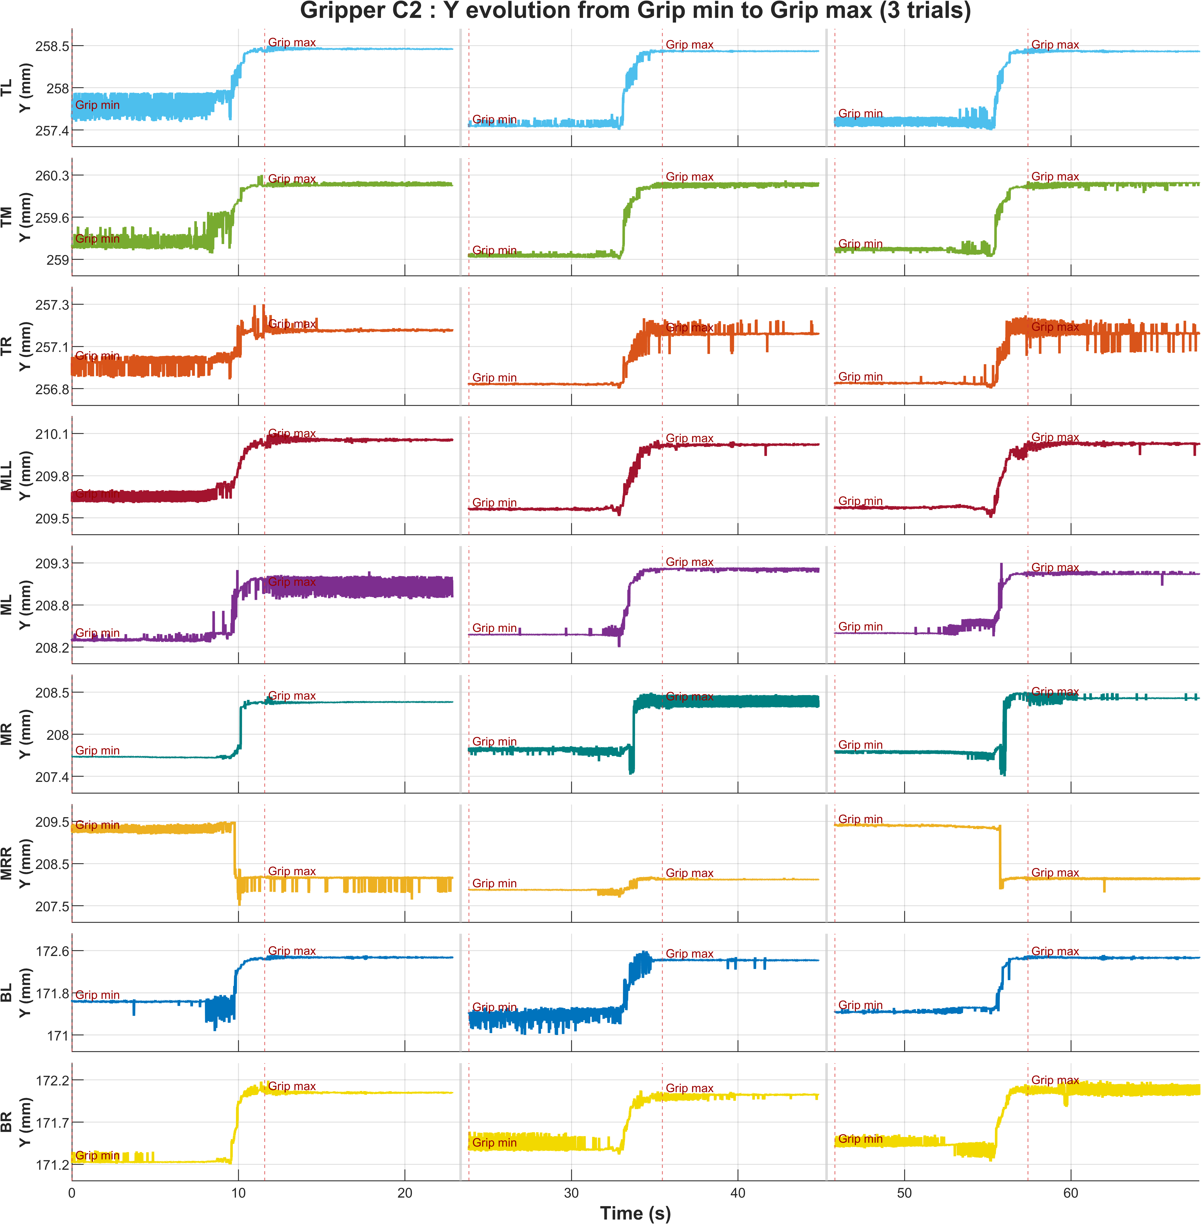
MatLab_Code/TestB/C2_Deformation.png
