julien-dubuc/Compliant-Gripper-Etextiles/MatLab_Code/TestB/C3_Deformation.png

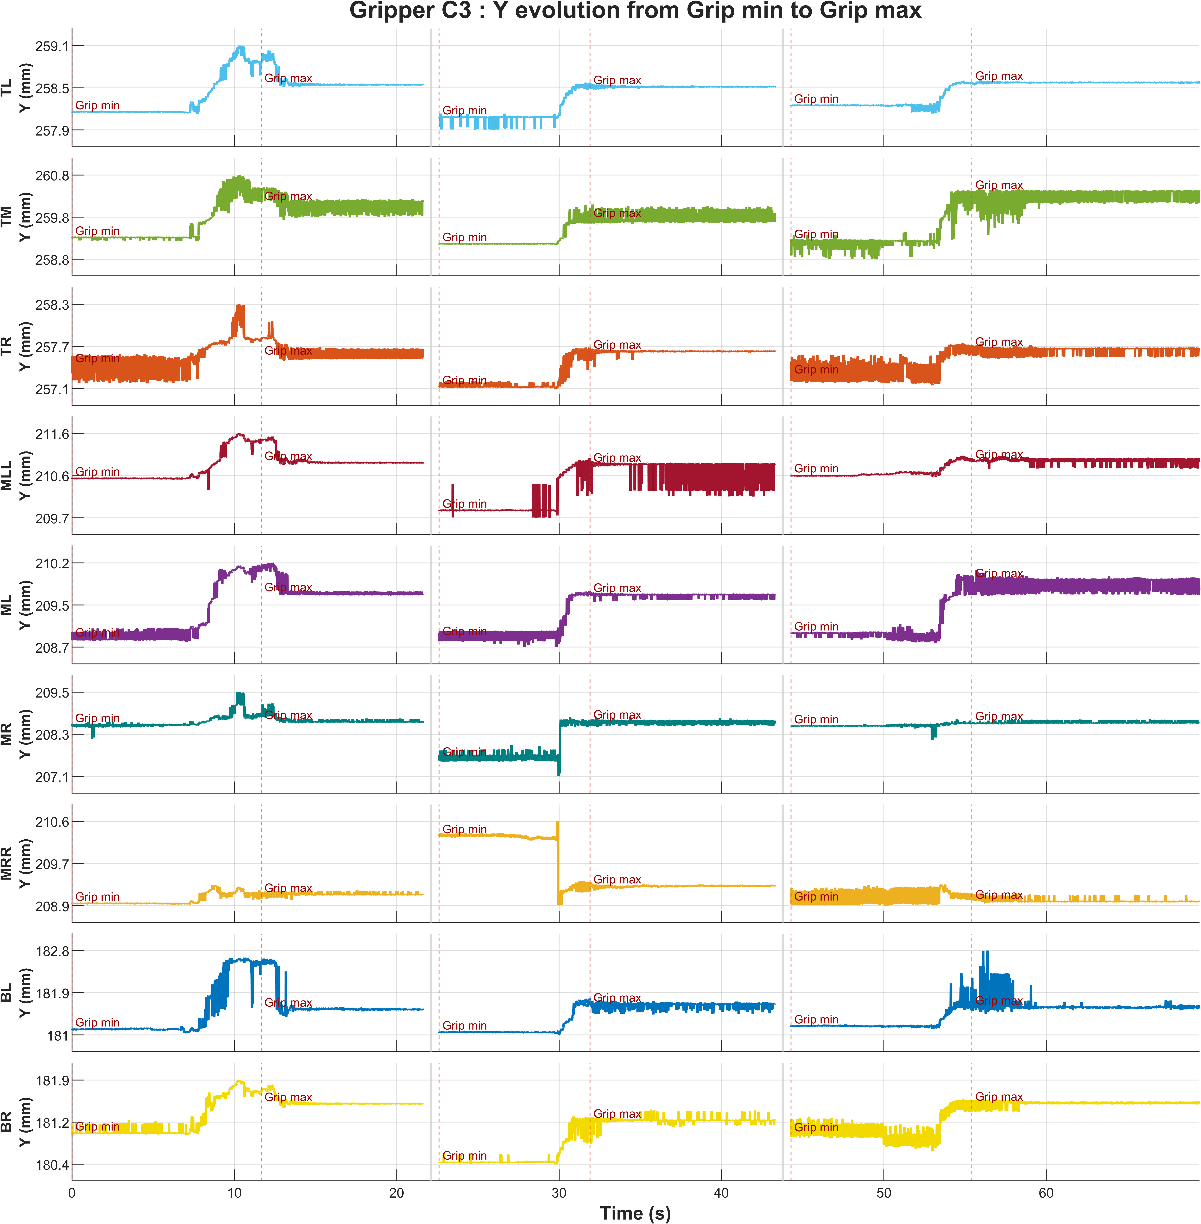
MatLab_Code/TestB/C3_Deformation.png
