julien-dubuc/Compliant-Gripper-Etextiles/MatLab_Code/TestB/CM_D_Hysteresis.png

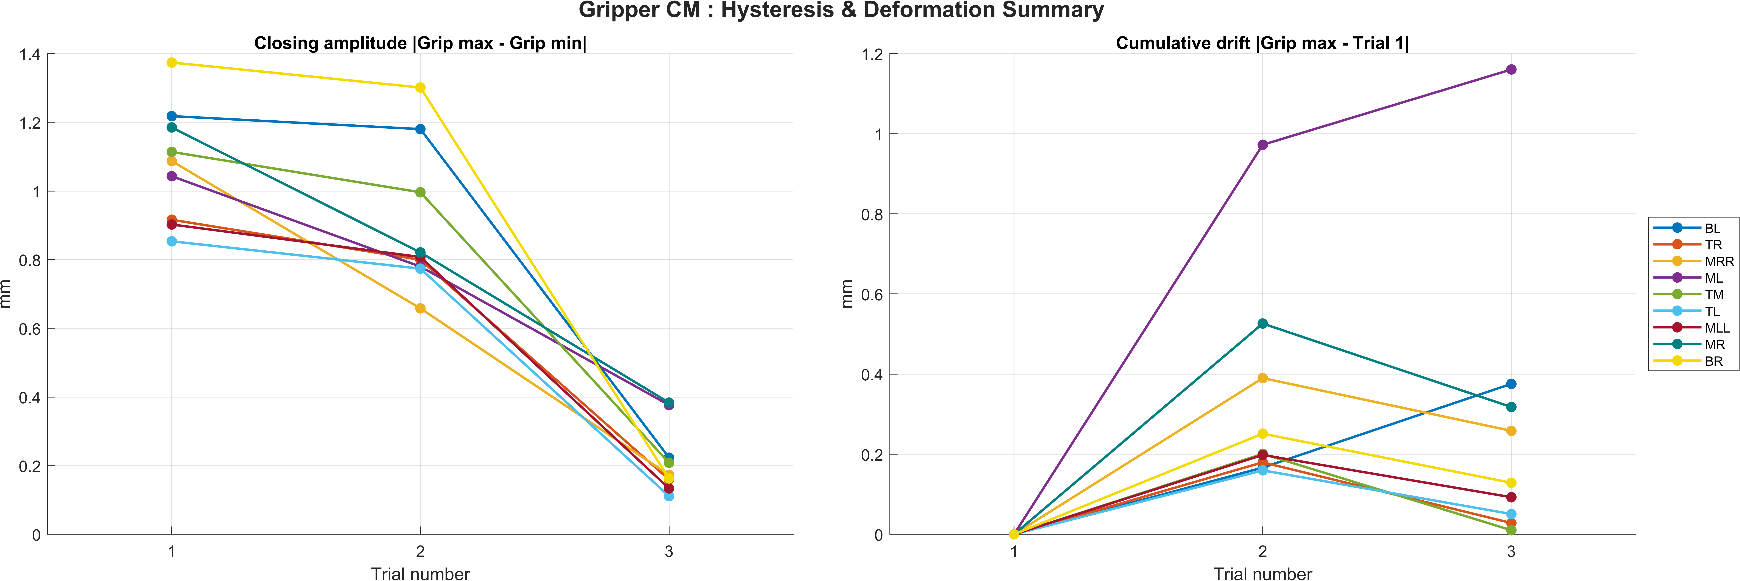
MatLab_Code/TestB/CM_D_Hysteresis.png
