julien-dubuc/Compliant-Gripper-Etextiles/MatLab_Code/TestB/CM_Deformation.png

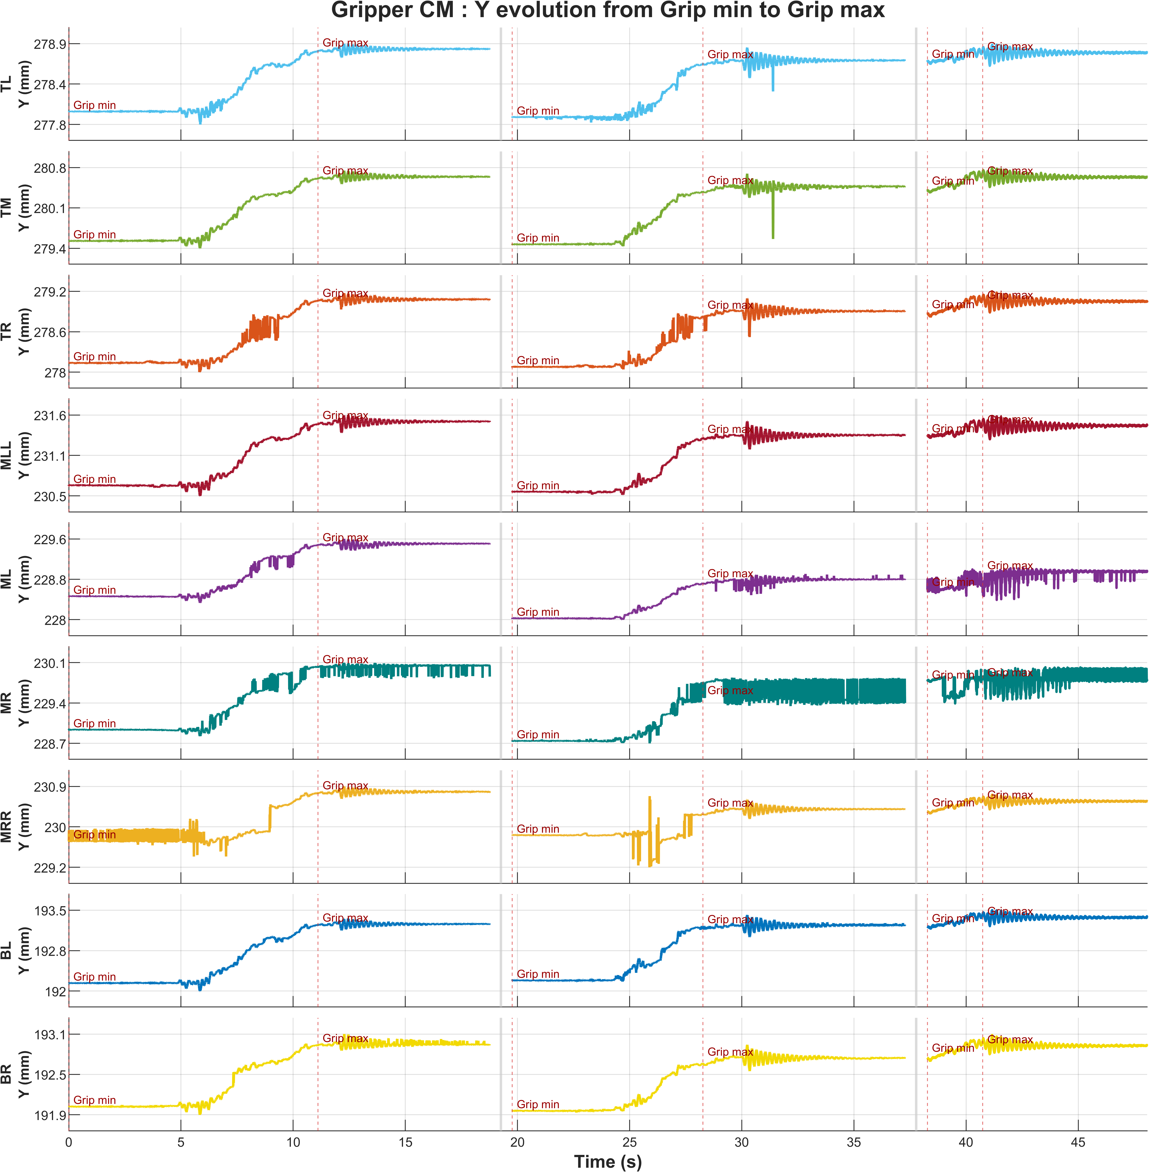
MatLab_Code/TestB/CM_Deformation.png
