julien-dubuc/Compliant-Gripper-Etextiles/MatLab_Code/TestFatigue/fatigue_METAL.jpg

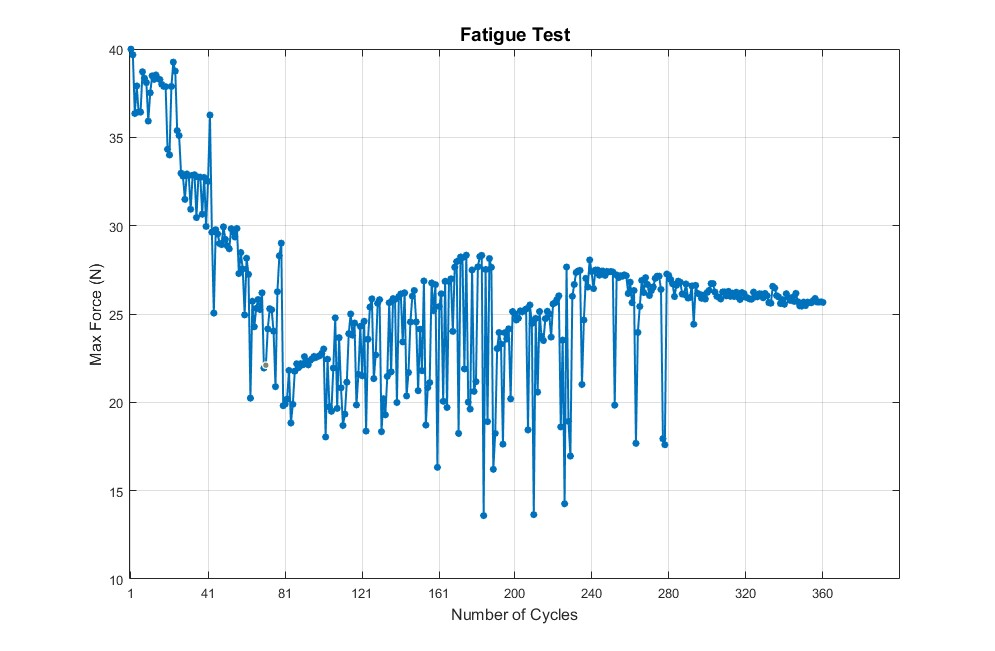
MatLab_Code/TestFatigue/fatigue_METAL.jpg
